Ironman-007/HexSense_Canary_Islands/Docs/images/Canary/WhatsApp Image 2024-02-13 at 19.08.08_4202beaf.jpg

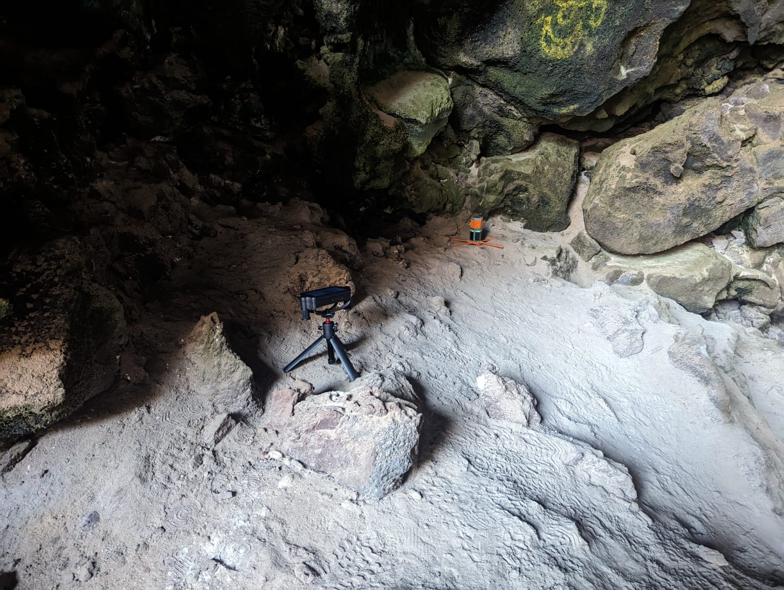
Docs/images/Canary/WhatsApp Image 2024-02-13 at 19.08.08_4202beaf.jpg
