Ironman-007/HexSense_Canary_Islands/Docs/images/Canary/hexsense.jpg

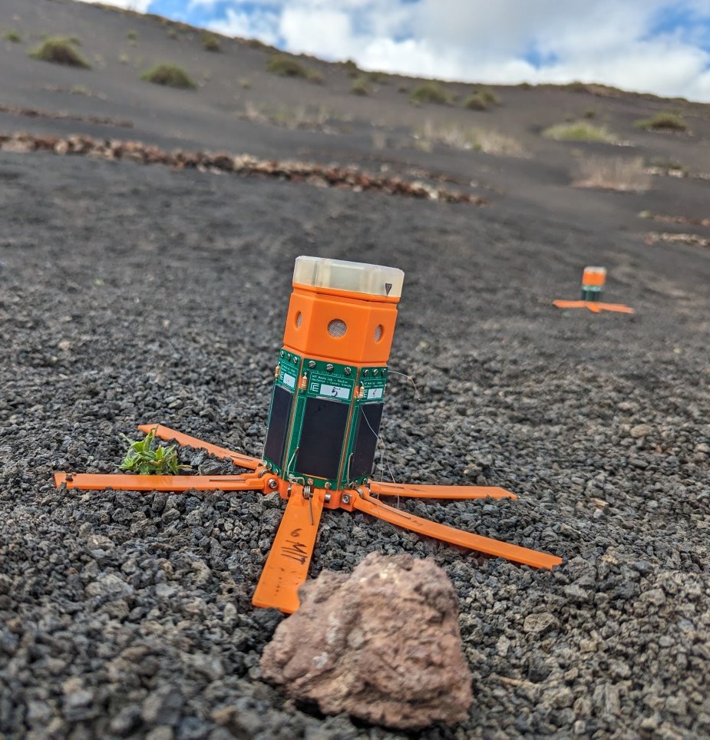
Docs/images/Canary/hexsense.jpg
