Ironman-007/HexSense_Canary_Islands/Docs/images/Canary/WhatsApp Image 2024-02-13 at 19.08.14_1cce6e4d.jpg

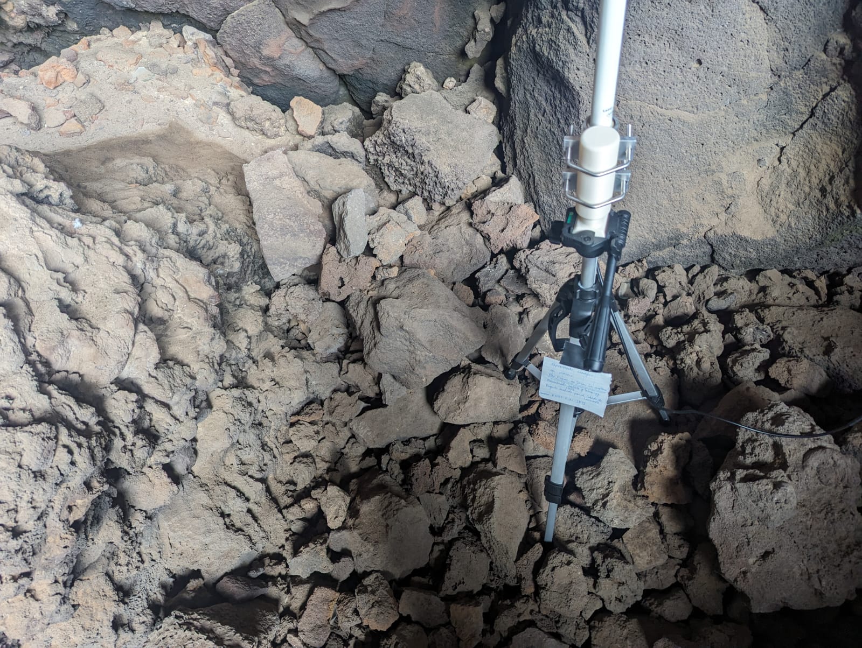
Docs/images/Canary/WhatsApp Image 2024-02-13 at 19.08.14_1cce6e4d.jpg
