Ironman-007/HexSense_Canary_Islands/Software/HEX2JPEG/1.jpg

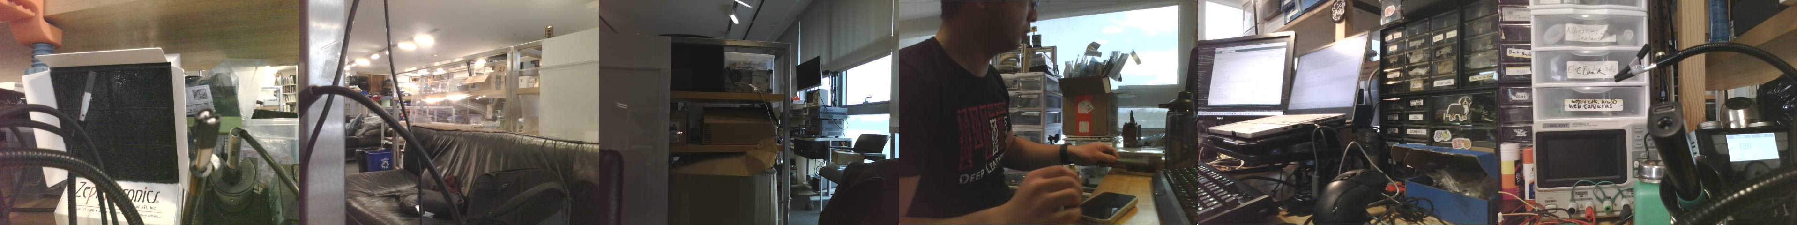
Software/HEX2JPEG/1.jpg
