Ironman-007/HexSense_Canary_Islands/Software/HEX2JPEG/me.jpg

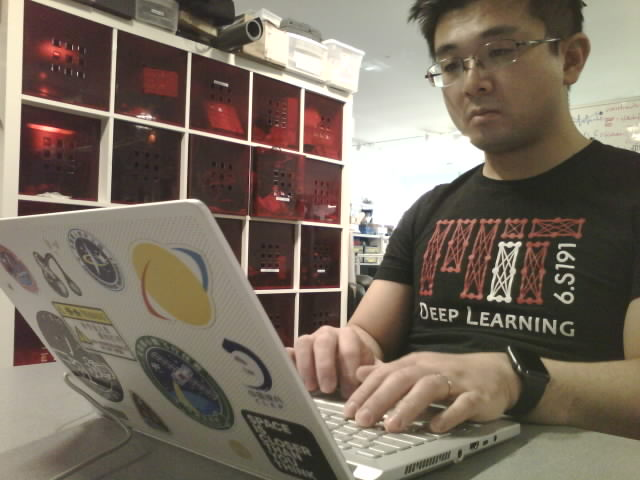
Software/HEX2JPEG/me.jpg
