Ironman-007/HexSense_Canary_Islands/Software/HEX2JPEG/output.jpg

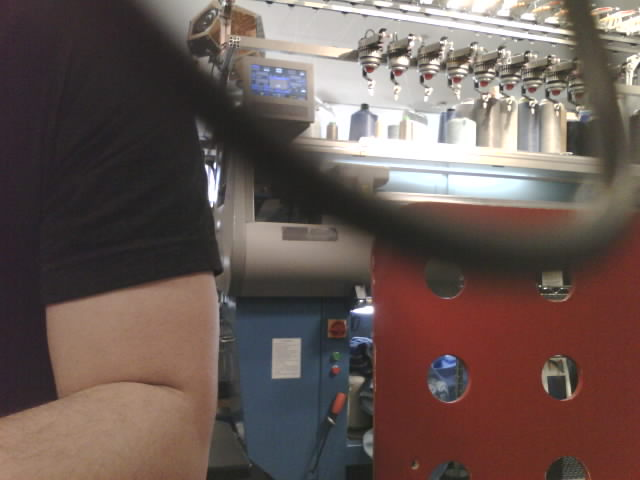
Software/HEX2JPEG/output.jpg
