Ironman-007/HexSense_Canary_Islands/Software/HEX2JPEG/tst.jpg

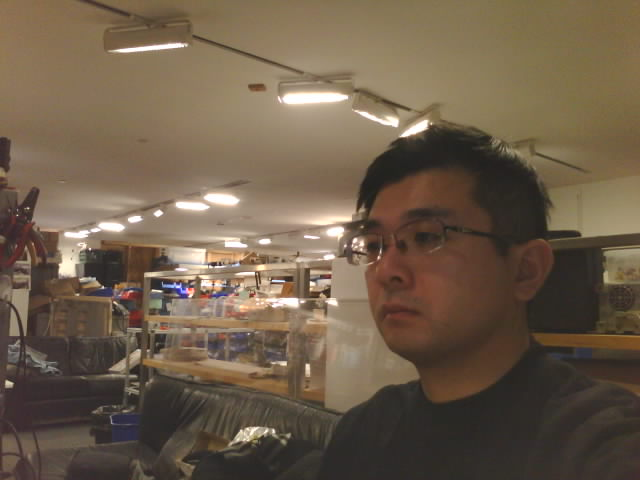
Software/HEX2JPEG/tst.jpg
