Ironman-007/HexSense_Canary_Islands/Software/HEX2JPEG/tst_photo/02.jpg

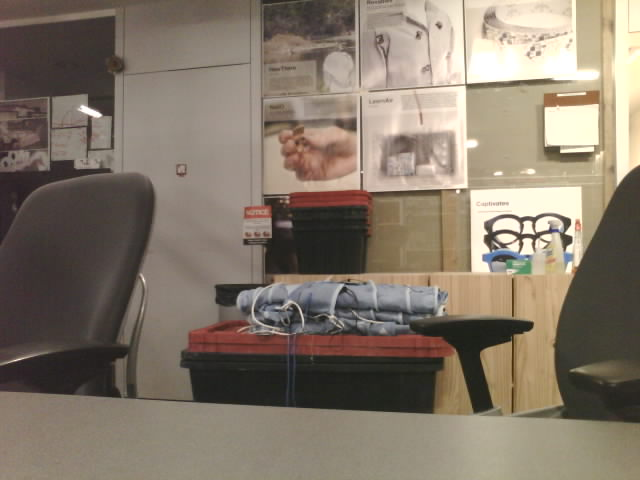
Software/HEX2JPEG/tst_photo/02.jpg
