Ironman-007/HexSense_Canary_Islands/Software/HEX2JPEG/tst_photo/03.jpg

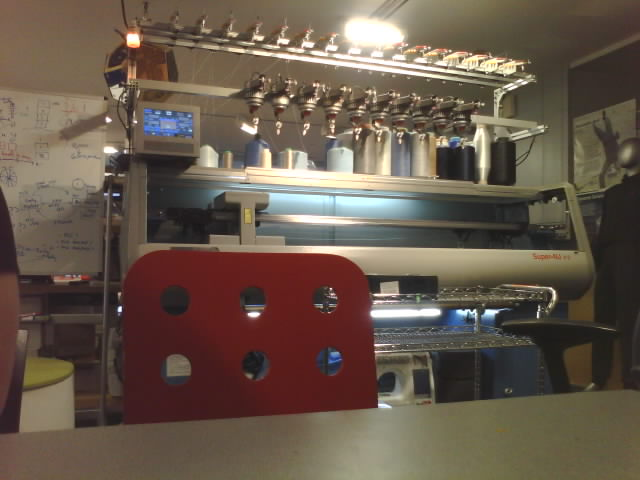
Software/HEX2JPEG/tst_photo/03.jpg
