Ironman-007/HexSense_Canary_Islands/Mechanical/Base/V1/Bottom_panel.STEP

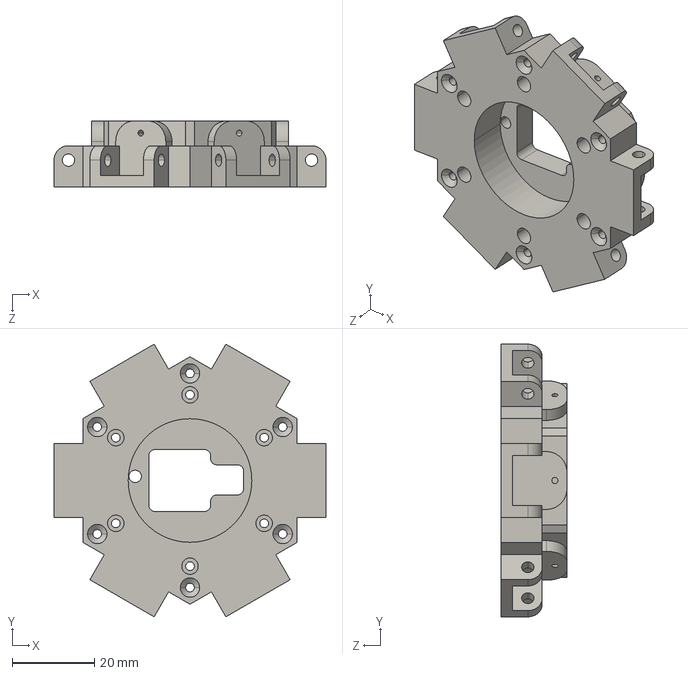
[picture p26: CAD file, 2024-01-19]
Mechanical/Base/V1/Bottom_panel.STEP
66.0 x 66.2 x 16.0 mm
