Ironman-007/HexSense_Canary_Islands/Mechanical/Base/V1/STL/base.stl

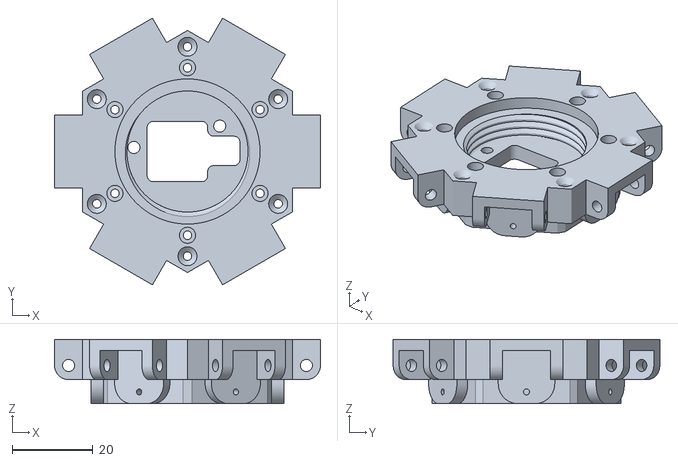
[picture p27: CAD file, 2024-01-26]
Mechanical/Base/V1/STL/base.stl
66.0 x 66.2 x 16.0
