Ironman-007/HexSense_Canary_Islands/Mechanical/Camera_module/camera_case_hexsense.stl

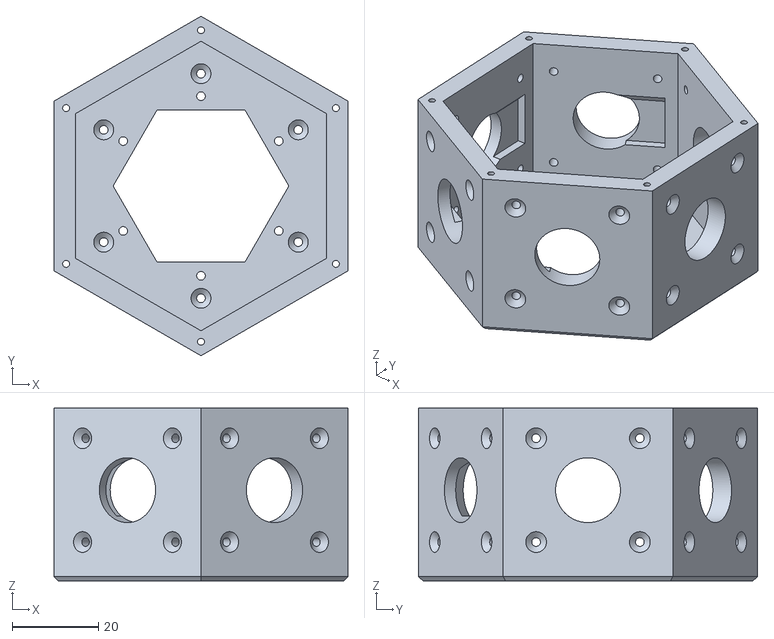
[picture p28: CAD file, 2024-01-22]
Mechanical/Camera_module/camera_case_hexsense.stl
68.0 x 78.5 x 40.0
