Ironman-007/HexSense_Canary_Islands/Mechanical/Env_module/SCD30--3DModel-STEP-56544.STEP

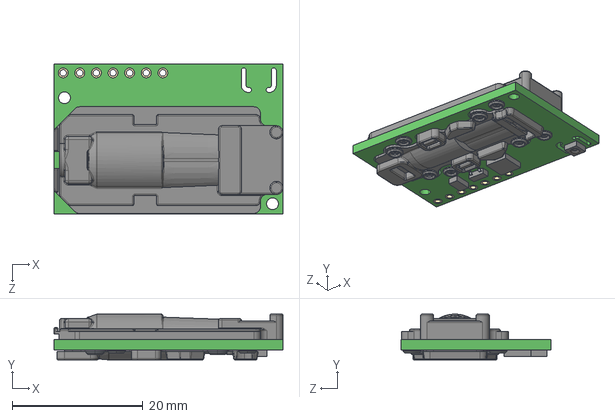
[picture p29: CAD file, 2024-02-02]
Mechanical/Env_module/SCD30--3DModel-STEP-56544.STEP
35.0 x 7.00 x 23.0 mm
