Ironman-007/HexSense_Canary_Islands/Mechanical/STL/3MF/camera_frame_lid.3mf

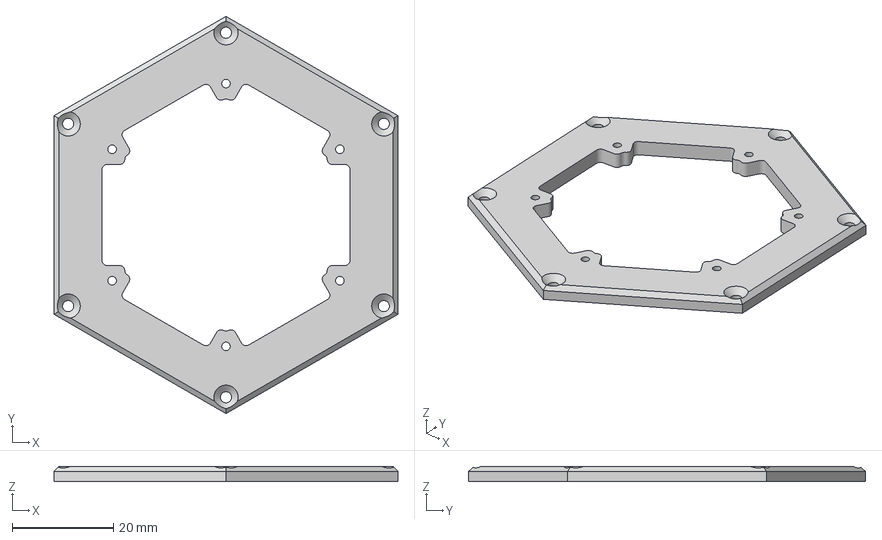
[picture p30: CAD file, 2024-05-07]
Mechanical/STL/3MF/camera_frame_lid.3mf
68.0 x 78.5 x 3.00 mm
