Ironman-007/HexSense_Canary_Islands/Mechanical/STL/insertholder.stl

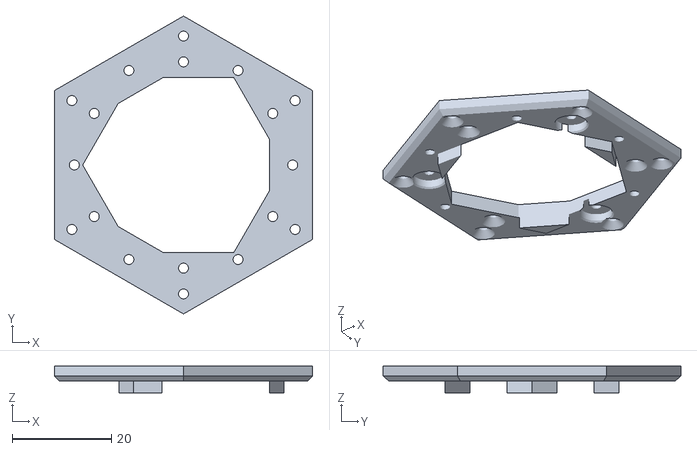
[picture p31: CAD file, 2025-03-31]
Mechanical/STL/insertholder.stl
52.0 x 60.0 x 5.40
