Ironman-007/HexSense_Canary_Islands/PCB/CAMERA_ADAPTER/CAMERA_ADAPTER.step

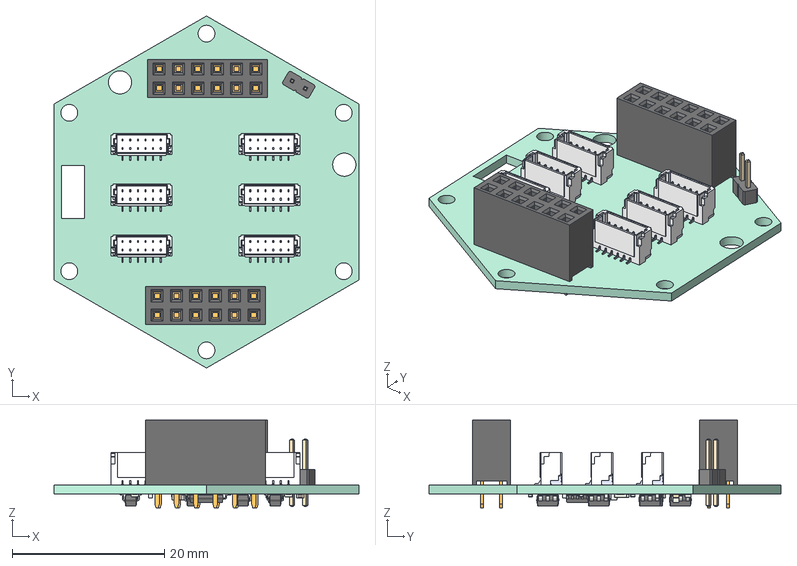
[picture p32: CAD file, 2024-01-24]
PCB/CAMERA_ADAPTER/CAMERA_ADAPTER.step
40.0 x 46.2 x 11.5 mm
Local_CS_efd9
Pcb_efd9
PCB_Sketch_efd9
BMxxB-SRSS-TB(LF)(SN)_06 x 6
BMxxB-SRSS-TB(LF)(SN)_007 x 6
BMxxB-SRSS-TB(LF)(SN)_008 x 6
BMxxB-SRSS-TB(LF)(SN)_009 x 6
BMxxB-SRSS-TB(LF)(SN)_010 x 6
BMxxB-SRSS-TB(LF)(SN)_011 x 6
BMxxB-SRSS-TB(LF)(SN)_012 x 6
BMxxB-SRSS-TB(LF)(SN)_013 x 6
BMxxB-SRSS-TB(LF)(SN)_014 x 6
BMxxB-SRSS-TB(LF)(SN)_015 x 6
BMxxB-SRSS-TB(LF)(SN)_016 x 6
BMxxB-SRSS-TB(LF)(SN)_017 x 6
BMxxB-SRSS-TB(LF)(SN)_018 x 6
BMxxB-SRSS-TB(LF)(SN)_019 x 6
BMxxB-SRSS-TB(LF)(SN)_020 x 6
BMxxB-SRSS-TB(LF)(SN)_021 x 6
BMxxB-SRSS-TB(LF)(SN)_022 x 6
BMxxB-SRSS-TB(LF)(SN)_023 x 6
BMxxB-SRSS-TB(LF)(SN)_024 x 6
BMxxB-SRSS-TB(LF)(SN)_025 x 6
BMxxB-SRSS-TB(LF)(SN)_026 x 6
J1_ZL262-12D_P2-54_L15-74_W5_H8-5_6bbc479e31c9 x 2
J9_PinHeader_1x02_P200mm_Vertical_a4282987b0e2
R10_R_0402_1005Metric_74f1f346494a x 7
D1_LED_0603_1608Metric_ddd619ef1d35
U4_SOT_23_5_20c4610e354d x 8
C9_C_0402_1005Metric_d579c78d45ee x 7
R1_R_0603_1608Metric_368b4ec6add9 x 4
U2_TSSOP_16_44x5mm_P065mm_39492d668841
C1_C_0603_1608Metric_cccacc02c318 x 2
