Ironman-007/HexSense_Canary_Islands/PCB/LORA/LORA.step

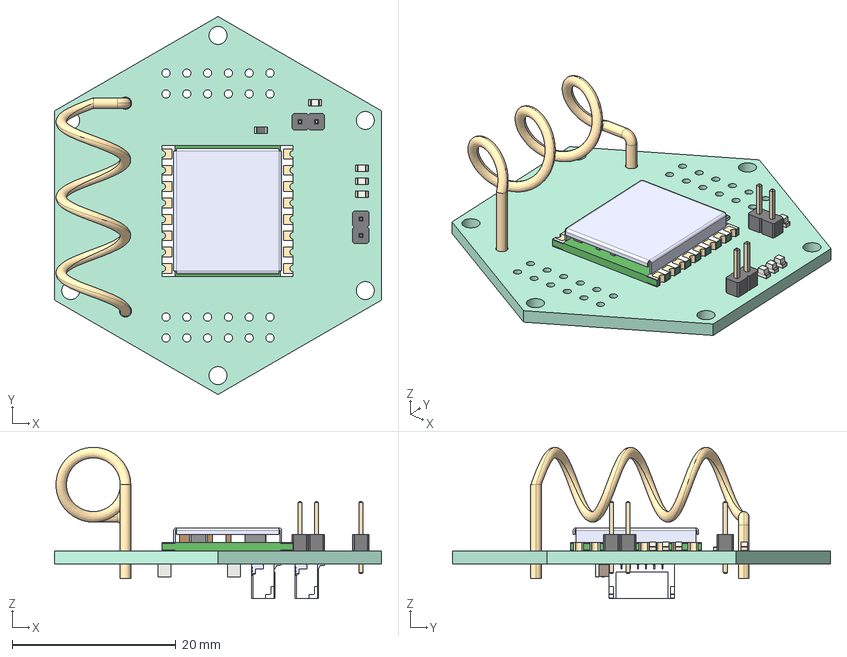
[picture p33: CAD file, 2024-02-02]
PCB/LORA/LORA.step
40.0 x 46.2 x 18.5 mm
Local_CS_200a
Pcb_200a
PCB_Sketch_200a
D2_LED_0603_1608Metric_a726e19f2e95 x 4
U2_ANT-916-HESM_a0ccab9f46fa
J5_PinHeader_1x02_P200mm_Vertical_732df0b8f1e6 x 2
R3_R_0603_1608Metric_ca6557afc463
RFM95CW
RFM95CW001
RFM95CW002
RFM95CW003
RFM95CW004
RFM95CW005
RFM95CW006
RFM95CW007
RFM95CW008
RFM95CW009
RFM95CW010
RFM95CW011
RFM95CW012
RFM95CW013
RFM95CW014
RFM95CW015
RFM95CW016
RFM95CW017
RFM95CW018
RFM95CW019
RFM95CW020
RFM95CW021
RFM95CW022
RFM95CW023
RFM95CW024
RFM95CW025
RFM95CW026
RFM95CW027
RFM95CW028
RFM95CW029
RFM95CW030
RFM95CW031
BMxxB-SRSS-TB(LF)(SN)_06 x 2
BMxxB-SRSS-TB(LF)(SN)_007 x 2
BMxxB-SRSS-TB(LF)(SN)_008 x 2
BMxxB-SRSS-TB(LF)(SN)_009 x 2
BMxxB-SRSS-TB(LF)(SN)_010 x 2
BMxxB-SRSS-TB(LF)(SN)_011 x 2
BMxxB-SRSS-TB(LF)(SN)_012 x 2
BMxxB-SRSS-TB(LF)(SN)_013 x 2
BMxxB-SRSS-TB(LF)(SN)_014 x 2
BMxxB-SRSS-TB(LF)(SN)_015 x 2
BMxxB-SRSS-TB(LF)(SN)_016 x 2
BMxxB-SRSS-TB(LF)(SN)_017 x 2
BMxxB-SRSS-TB(LF)(SN)_018 x 2
BMxxB-SRSS-TB(LF)(SN)_019 x 2
BMxxB-SRSS-TB(LF)(SN)_020 x 2
BMxxB-SRSS-TB(LF)(SN)_021 x 2
BMxxB-SRSS-TB(LF)(SN)_022 x 2
BMxxB-SRSS-TB(LF)(SN)_023 x 2
BMxxB-SRSS-TB(LF)(SN)_024 x 2
BMxxB-SRSS-TB(LF)(SN)_025 x 2
BMxxB-SRSS-TB(LF)(SN)_026 x 2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
