Ironman-007/HexSense_Canary_Islands/PCB/LORA_ADAPTER/LORA_ADAPTER.step

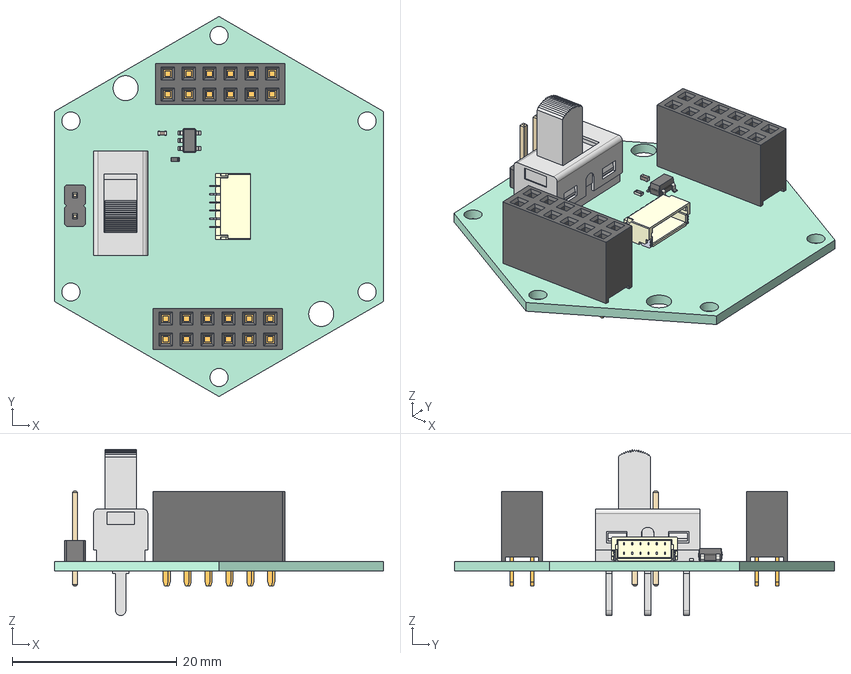
[picture p34: CAD file, 2024-01-25]
PCB/LORA_ADAPTER/LORA_ADAPTER.step
40.0 x 46.2 x 20.2 mm
Local_CS_573e
Pcb_573e
PCB_Sketch_573e
SM06B-SRSS-TB(LF)(SN)
SM06B-SRSS-TB(LF)(SN)001
SM06B-SRSS-TB(LF)(SN)002
SM06B-SRSS-TB(LF)(SN)003
SM06B-SRSS-TB(LF)(SN)004
SM06B-SRSS-TB(LF)(SN)005
SM06B-SRSS-TB(LF)(SN)006
SM06B-SRSS-TB(LF)(SN)007
SM06B-SRSS-TB(LF)(SN)008
U9_SOT_23_5_92a4e90208c5
J1_ZL262-12D_P2-54_L15-74_W5_H8-5_6bbc479e31c9 x 2
R1_R_0402_1005Metric_368b4ec6add9
J4_PinHeader_1x02_P254mm_Vertical_c40bb610ca54
S1_P:\\E-Switch Secure\\3D_MODELS_STP_FORMAT\\500SSPxS2M2xEA.stp_6b039ad39aae
C9_C_0402_1005Metric_82bf13511e2f
