Ironman-007/HexSense_Canary_Islands/PCB/MCU/V1/MCU1-MCU.step

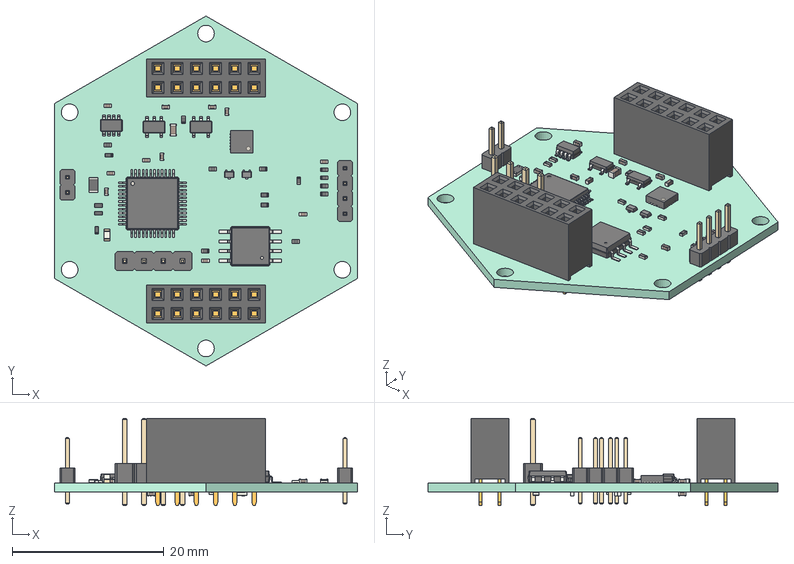
[picture p35: CAD file, 2024-01-18]
PCB/MCU/V1/MCU1-MCU.step
40.0 x 46.2 x 11.5 mm
Local_CS_d33
Pcb_d33
PCB_Sketch_d33
C7_C_0402_1005Metric_fb53f08dae77 x 15
R15_R_0402_1005Metric_2e6ba7737984 x 19
U4_TSOT_23_5_1c47d66d0b90 x 2
J1_ZL262-12D_P2-54_L15-74_W5_H8-5_6bbc479e31c9 x 2
C9_C_0603_1608Metric_bcf6387c43dd
U3_SOT_23_8_3f22a8c5597a
R19_R_0805_2012Metric_d9e47614d9fc
U2_TQFP_48_7x7mm_P05mm_701e66f97476
J4_PinHeader_1x04_P254mm_Vertical_2619d679aa0a
DTC115EMT2L x 2
DTC115EMT2L001 x 2
DTC115EMT2L002 x 2
DTC115EMT2L003 x 2
U5_QFN-24-1EP_3x3mm_Pitch0.4mm_12acc835fdfd
J6_PinHeader_1x04_P200mm_Vertical_9fa6987b58f1
U1_SSOP_8_525x524mm_P127mm_4f8737a89f74
D1_LED_0603_1608Metric_83a4edea2a74
J5_PinHeader_1x02_P200mm_Vertical_9449f0b80344
R20_R_0603_1608Metric_31454b58707b
