Ironman-007/HexSense_Canary_Islands/PCB/SIDE/V1/SIDE.step

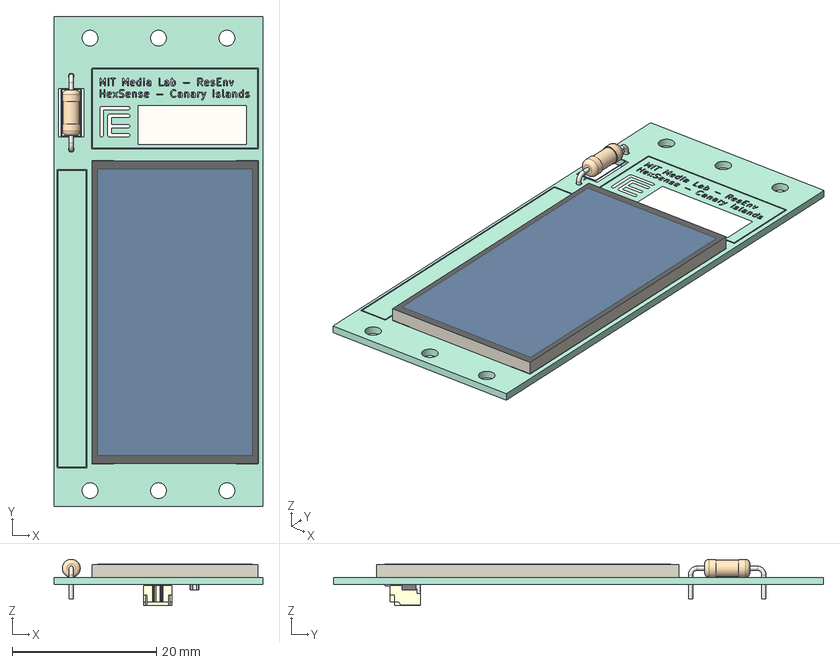
[picture p36: CAD file, 2024-01-23]
PCB/SIDE/V1/SIDE.step
29.0 x 68.0 x 6.45 mm
Local_CS_b4b2
Pcb_b4b2
PCB_Sketch_b4b2
topSilks_87f0
SC2_Part 1_4863a58bc153
R6_R_Axial_DIN0207_L63mm_D25mm_P1016mm_Horizontal_2c17a1b4c26e
SM02B-SRSS-TB(LF)(SN)
SM02B-SRSS-TB(LF)(SN)001
SM02B-SRSS-TB(LF)(SN)002
SM02B-SRSS-TB(LF)(SN)003
SM02B-SRSS-TB(LF)(SN)004
D1_D_0805_c4761f91ea4f
