Ironman-007/HexSense_Canary_Islands/Mechanical/Base/V1/Bottom_panel_thread_M14X2 v1.step

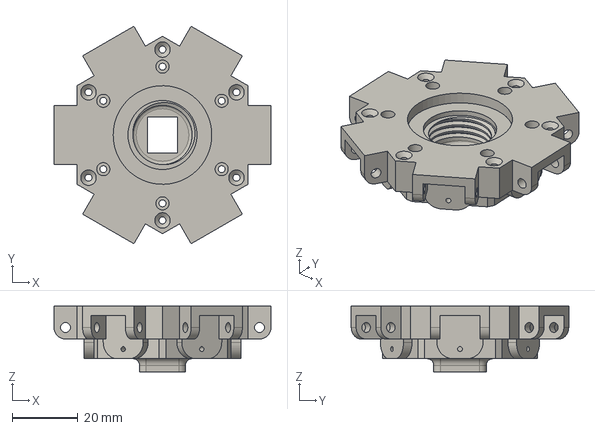
[picture p37: CAD file, 2024-01-19]
Mechanical/Base/V1/Bottom_panel_thread_M14X2 v1.step
66.0 x 66.2 x 20.0 mm
