Ironman-007/HexSense_Canary_Islands/Mechanical/STL/3MF/camera_module_frame.3mf

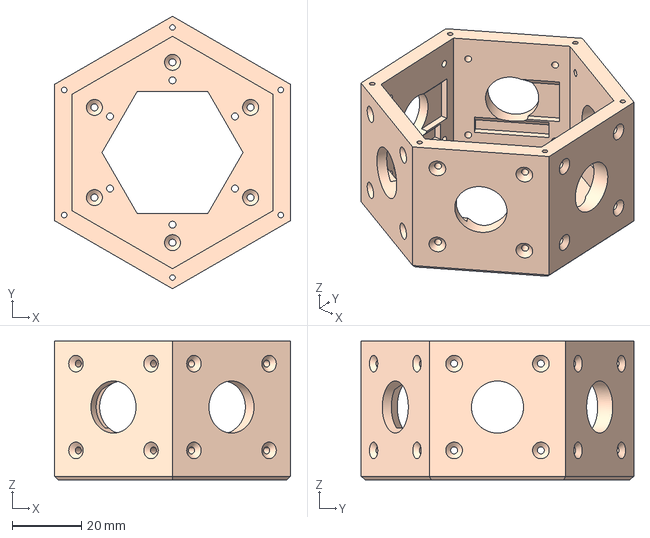
[picture p38: CAD file, 2024-02-16]
Mechanical/STL/3MF/camera_module_frame.3mf
68.0 x 78.5 x 40.0 mm
