Ironman-007/HexSense_Canary_Islands/Mechanical/STL/magholder.stl

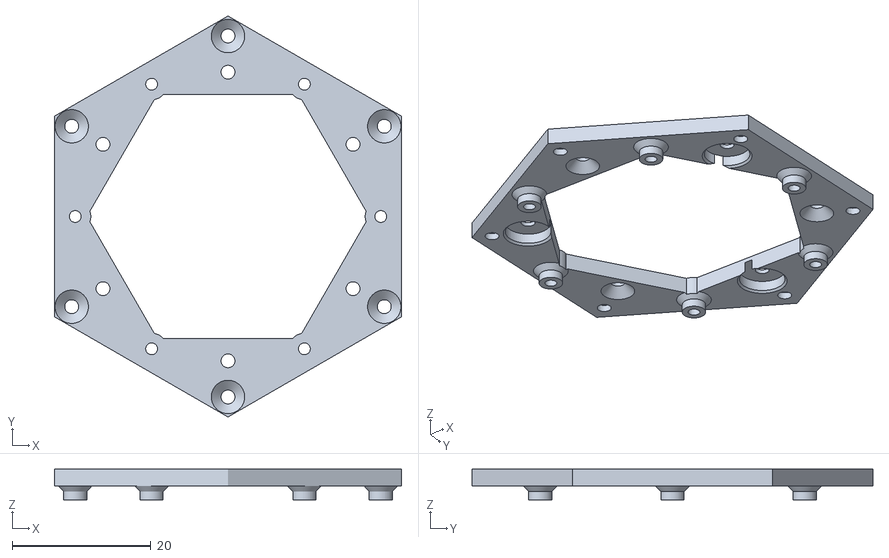
[picture p39: CAD file, 2025-03-31]
Mechanical/STL/magholder.stl
50.0 x 57.7 x 4.40
