Ironman-007/HexSense_Canary_Islands/Mechanical/Base/V1/Frame.step

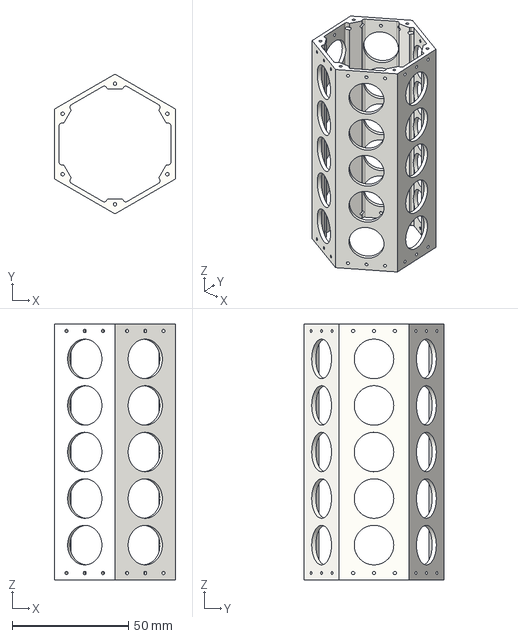
[picture p40: CAD file, 2024-01-19]
Mechanical/Base/V1/Frame.step
52.0 x 60.0 x 110.0 mm
