Ironman-007/HexSense_Canary_Islands/Mechanical/STL/3MF/spacer_5mm_M5.3mf

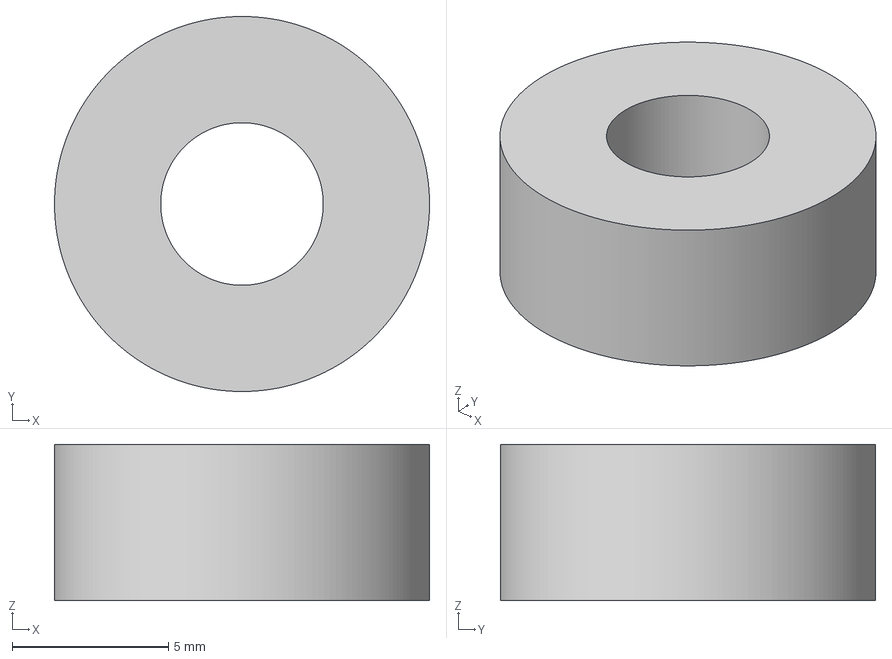
[picture p41: CAD file, 2024-02-12]
Mechanical/STL/3MF/spacer_5mm_M5.3mf
12.0 x 12.0 x 5.00 mm
