Ironman-007/HexSense_Canary_Islands/Mechanical/STL/Body1.3mf

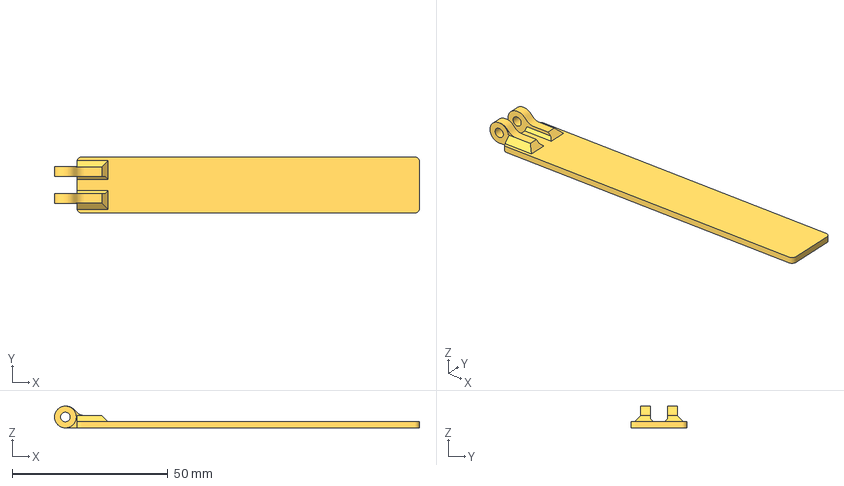
[picture p42: CAD file, 2024-02-09]
Mechanical/STL/Body1.3mf
117.2 x 18.0 x 7.00 mm
