Ironman-007/HexSense_Canary_Islands/Mechanical/STL/3MF/bottom_cap.3mf

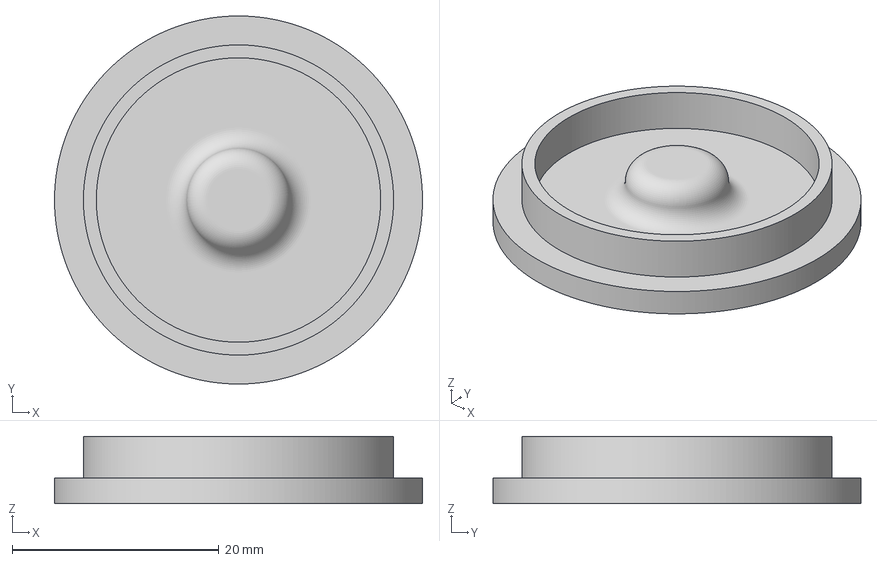
[picture p43: CAD file, 2024-02-12]
Mechanical/STL/3MF/bottom_cap.3mf
35.6 x 35.6 x 6.50 mm
