Ironman-007/HexSense_Canary_Islands/Mechanical/STL/jetsen_mount_adapter.3mf

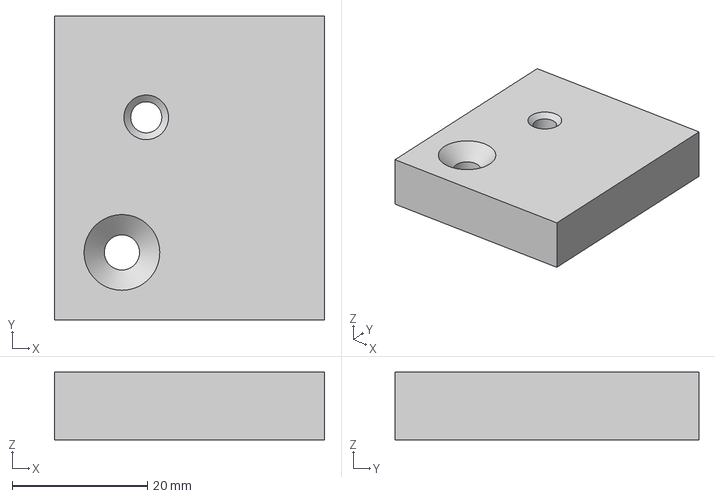
[picture p44: CAD file, 2024-02-09]
Mechanical/STL/jetsen_mount_adapter.3mf
40.0 x 45.0 x 10.0 mm
