Ironman-007/HexSense_Canary_Islands/Mechanical/STL/SCD30_holder.stl

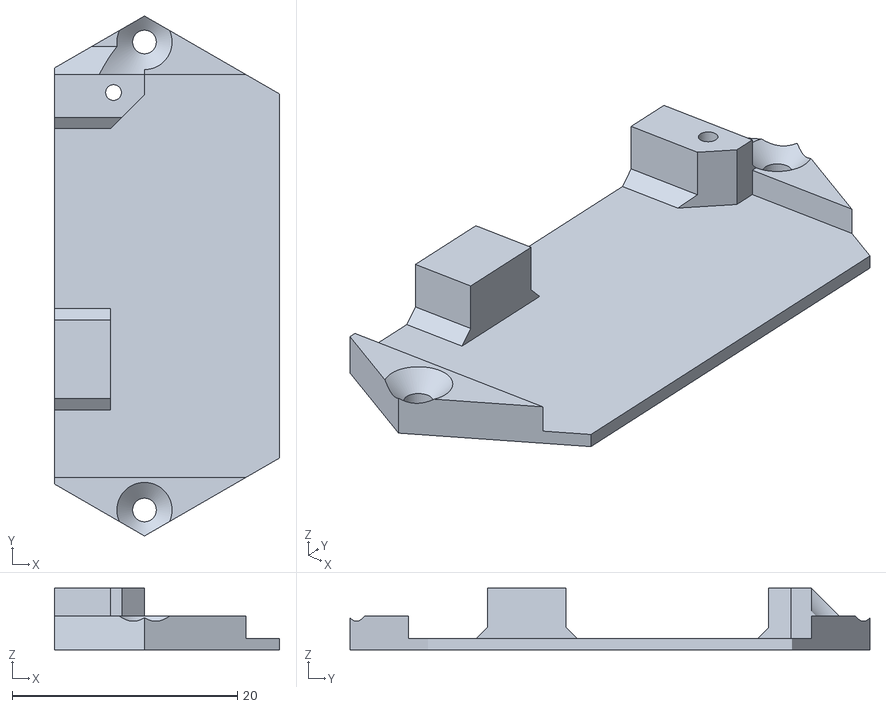
[picture p45: CAD file, 2024-02-02]
Mechanical/STL/SCD30_holder.stl
20.0 x 46.2 x 5.50
