Ironman-007/HexSense_Canary_Islands/Mechanical/STL/3MF/ant_container_lid.3mf

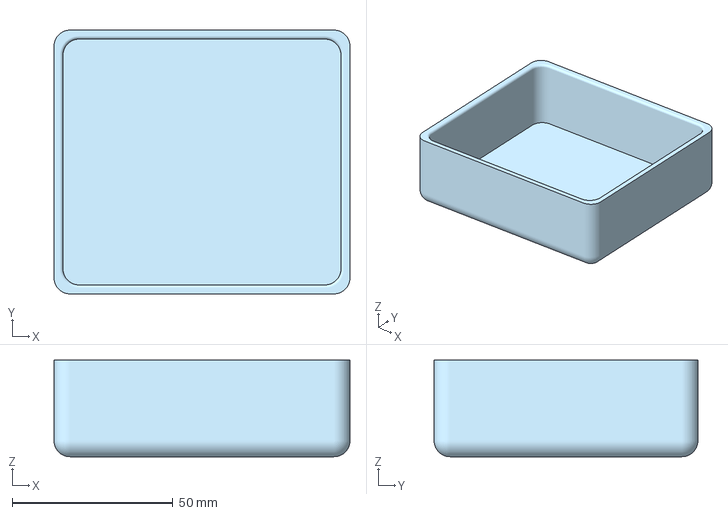
[picture p46: CAD file, 2024-02-10]
Mechanical/STL/3MF/ant_container_lid.3mf
92.0 x 82.0 x 30.0 mm
