Ironman-007/HexSense_Canary_Islands/Mechanical/STL/sensor_payload_frame.stl

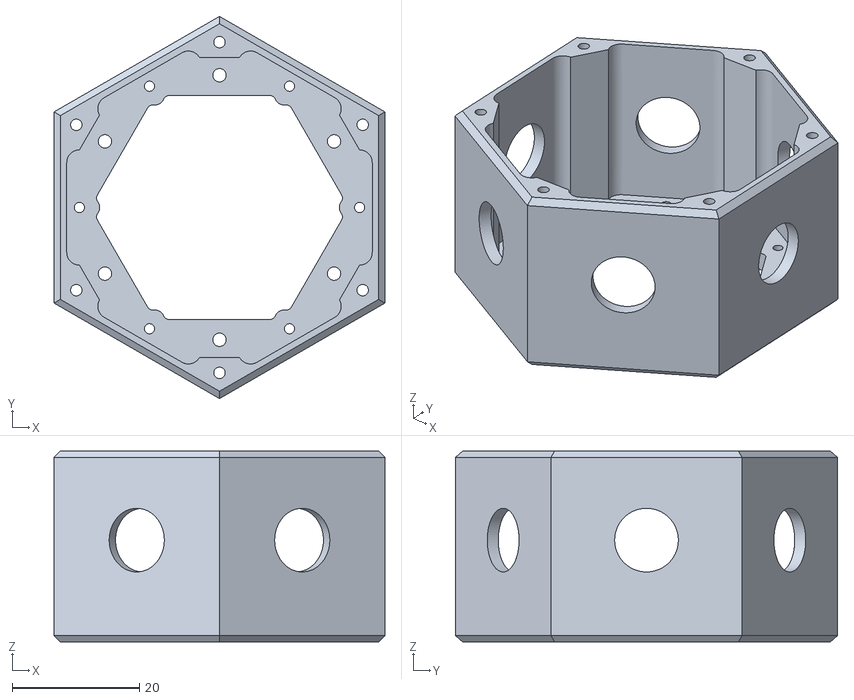
[picture p47: CAD file, 2024-02-02]
Mechanical/STL/sensor_payload_frame.stl
52.0 x 60.0 x 30.0
