Ironman-007/HexSense_Canary_Islands/Mechanical/STL/3MF/ant_container_box.3mf

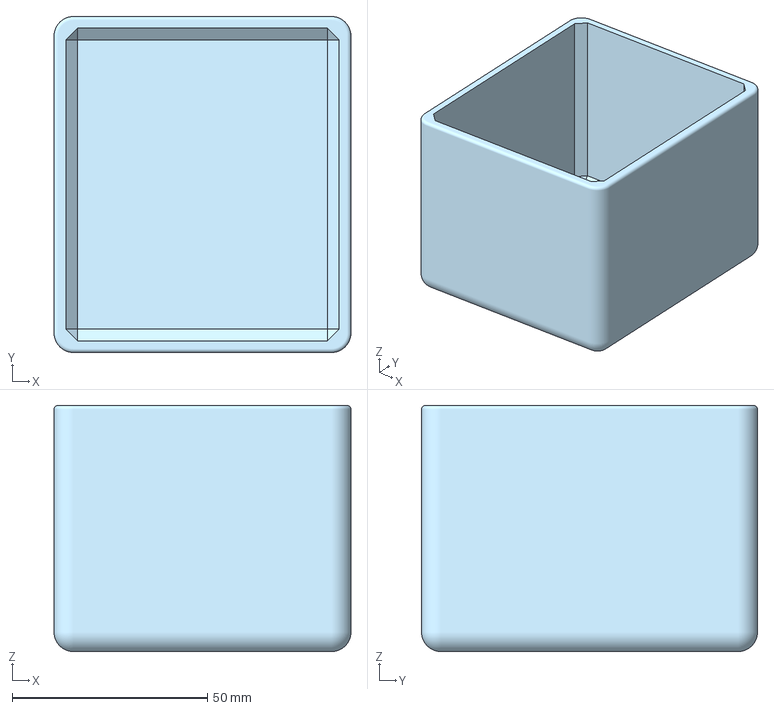
[picture p48: CAD file, 2024-02-10]
Mechanical/STL/3MF/ant_container_box.3mf
76.0 x 86.0 x 63.0 mm
