Ironman-007/HexSense_Canary_Islands/Mechanical/STL/lora_holder.stl

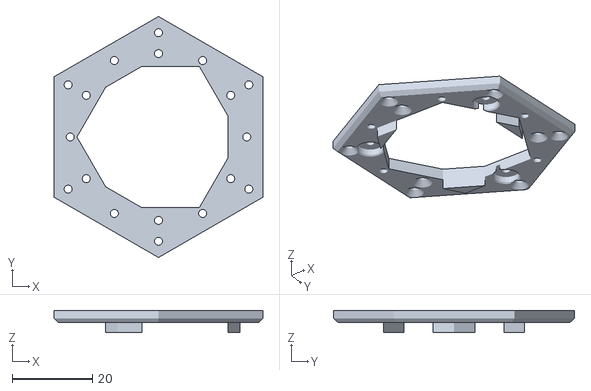
[picture p49: CAD file, 2024-02-02]
Mechanical/STL/lora_holder.stl
52.0 x 60.0 x 5.50
