Ironman-007/HexSense_Canary_Islands/Mechanical/STL/3MF/camera_mount_rear.3mf

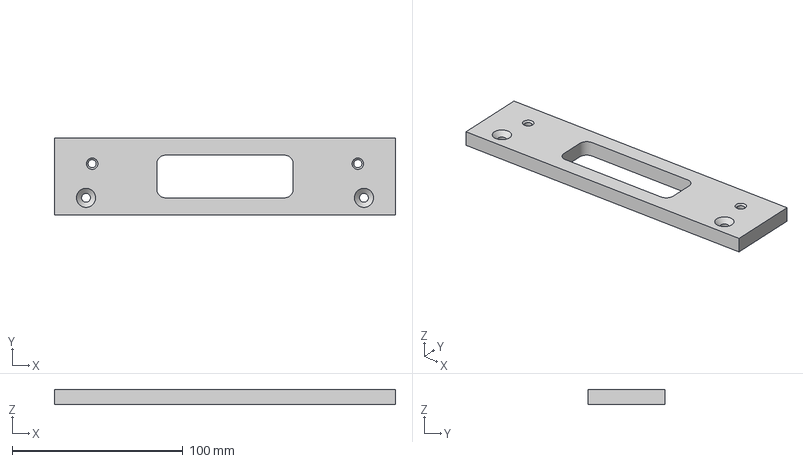
[picture p50: CAD file, 2024-02-09]
Mechanical/STL/3MF/camera_mount_rear.3mf
200.0 x 45.0 x 9.00 mm
