Ironman-007/HexSense_Canary_Islands/Mechanical/STL/base_frame.stl

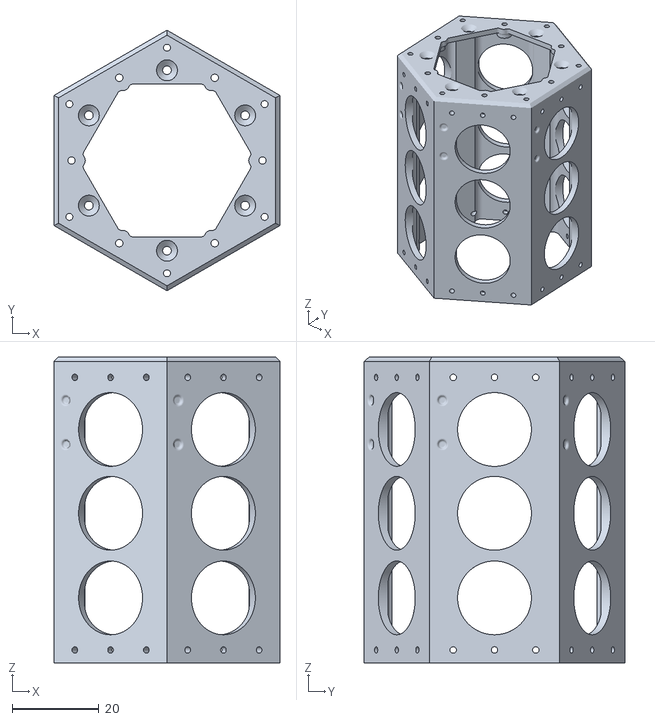
[picture p51: CAD file, 2024-02-02]
Mechanical/STL/base_frame.stl
52.0 x 60.0 x 70.5
