Ironman-007/HexSense_Canary_Islands/Mechanical/STL/3MF/camera_mount_front.3mf

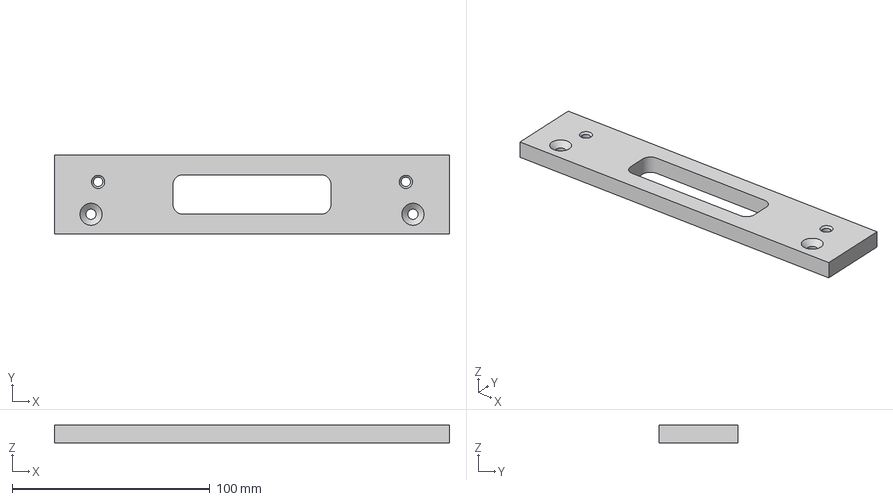
[picture p52: CAD file, 2024-02-09]
Mechanical/STL/3MF/camera_mount_front.3mf
200.0 x 40.0 x 9.00 mm
