Ironman-007/HexSense_Canary_Islands/Mechanical/STL/3MF/camera_mount_spacer.3mf

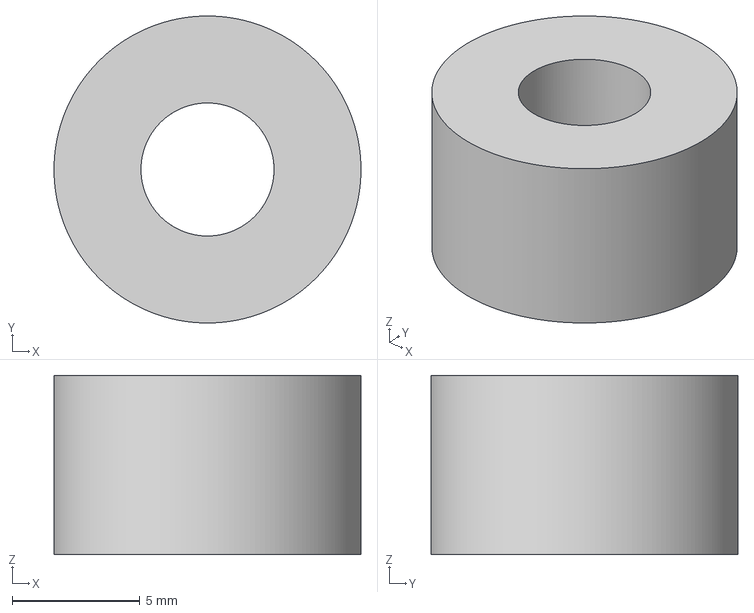
[picture p53: CAD file, 2024-02-09]
Mechanical/STL/3MF/camera_mount_spacer.3mf
12.0 x 12.0 x 7.00 mm
