Ironman-007/HexSense_Canary_Islands/Mechanical/STL/3MF/adapter2.3mf

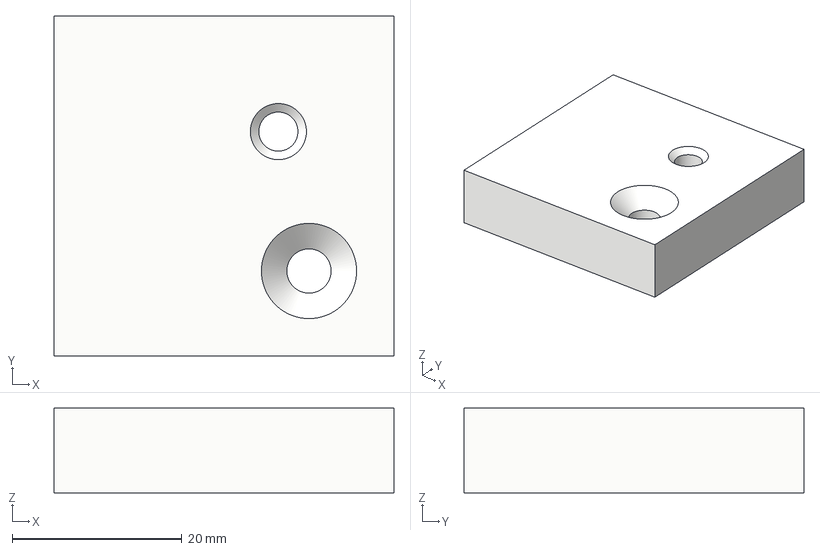
[picture p54: CAD file, 2024-02-09]
Mechanical/STL/3MF/adapter2.3mf
40.0 x 40.0 x 10.0 mm
