Ironman-007/HexSense_Canary_Islands/(list of files, cad)

Other CAD files:
Mechanical/Base/V1/HexSense_CanaryIsland_Base_V1.SLDASM
Mechanical/STL/paddle.3mf
Mechanical/STL/internal_magnet_holder.stl
Mechanical/STL/3MF/adapter1.3mf
Mechanical/STL/base.stl
Mechanical/STL/3MF/adapter4.3mf
Mechanical/STL/3MF/adapter3.3mf
Mechanical/Base/V1/Bottom_panel_thread_M14X2 v1.SLDPRT
Mechanical/Base/V1/STL/frame.stl
Mechanical/STL/3MF/90640_mount.3mf
Mechanical/STL/3MF/90640_mount_v2.3mf
PCB/PWR/V2/PWR-F_Silkscreen.dxf
PCB/SIDE/V1/SIDE-F_Silkscreen.dxf
