Ironman-007/HexSense_Canary_Islands/Docs/ArduCAM_API_flowchart.pdf

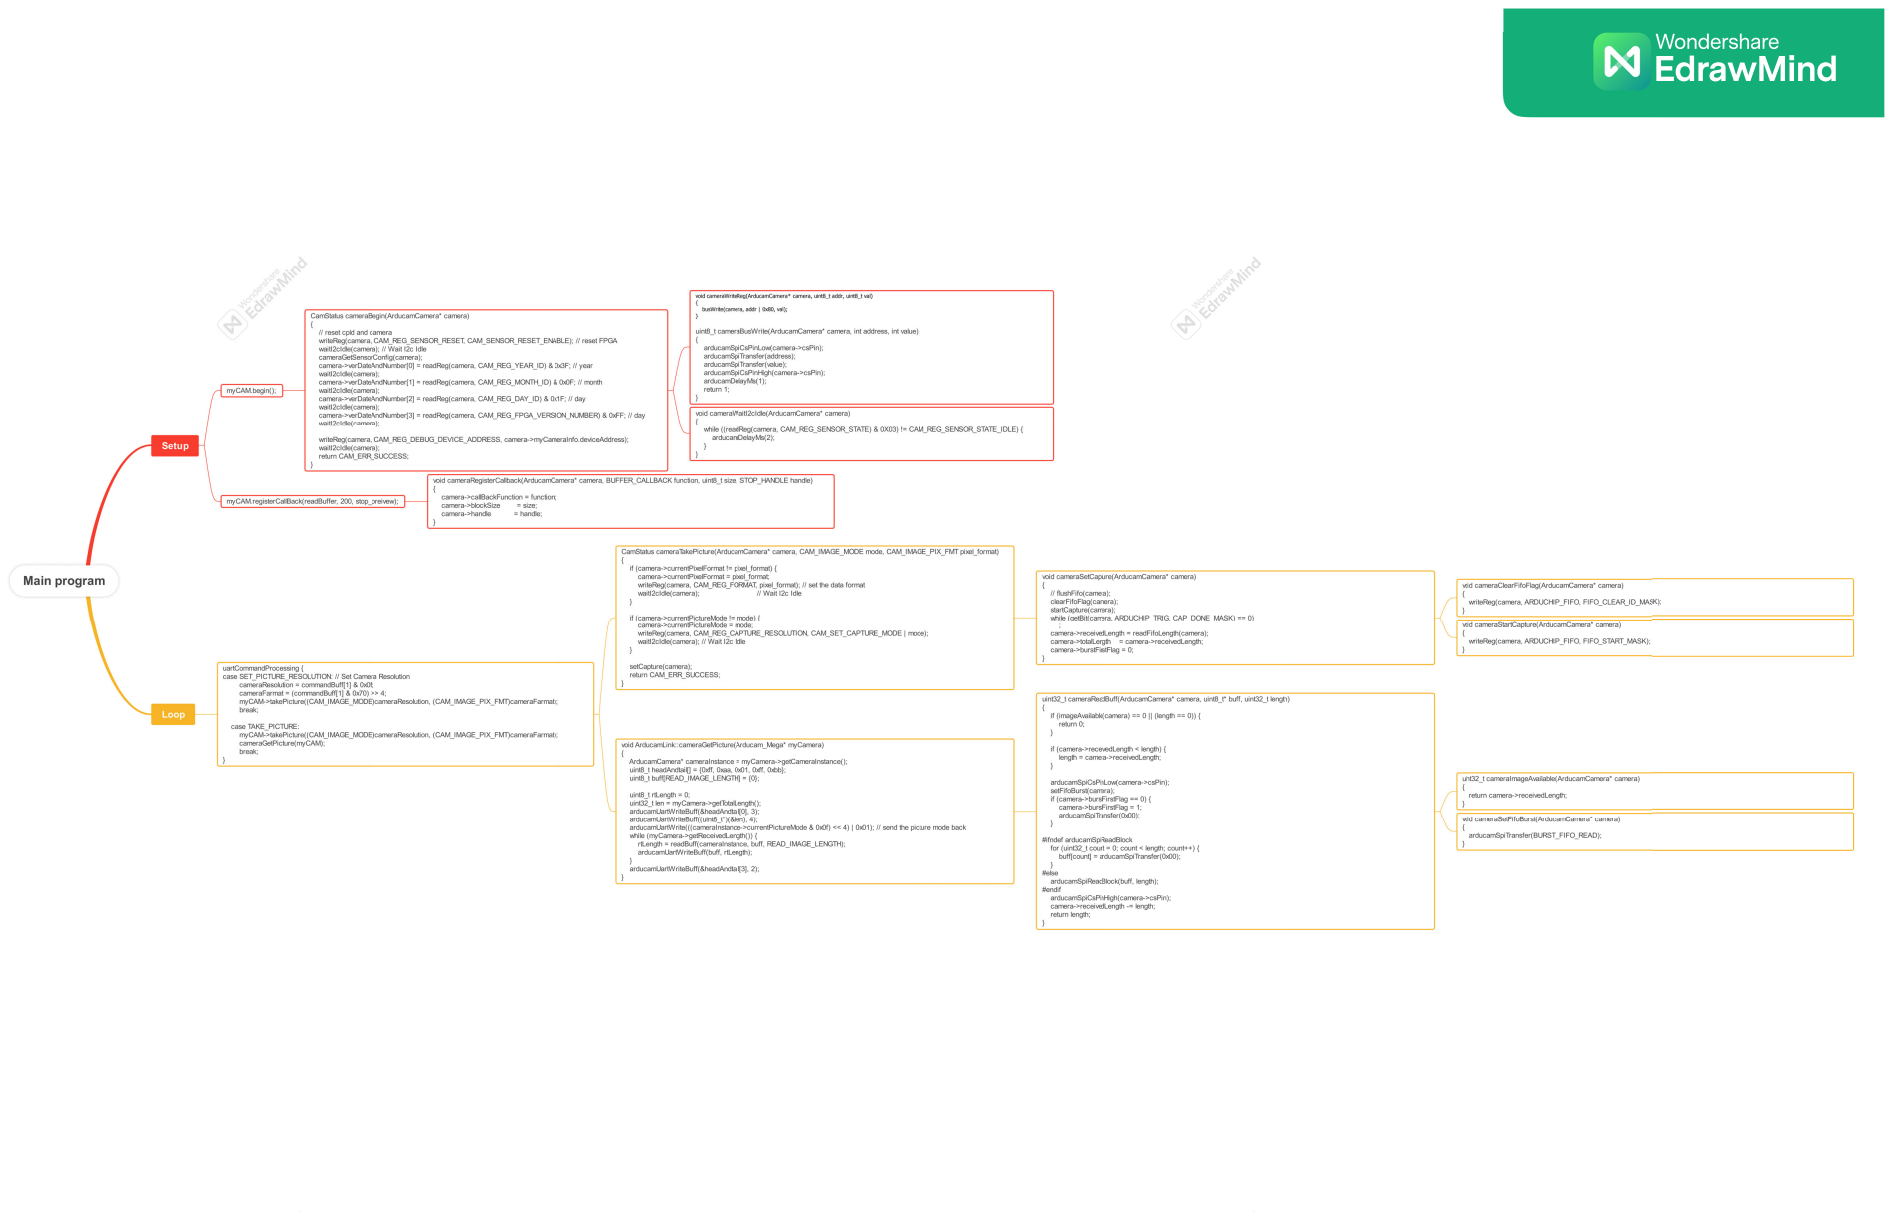
[picture p55: page 1]
