Ironman-007/HexSense_Canary_Islands/PCB/MCU/V3_ESP32S3/MCU.kicad_pcb

## KiCad design PCB/MCU/V3_ESP32S3/MCU.kicad_pcb (2025-04-02)

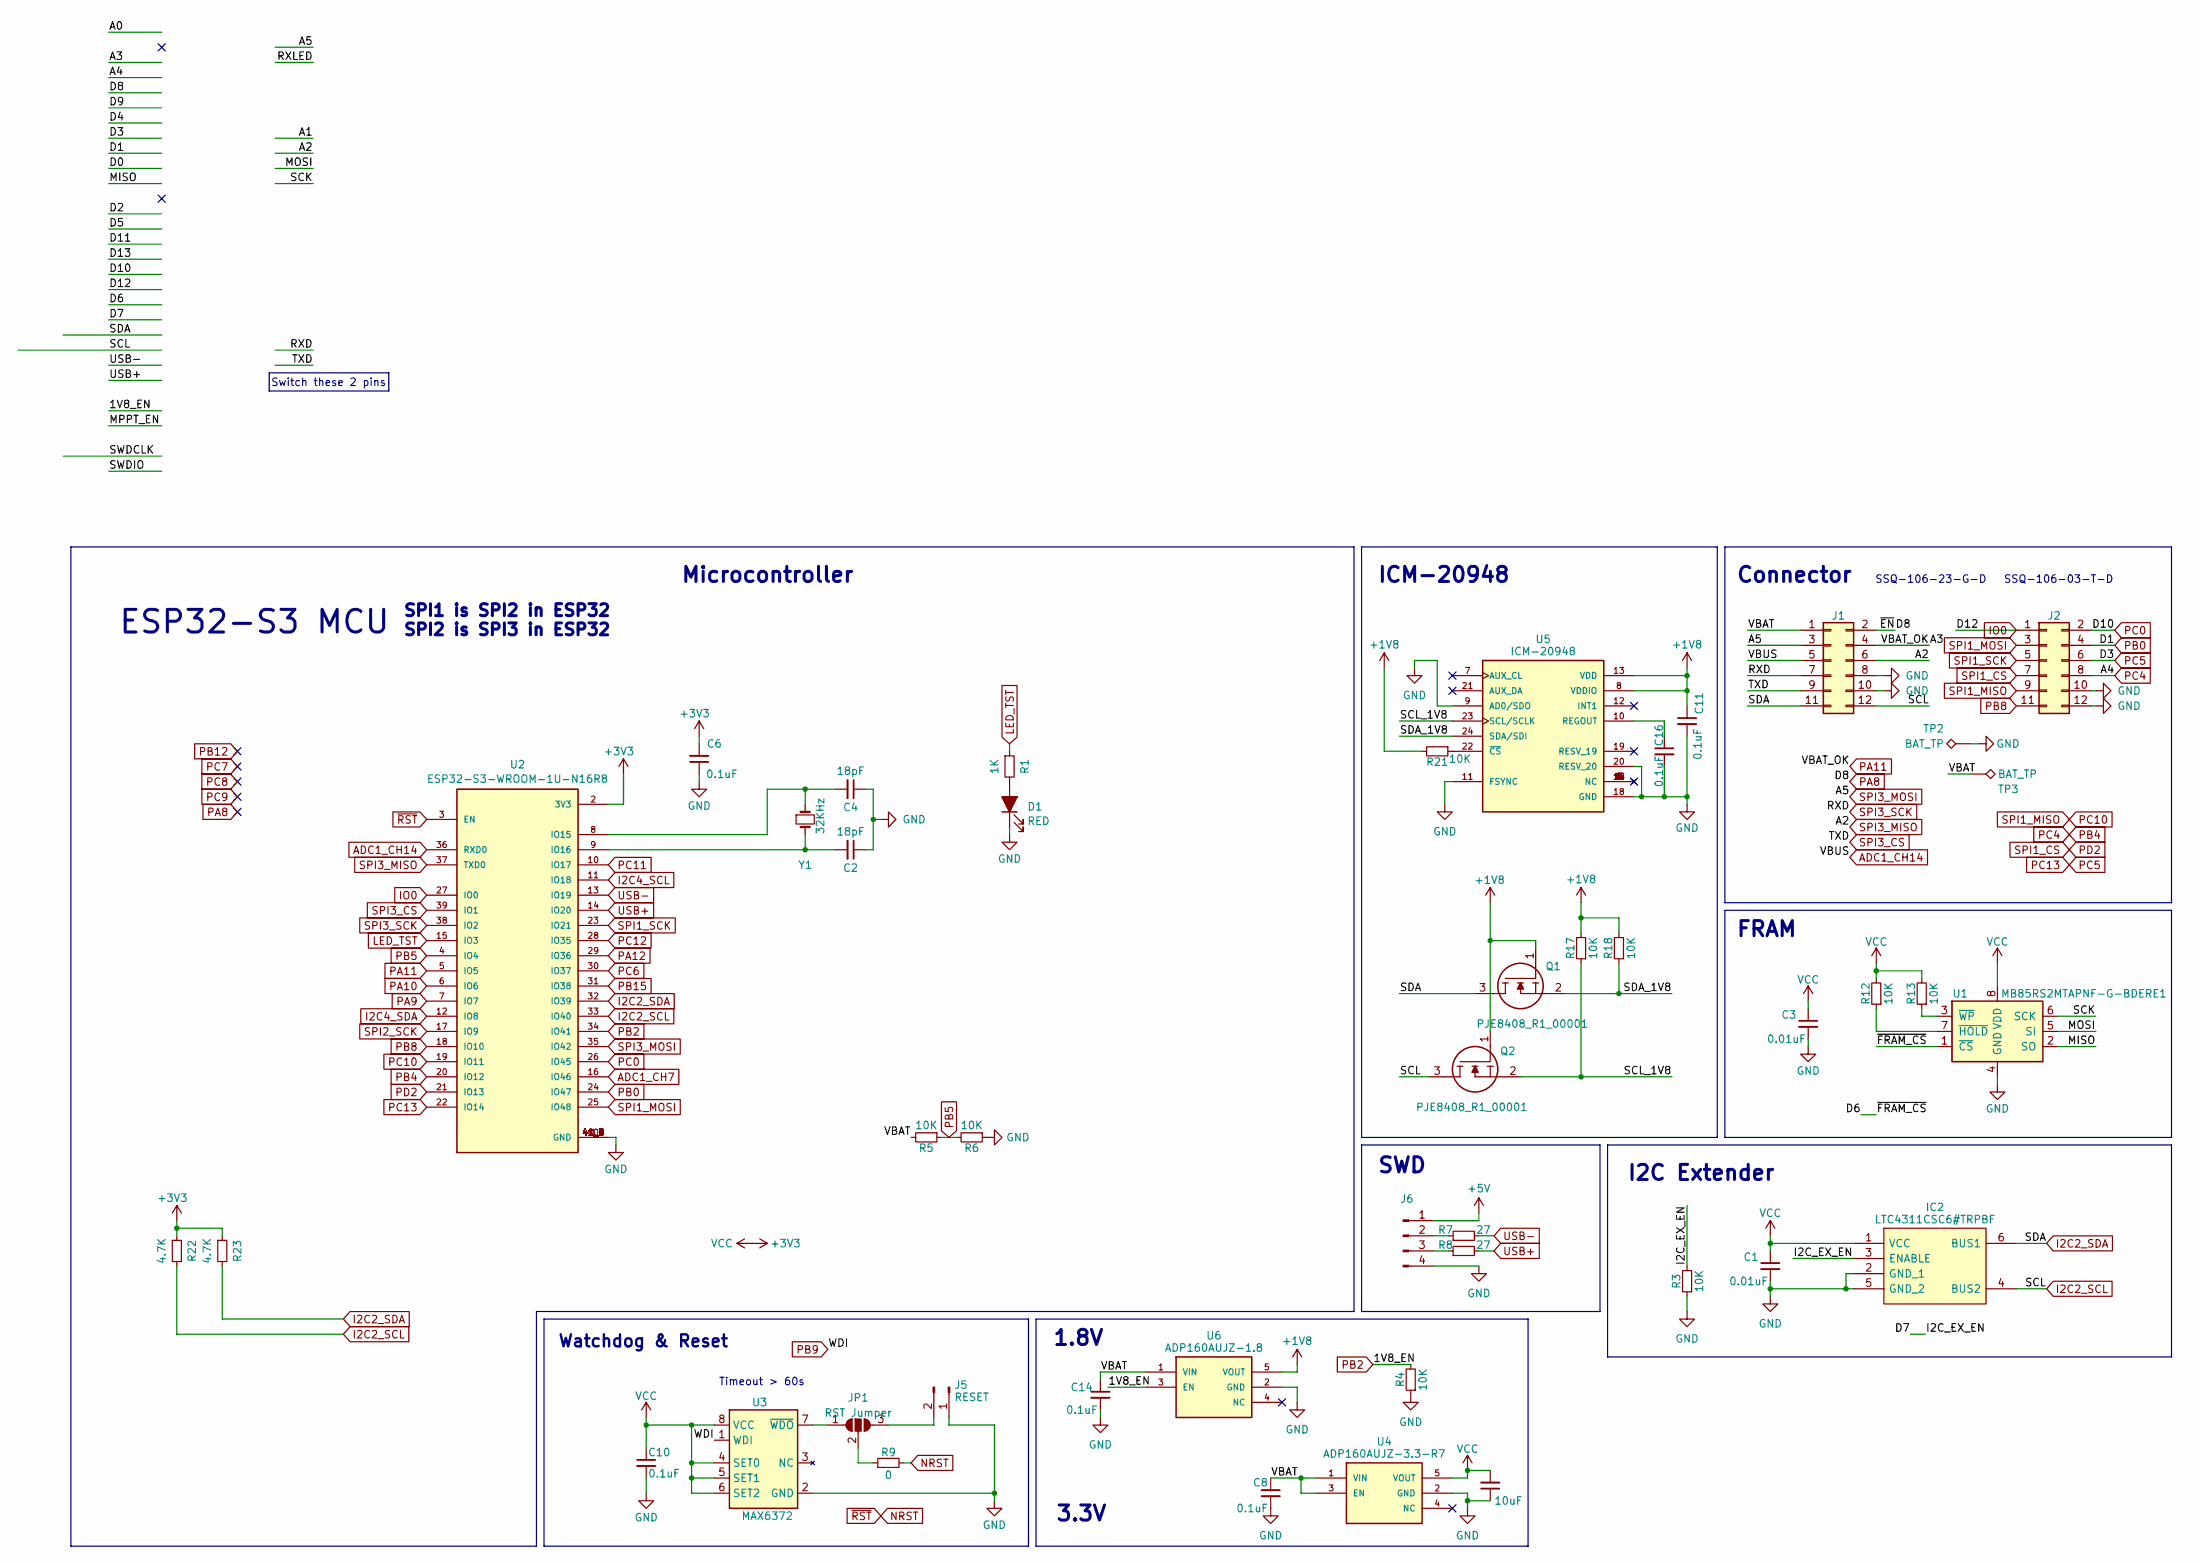
[picture p56: schematic MCU.kicad_sch, HexSense Svalbard - MCU module]

Parts:
C1, C3: 0.01uF; C_0402_1005Metric_Pad0.74x0.62mm_HandSolder
C2, C4: 18pF; C_0402_1005Metric_Pad0.74x0.62mm_HandSolder
C6, C8, C11, C14, C16: 0.1uF; C_0402_1005Metric_Pad0.74x0.62mm_HandSolder
C9: 10uF; C_0603_1608Metric_Pad1.08x0.95mm_HandSolder
C10: 0.1uF; C_0402_1005Metric
D1: RED; LED_0402_1005Metric_Pad0.77x0.64mm_HandSolder
IC2: LTC4311CSC6#TRPBF; SOT65P210X100-6N; Manufacturer_Part_Number LTC4311CSC6#TRPBF; Mouser Part Number 584-LTC4311CSC6TRPBF
J1, J2: Conn_02x06_Odd_Even; PinHeader_2x06_P2.54mm_Vertical
J5: RESET; PinHeader_1x02_P2.00mm_Vertical
J6: Conn_01x04_Pin; PinHeader_1x04_P2.00mm_Vertical
JP1: RST Jumper; SolderJumper-3_P1.3mm_Open_RoundedPad1.0x1.5mm
Q1, Q2: PJE8408_R1_00001; SOTFL50P160X60-3N; Manufacturer_Part_Number PJE8408_R1_00001; Mouser Part Number 241-PJE8408_R1_00001
R1: 1K; R_0402_1005Metric_Pad0.72x0.64mm_HandSolder
R3, R4, R5, R6, R12, R13, R17, R18, R21: 10K; R_0402_1005Metric_Pad0.72x0.64mm_HandSolder
R7, R8: 27; R_0402_1005Metric_Pad0.72x0.64mm_HandSolder
R9: 0; R_0201_0603Metric
R22, R23: 4.7K; R_0402_1005Metric_Pad0.72x0.64mm_HandSolder
TP2, TP3: BAT_TP; TestPoint_Pad_1.0x1.0mm
U1: MB85RS2MTAPNF-G-BDERE1; SSOP-8_5.25x5.24mm_P1.27mm
U2: ESP32-S3-WROOM-1U-N16R8; XCVR_ESP32-S3-WROOM-1U-N16R8; PARTREV v1.1
U3: MAX6372; SOT-23-8
U4: ADP160AUJZ-3.3-R7; TSOT-23-5; PARTREV H
U5: ICM-20948; InvenSense_QFN-24_3x3mm_P0.4mm; PARTREV 1.3
U6: ADP160AUJZ-1.8; TSOT-23-5; PARTREV H
Y1: 32KHz; Crystal_SMD_3215-2Pin_3.2x1.5mm

Connections:
+1V8: C11.1, Q1.1, Q2.1, R17.2, R18.2, R21.2, U5.8 (VDDIO), U5.13 (VDD), U6.5 (VOUT)
+3V3: C1.1, C3.1, C6.2, C9.2, C10.1, IC2.1 (VCC), R12.2, R13.2, R22.1, R23.1, U1.8 (VDD), U2.2 (3V3), U3.4 (SET0), U3.5 (SET1), U3.6 (SET2), U3.8 (VCC), U4.5 (VOUT)
+5V: J6.1
/D6: U1.1 (~CS)
/D7: IC2.3 (ENABLE), R3.2
/MISO: U1.2 (SO)
/MOSI: U1.5 (SI)
/SCK: U1.6 (SCK)
/SCL_1V8: Q2.2, R17.1, U5.23 (SCL/SCLK)
/SDA_1V8: Q1.2, R18.1, U5.24 (SDA/SDI)
/VBAT: C8.1, C14.1, J1.1, R5.2, TP3.1, U4.1 (VIN), U4.3 (EN), U6.1 (VIN)
ADC1_CH7: U2.16 (IO46)
ADC1_CH14: J1.5, U2.36 (RXD0)
GND: C1.2, C2.1, C3.2, C4.1, C6.1, C8.2, C9.1, C10.2, C11.2, C14.2, C16.2, D1.1 (K), IC2.2 (GND_1), IC2.5 (GND_2), J1.8, J1.10, J2.10, J2.12, J5.1, J6.4, R3.1, R4.1, R6.1, TP2.1, U1.4 (GND), U2.1 (GND), U2.40 (GND), U2.41_1 (GND), U2.41_2 (GND), U2.41_3 (GND), U2.41_4 (GND), U2.41_5 (GND), U2.41_6 (GND), U2.41_7 (GND), U2.41_8 (GND), U2.41_9 (GND), U3.2 (GND), U4.2 (GND), U5.9 (AD0/SDO), U5.11 (FSYNC), U5.18 (GND), U5.20 (RESV_20), U6.2 (GND)
I2C2_SCL: IC2.4 (BUS2), J1.12, Q2.3, R22.2, U2.33 (IO40)
I2C2_SDA: IC2.6 (BUS1), J1.11, Q1.3, R23.2, U2.32 (IO39)
I2C4_SCL: U2.11 (IO18)
I2C4_SDA: U2.12 (IO8)
IO0: J2.1, U2.27 (IO0)
LED_TST: R1.1, U2.15 (IO3)
NRST: R9.2, U2.3 (EN)
unnamed: D1.2 (A), R1.2
unnamed: J5.2, JP1.3 (B)
unnamed: J6.2, R7.1
unnamed: J6.3, R8.1
unnamed: JP1.1 (A), U3.7 (~WDO)
unnamed: JP1.2 (C), R9.1
unnamed: R12.1, U1.7 (~HOLD)
unnamed: R13.1, U1.3 (~WP)
unnamed: C4.2, U2.8 (IO15), Y1.1
unnamed: C2.2, U2.9 (IO16), Y1.2
unnamed: C16.1, U5.10 (REGOUT)
unnamed: R21.1, U5.22 (~CS)
PA8: J1.2
PA9: U2.7 (IO7)
PA10: U2.6 (IO6)
PA11: J1.4, U2.5 (IO5)
PA12: U2.29 (IO36)
PB0: J2.4, U2.24 (IO47)
PB2: R4.2, U2.34 (IO41), U6.3 (EN)
PB4: J2.8, U2.20 (IO12)
PB5: R5.1, R6.2, U2.4 (IO4)
PB8: J2.11, U2.18 (IO10)
PB9: U3.1 (WDI)
PB15: U2.31 (IO38)
PC0: J2.2, U2.26 (IO45)
PC6: U2.30 (IO37)
PC10: J2.9, U2.19 (IO11)
PC11: U2.10 (IO17)
PC12: U2.28 (IO35)
PC13: J2.6, U2.22 (IO14)
PD2: J2.7, U2.21 (IO13)
SPI1_MOSI: J2.3, U2.25 (IO48)
SPI1_SCK: J2.5, U2.23 (IO21)
SPI2_SCK: U2.17 (IO9)
SPI3_CS: J1.9, U2.39 (IO1)
SPI3_MISO: J1.6, U2.37 (TXD0)
SPI3_MOSI: J1.3, U2.35 (IO42)
SPI3_SCK: J1.7, U2.38 (IO2)
USB+: R8.2, U2.14 (IO20)
USB-: R7.2, U2.13 (IO19)

Notes on the sheet:
ICM-20948
SSQ-106-03-T-D
1.8V
SPI1 is SPI2 in ESP32 SPI2 is SPI3 in ESP32
Microcontroller
FRAM
Timeout > 60s
ESP32-S3 MCU
Watchdog & Reset
SWD
Connector
3.3V
Switch these 2 pins
SSQ-106-23-G-D
I2C Extender

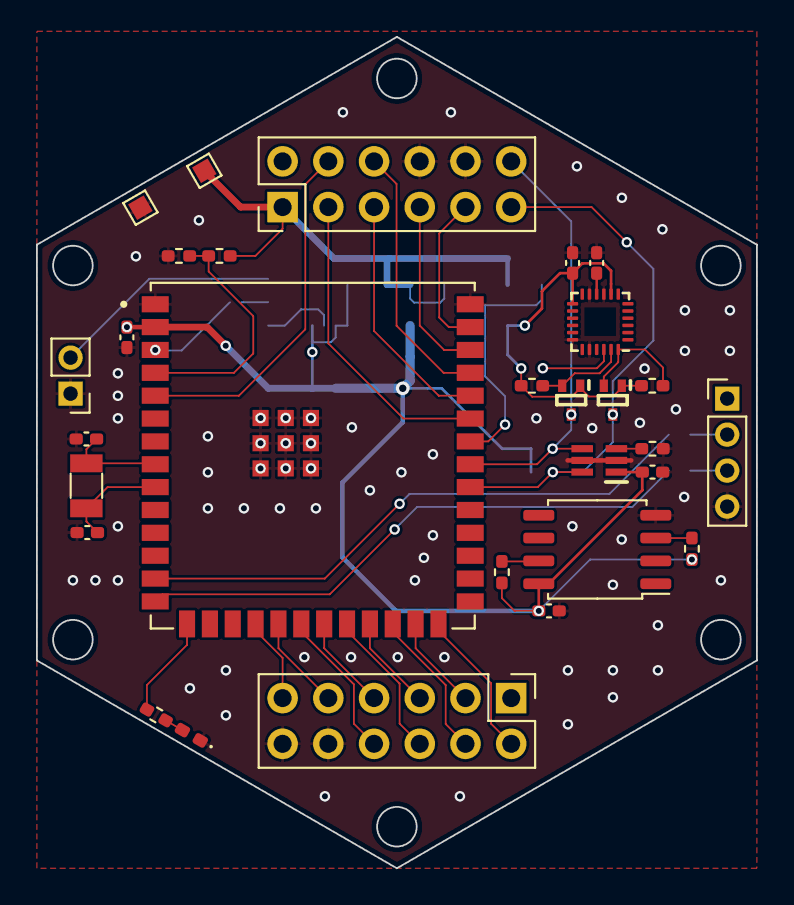
[picture p57: board PCB/MCU/V3_ESP32S3/MCU.kicad_pcb from above]

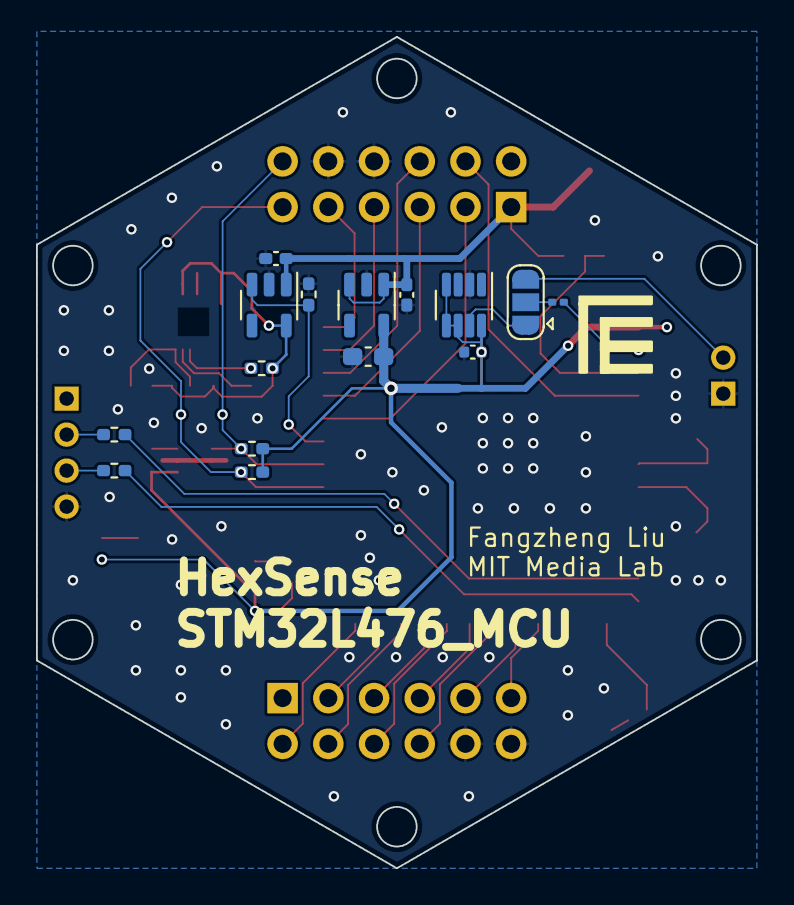
[picture p58: board PCB/MCU/V3_ESP32S3/MCU.kicad_pcb from below]

Board: 2 copper layers, 40.0 x 46.2 mm, 44 parts (15 on the bottom side), 43 nets.
