Ironman-007/HexSense_Canary_Islands/PCB/MCU/V2_STM32L476/MCU.kicad_pcb

## KiCad design PCB/MCU/V2_STM32L476/MCU.kicad_pcb (2025-04-02)

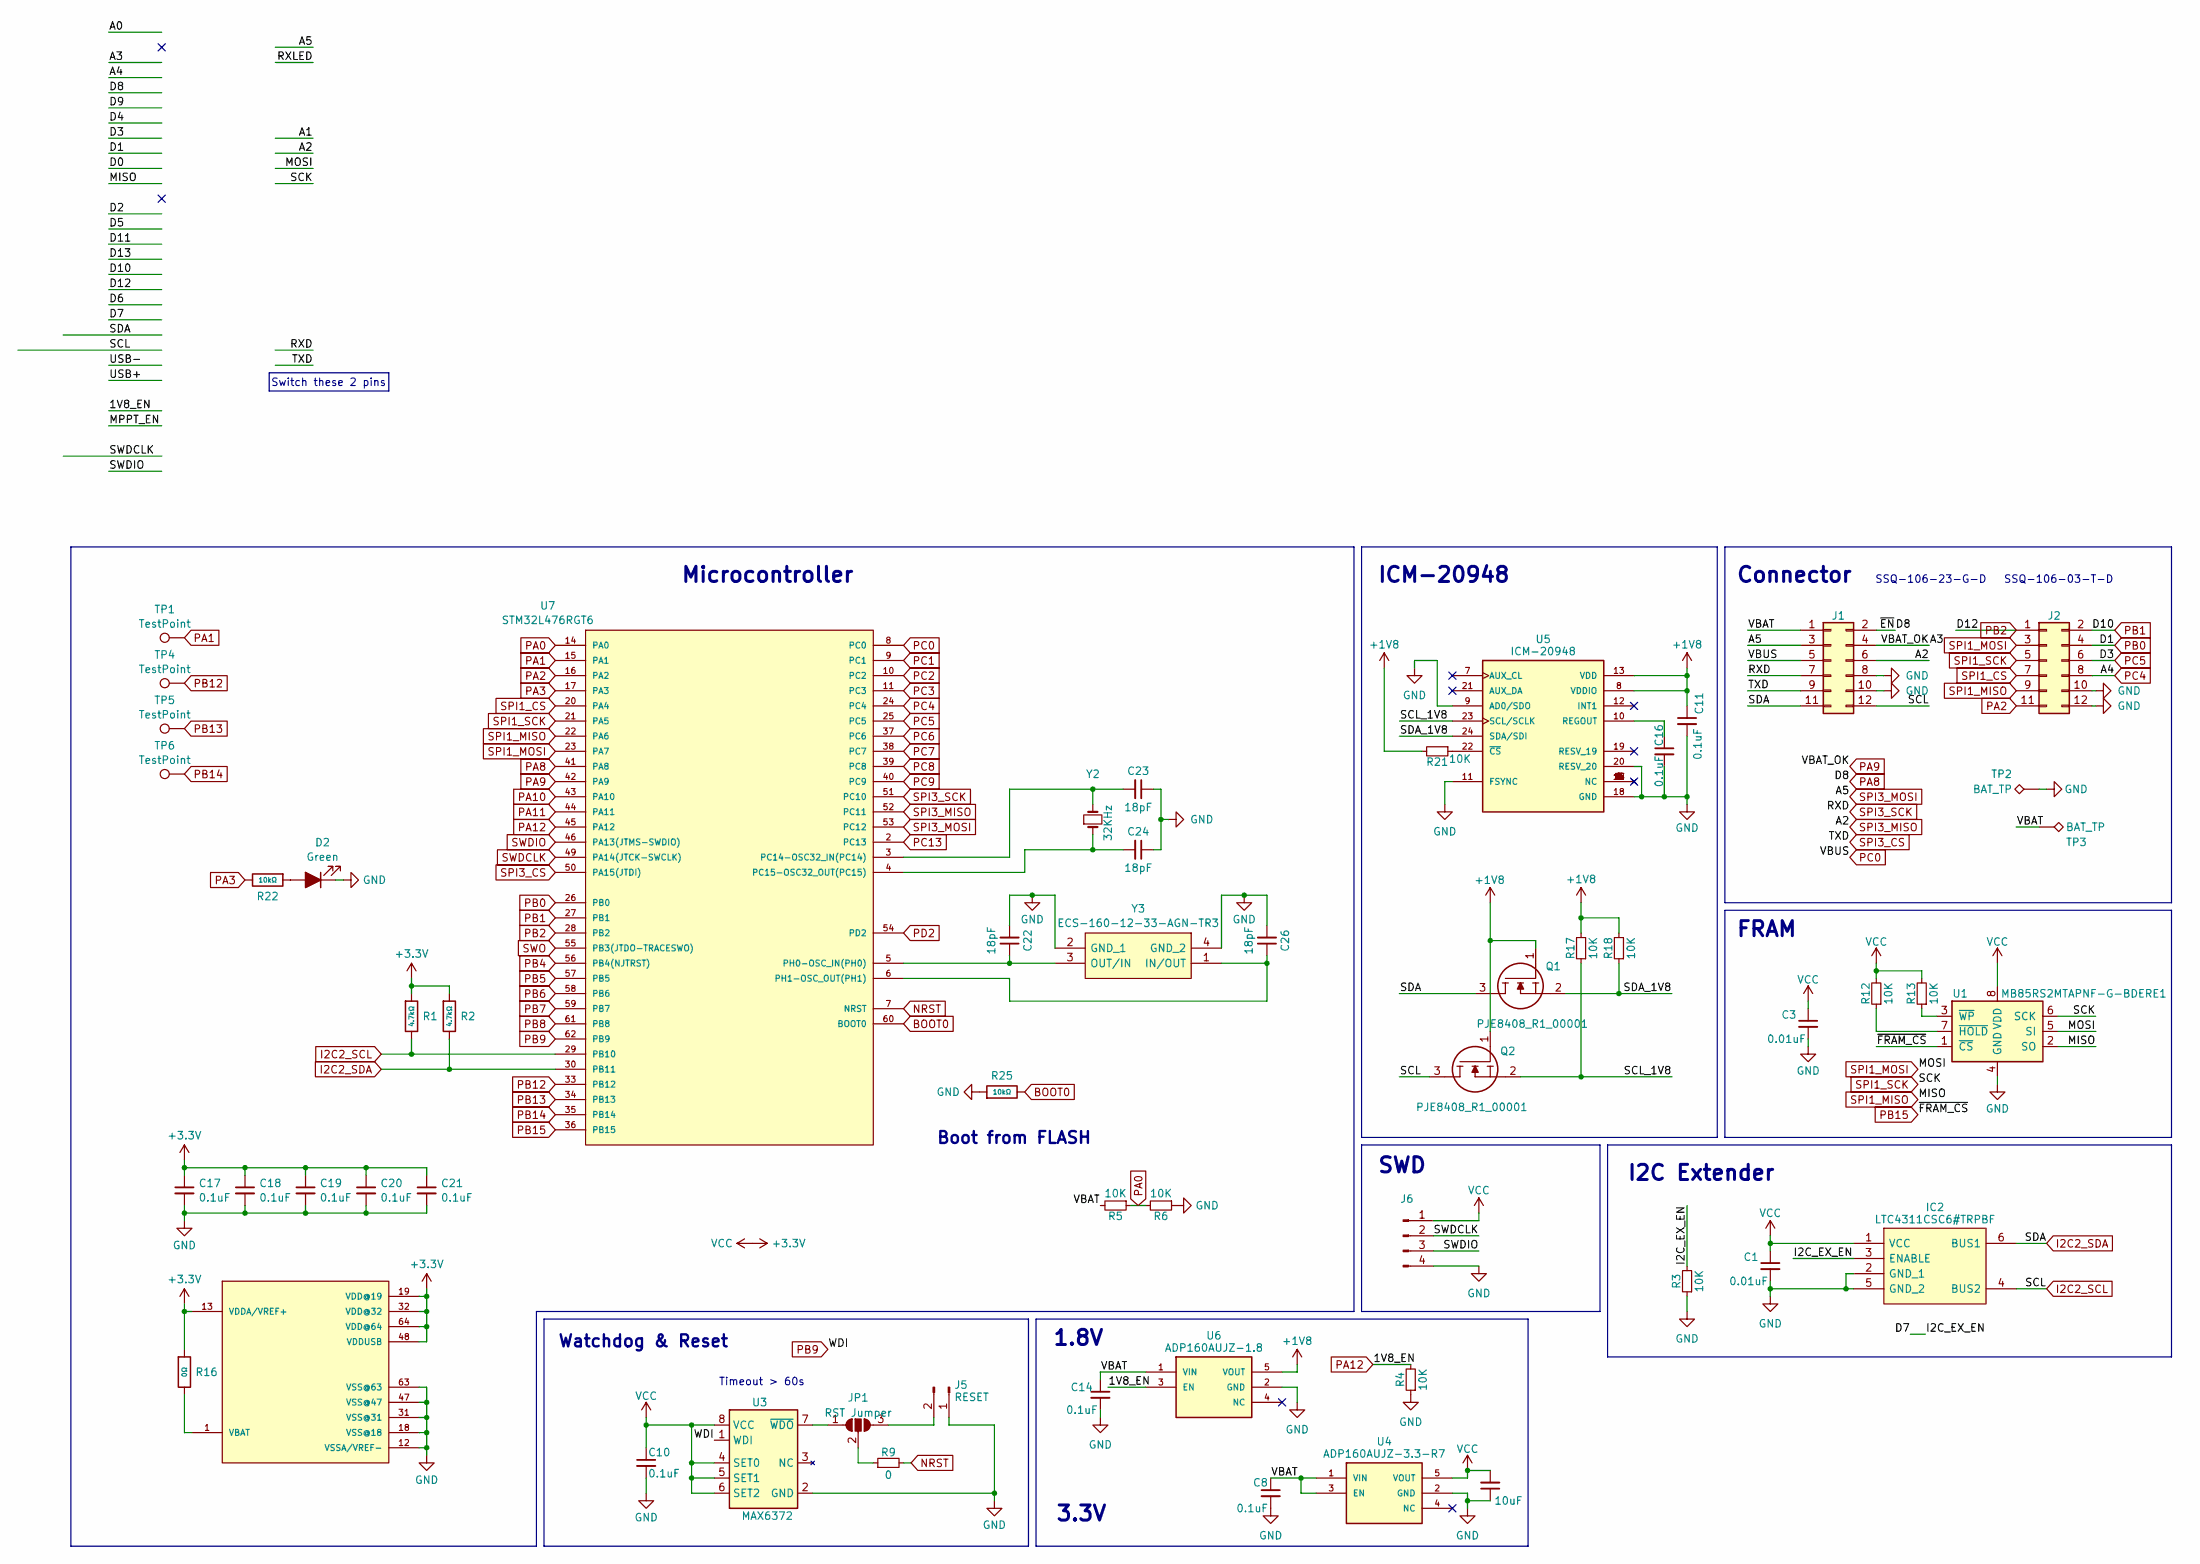
[picture p59: schematic MCU.kicad_sch, HexSense Svalbard - MCU module]

Parts:
C1, C3: 0.01uF; C_0402_1005Metric_Pad0.74x0.62mm_HandSolder
C8, C11, C14, C16, C17, C18, C19, C20, C21: 0.1uF; C_0402_1005Metric_Pad0.74x0.62mm_HandSolder
C9: 10uF; C_0603_1608Metric_Pad1.08x0.95mm_HandSolder
C10: 0.1uF; C_0402_1005Metric
C22, C23, C24, C26: 18pF; C_0402_1005Metric_Pad0.74x0.62mm_HandSolder
D2: Green; LED_0402_1005Metric_Pad0.77x0.64mm_HandSolder
IC2: LTC4311CSC6#TRPBF; SOT65P210X100-6N; Manufacturer_Part_Number LTC4311CSC6#TRPBF; Mouser Part Number 584-LTC4311CSC6TRPBF
J1, J2: Conn_02x06_Odd_Even; PinHeader_2x06_P2.54mm_Vertical
J5: RESET; PinHeader_1x02_P2.00mm_Vertical
J6: Conn_01x04_Pin; PinHeader_1x04_P2.00mm_Vertical
JP1: RST Jumper; SolderJumper-3_P1.3mm_Open_RoundedPad1.0x1.5mm
Q1, Q2: PJE8408_R1_00001; SOTFL50P160X60-3N; Manufacturer_Part_Number PJE8408_R1_00001; Mouser Part Number 241-PJE8408_R1_00001
R1, R2: 4.7kΩ; R_0402; Overload Voltage (Max) 50V; Tolerance ±1%; Part 0402WGF4701TCE; LCSC C25900
R3, R4, R5, R6, R12, R13, R17, R18, R21: 10K; R_0402_1005Metric_Pad0.72x0.64mm_HandSolder
R9: 0; R_0201_0603Metric
R16: 0Ω; R_0402; Overload Voltage (Max) 50V; Tolerance ±1%; Part 0402WGF0000TCE; LCSC C17168
R22: 10kΩ; R_0402_1005Metric_Pad0.72x0.64mm_HandSolder; Overload Voltage (Max) 75V; Tolerance ±1%; Part 0603WAF1001T5E; LCSC C21190
R25: 10kΩ; R_0603_1608Metric_Pad0.98x0.95mm_HandSolder; Overload Voltage (Max) 200V; Tolerance ±1%; Part 1206W4F1002T5E; LCSC C17902
TP1, TP4, TP5, TP6: TestPoint; TestPoint_Pad_D1.0mm
TP2, TP3: BAT_TP; TestPoint_Pad_1.0x1.0mm
U1: MB85RS2MTAPNF-G-BDERE1; SSOP-8_5.25x5.24mm_P1.27mm
U3: MAX6372; SOT-23-8
U4: ADP160AUJZ-3.3-R7; TSOT-23-5; PARTREV H
U5: ICM-20948; InvenSense_QFN-24_3x3mm_P0.4mm; PARTREV 1.3
U6: ADP160AUJZ-1.8; TSOT-23-5; PARTREV H
U7: STM32L476RGT6; LQFP-64_10x10mm_P0.5mm
Y2: 32KHz; Crystal_SMD_3215-2Pin_3.2x1.5mm
Y3: ECS-160-12-33-AGN-TR3; XTAL_ECS-160-12-33-AGN-TR3; Manufacturer_Part_Number ECS-160-12-33-AGN-TR3; Mouser Part Number 520-160-12-33AGN-TR3

Connections:
+1V8: C11.1, Q1.1, Q2.1, R17.2, R18.2, R21.2, U5.8 (VDDIO), U5.13 (VDD), U6.5 (VOUT)
+3.3V: C1.1, C3.1, C9.2, C10.1, C17.1, C18.1, C19.1, C20.1, C21.1, IC2.1 (VCC), J6.1, R1.1, R2.1, R12.2, R13.2, R16.1, U1.8 (VDD), U3.4 (SET0), U3.5 (SET1), U3.6 (SET2), U3.8 (VCC), U4.5 (VOUT), U7.13 (VDDA/VREF+), U7.19 (VDD@19), U7.32 (VDD@32), U7.48 (VDDUSB), U7.64 (VDD@64)
/D7: IC2.3 (ENABLE), R3.2
/SCL_1V8: Q2.2, R17.1, U5.23 (SCL/SCLK)
/SDA_1V8: Q1.2, R18.1, U5.24 (SDA/SDI)
/VBAT: C8.1, C14.1, J1.1, R5.2, TP3.1, U4.1 (VIN), U4.3 (EN), U6.1 (VIN)
BOOT0: R25.2, U7.60 (BOOT0)
GND: C1.2, C3.2, C8.2, C9.1, C10.2, C11.2, C14.2, C16.2, C17.2, C18.2, C19.2, C20.2, C21.2, C22.2, C23.1, C24.1, C26.2, D2.1 (K), IC2.2 (GND_1), IC2.5 (GND_2), J1.8, J1.10, J2.10, J2.12, J5.1, J6.4, R3.1, R4.1, R6.1, R25.1, TP2.1, U1.4 (GND), U3.2 (GND), U4.2 (GND), U5.9 (AD0/SDO), U5.11 (FSYNC), U5.18 (GND), U5.20 (RESV_20), U6.2 (GND), U7.12 (VSSA/VREF-), U7.18 (VSS@18), U7.31 (VSS@31), U7.47 (VSS@47), U7.63 (VSS@63), Y3.2 (GND_1), Y3.4 (GND_2)
I2C2_SCL: IC2.4 (BUS2), J1.12, Q2.3, R1.2, U7.29 (PB10)
I2C2_SDA: IC2.6 (BUS1), J1.11, Q1.3, R2.2, U7.30 (PB11)
NRST: R9.2, U7.7 (NRST)
unnamed: D2.2 (A), R22.1
unnamed: J5.2, JP1.3 (B)
unnamed: JP1.1 (A), U3.7 (~WDO)
unnamed: JP1.2 (C), R9.1
unnamed: R12.1, U1.7 (~HOLD)
unnamed: R13.1, U1.3 (~WP)
unnamed: C16.1, U5.10 (REGOUT)
unnamed: R21.1, U5.22 (~CS)
unnamed: C23.2, U7.3 (PC14-OSC32_IN(PC14)), Y2.2
unnamed: C24.2, U7.4 (PC15-OSC32_OUT(PC15)), Y2.1
unnamed: C22.1, U7.5 (PH0-OSC_IN(PH0)), Y3.3 (OUT/IN)
unnamed: C26.1, U7.6 (PH1-OSC_OUT(PH1)), Y3.1 (IN/OUT)
unnamed: R16.2, U7.1 (VBAT)
PA0: R5.1, R6.2, U7.14 (PA0)
PA1: TP1.1, U7.15 (PA1)
PA2: J2.11, U7.16 (PA2)
PA3: R22.2, U7.17 (PA3)
PA8: J1.2, U7.41 (PA8)
PA9: J1.4, U7.42 (PA9)
PA10: U7.43 (PA10)
PA11: U7.44 (PA11)
PA12: R4.2, U6.3 (EN), U7.45 (PA12)
PB0: J2.4, U7.26 (PB0)
PB1: J2.2, U7.27 (PB1)
PB2: J2.1, U7.28 (PB2)
PB4: U7.56 (PB4(NJTRST))
PB5: U7.57 (PB5)
PB6: U7.58 (PB6)
PB7: U7.59 (PB7)
PB8: U7.61 (PB8)
PB9: U3.1 (WDI), U7.62 (PB9)
PB12: TP4.1, U7.33 (PB12)
PB13: TP5.1, U7.34 (PB13)
PB14: TP6.1, U7.35 (PB14)
PB15: U1.1 (~CS), U7.36 (PB15)
PC0: J1.5, U7.8 (PC0)
PC1: U7.9 (PC1)
PC2: U7.10 (PC2)
PC3: U7.11 (PC3)
PC4: J2.8, U7.24 (PC4)
PC5: J2.6, U7.25 (PC5)
PC6: U7.37 (PC6)
PC7: U7.38 (PC7)
PC8: U7.39 (PC8)
PC9: U7.40 (PC9)
PC13: U7.2 (PC13)
PD2: U7.54 (PD2)
SPI1_CS: J2.7, U7.20 (PA4)
SPI1_MISO: J2.9, U1.2 (SO), U7.22 (PA6)
SPI1_MOSI: J2.3, U1.5 (SI), U7.23 (PA7)
SPI1_SCK: J2.5, U1.6 (SCK), U7.21 (PA5)
SPI3_CS: J1.9, U7.50 (PA15(JTDI))
SPI3_MISO: J1.6, U7.52 (PC11)
SPI3_MOSI: J1.3, U7.53 (PC12)
SPI3_SCK: J1.7, U7.51 (PC10)
SWDCLK: J6.2, U7.49 (PA14(JTCK-SWCLK))
SWDIO: J6.3, U7.46 (PA13(JTMS-SWDIO))
SWO: U7.55 (PB3(JTDO-TRACESWO))

Notes on the sheet:
ICM-20948
SSQ-106-03-T-D
1.8V
Microcontroller
FRAM
Timeout > 60s
Watchdog & Reset
SWD
Connector
3.3V
Boot from FLASH
Switch these 2 pins
SSQ-106-23-G-D
I2C Extender

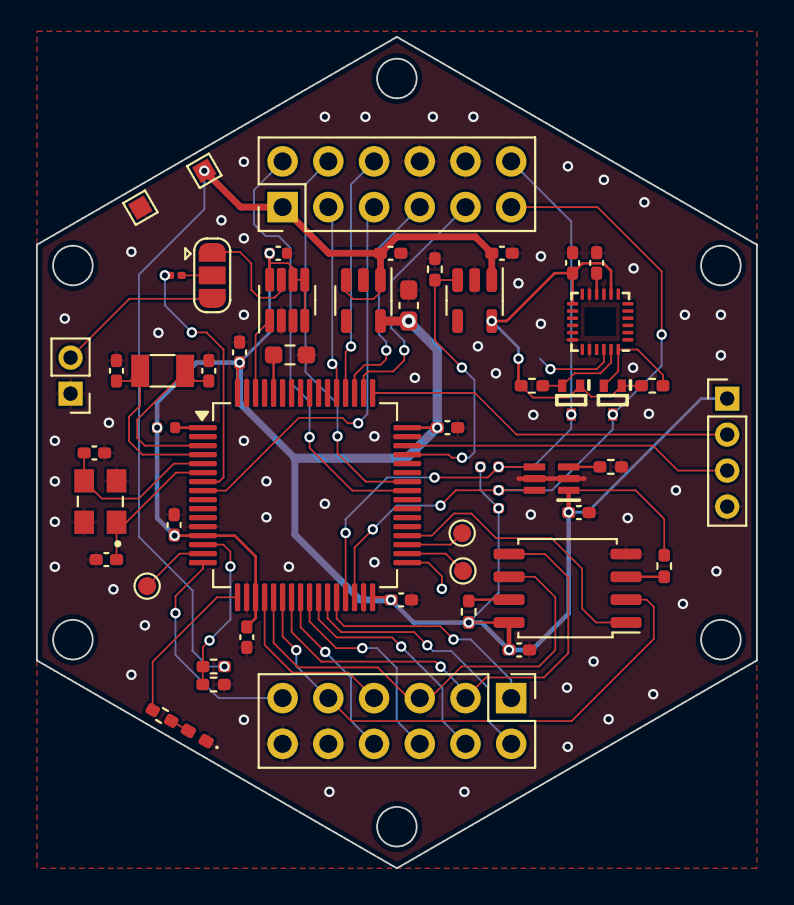
[picture p60: board PCB/MCU/V2_STM32L476/MCU.kicad_pcb from above]

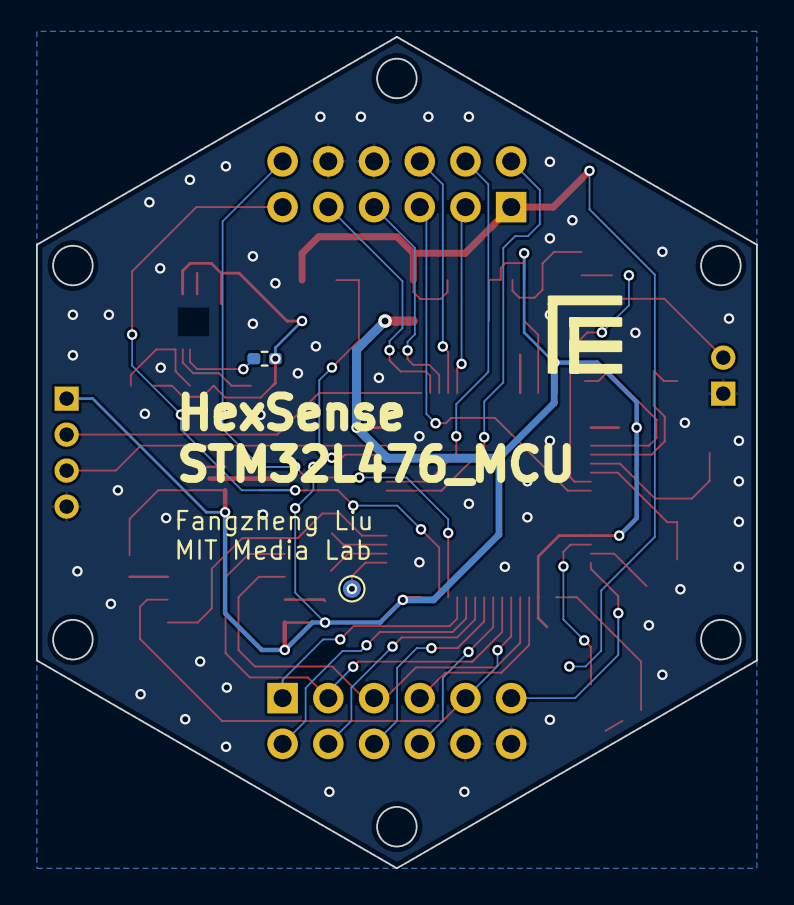
[picture p61: board PCB/MCU/V2_STM32L476/MCU.kicad_pcb from below]

Board: 2 copper layers, 40.0 x 46.2 mm, 55 parts (2 on the bottom side), 52 nets.
