Ironman-007/HexSense_Canary_Islands/PCB/LORA_ADAPTER/LORA_ADAPTER.kicad_pcb

## KiCad design PCB/LORA_ADAPTER/LORA_ADAPTER.kicad_pcb (2025-03-31)

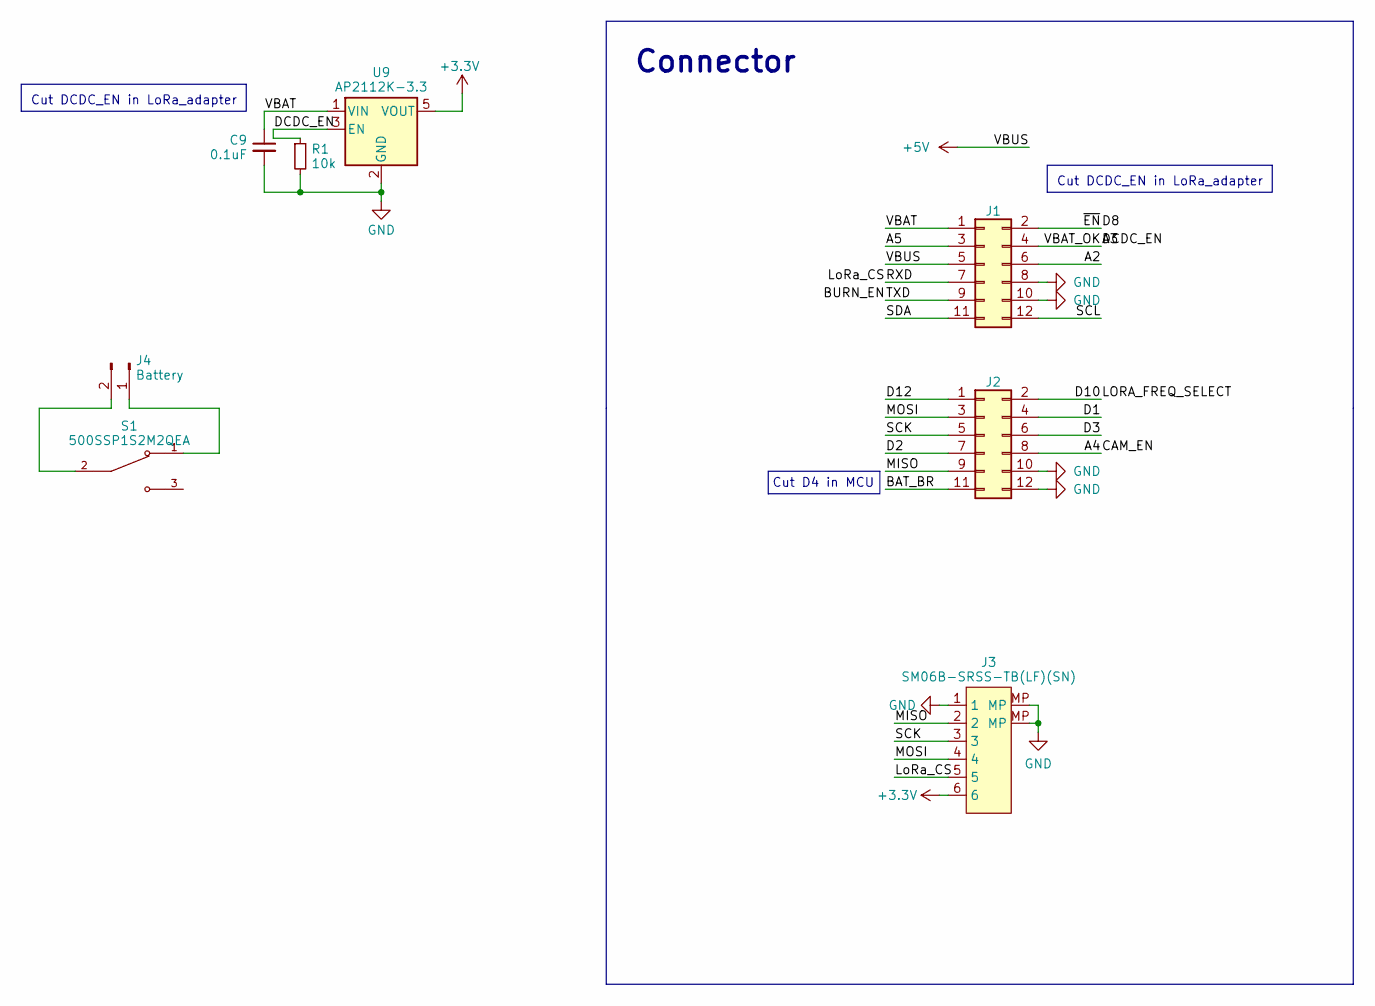
[picture p62: schematic LORA_ADAPTER.kicad_sch, HexSense Svalbard - MCU module]

Parts:
C9: 0.1uF; C_0402_1005Metric_Pad0.74x0.62mm_HandSolder
J1, J2: Conn_02x06_Odd_Even; PinHeader_2x06_P2.54mm_Vertical
J3: SM06B-SRSS-TB(LF)(SN); JST_SH_SM06B-SRSS-TB_1x06-1MP_P1.00mm_Horizontal
J4: Battery; PinHeader_1x02_P2.54mm_Vertical
R1: 10k; R_0402_1005Metric_Pad0.72x0.64mm_HandSolder
S1: 500SSP1S2M2QEA; SW_500SSP1S2M2QEA; PARTREV C
U9: AP2112K-3.3; SOT-23-5

Connections:
+3V3: J3.6, U9.5 (VOUT)
+5V: J1.5
/A2: J1.6
/A3: J1.4, R1.1, U9.3 (EN)
/A4: J2.8
/A5: J1.3
/BAT_BR: J2.11
/BURN_EN: J1.9
/D1: J2.4
/D2: J2.7
/D3: J2.6
/D8: J1.2
/D10: J2.2
/D12: J2.1
/LoRa_CS: J1.7, J3.5
/MISO: J2.9, J3.2
/MOSI: J2.3, J3.4
/SCK: J2.5, J3.3
/SCL: J1.12
/SDA: J1.11
/VBAT: C9.1, J1.1, U9.1 (VIN)
GND: C9.2, J1.8, J1.10, J2.10, J2.12, J3.1, J3.MP, R1.2, U9.2 (GND)
unnamed: J4.1, S1.1
unnamed: J4.2, S1.2

Notes on the sheet:
Cut D4 in MCU
Connector
Cut DCDC_EN in LoRa_adapter

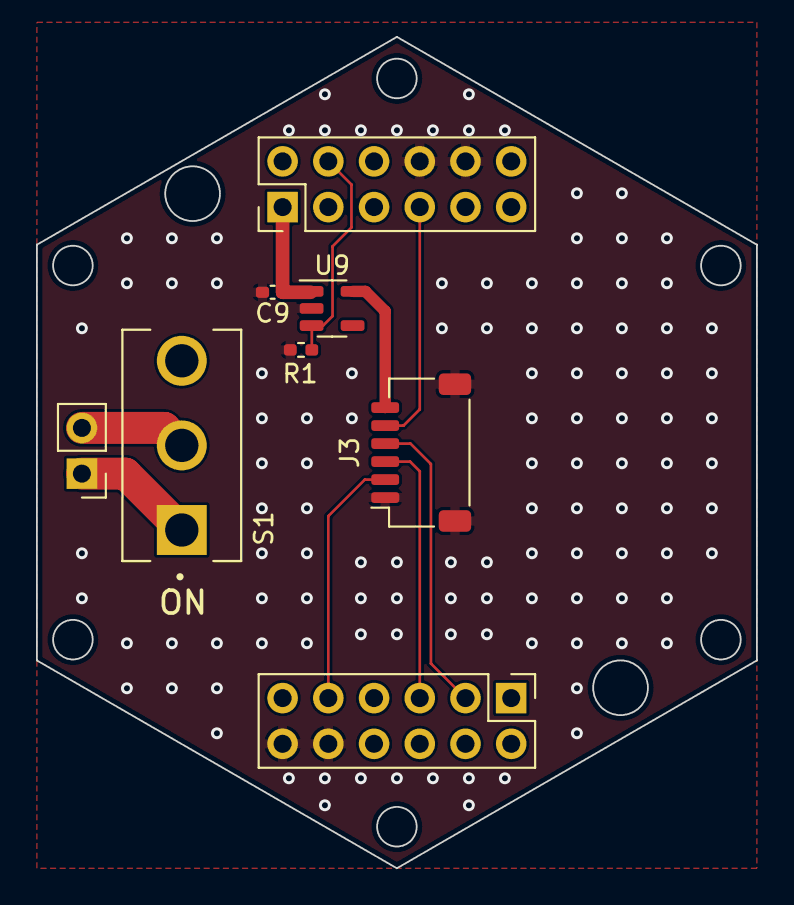
[picture p63: board LORA_ADAPTER.kicad_pcb from above]

Board: 2 copper layers, 40.0 x 46.2 mm, 8 parts (0 on the bottom side), 10 nets.
