Ironman-007/HexSense_Canary_Islands/PCB/CONN/CONN.kicad_pcb

## KiCad design PCB/CONN/CONN.kicad_pcb (2025-03-31)

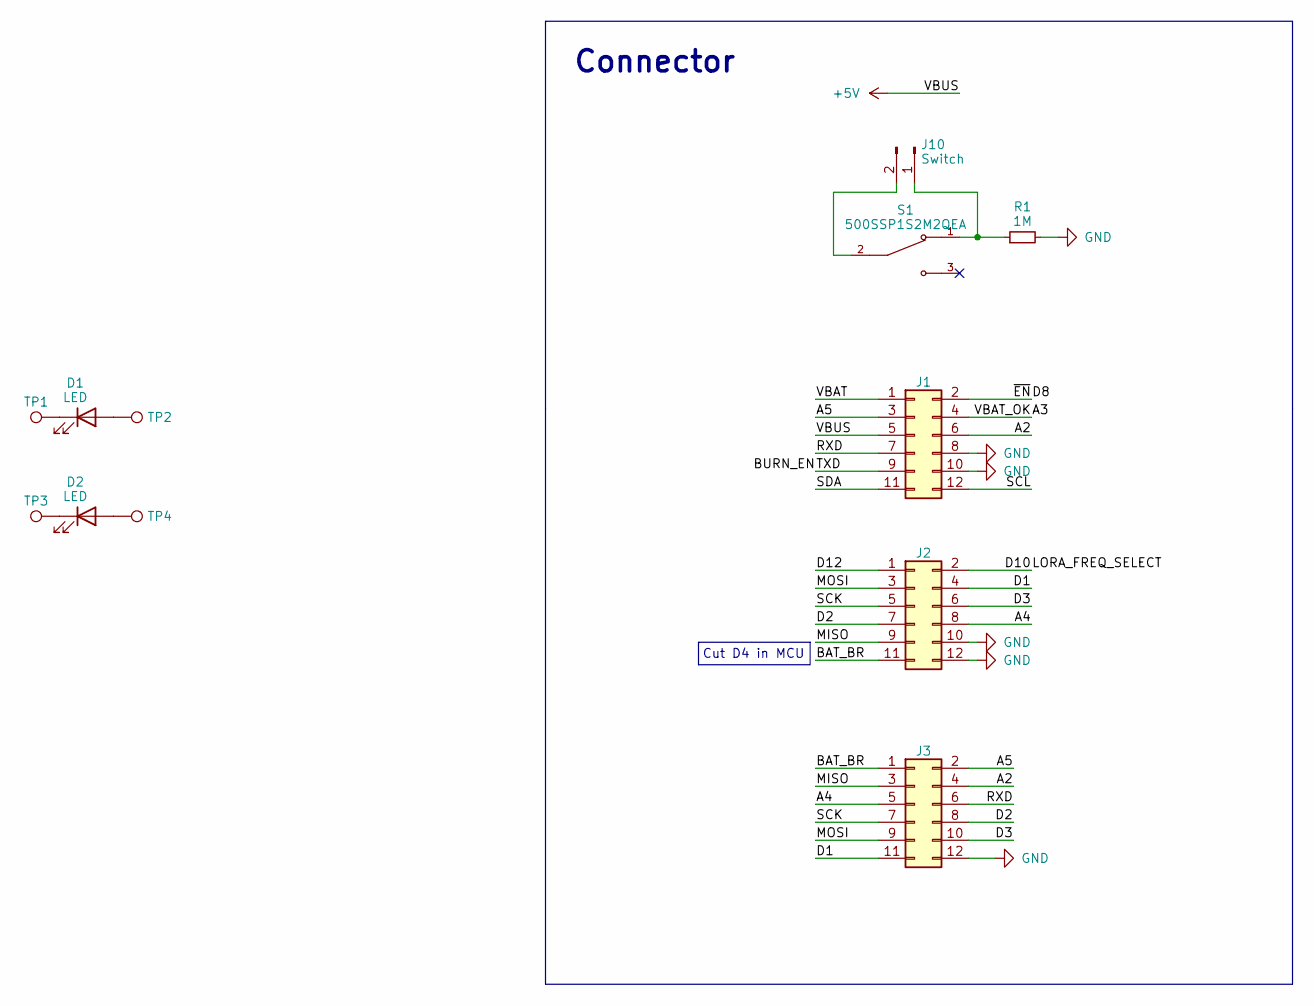
[picture p66: schematic CONN.kicad_sch, HexSense Svalbard - MCU module]

Parts:
D1, D2: LED; LED_1206_3216Metric_Pad1.42x1.75mm_HandSolder
J1, J2, J3: Conn_02x06_Odd_Even; PinHeader_2x06_P2.54mm_Vertical
J10: Switch; PinHeader_1x02_P2.00mm_Vertical
R1: 1M; R_0603_1608Metric_Pad0.98x0.95mm_HandSolder
S1: 500SSP1S2M2QEA; SW_500SSP1S2M2QEA; PARTREV C
TP1, TP2, TP3, TP4: TestPoint; TestPoint_Pad_1.0x1.0mm

Connections:
+5V: J1.5
/A2: J1.6, J3.4
/A3: J1.4
/A4: J2.8, J3.5
/A5: J1.3, J3.2
/BAT_BR: J2.11, J3.1
/BURN_EN: J1.9
/D1: J2.4, J3.11
/D2: J2.7, J3.8
/D3: J2.6, J3.10
/D8: J1.2
/D10: J2.2
/D12: J2.1
/MISO: J2.9, J3.3
/MOSI: J2.3, J3.9
/RXD: J1.7, J3.6
/SCK: J2.5, J3.7
/SCL: J1.12
/SDA: J1.11
/VBAT: J1.1
GND: J1.8, J1.10, J2.10, J2.12, J3.12, R1.2
unnamed: D1.2 (A), TP2.1
unnamed: D1.1 (K), TP1.1
unnamed: D2.2 (A), TP4.1
unnamed: D2.1 (K), TP3.1
unnamed: J10.1, R1.1, S1.1
unnamed: J10.2, S1.2

Notes on the sheet:
Connector
Cut D4 in MCU
