Ironman-007/HexSense_Canary_Islands/PCB/CONN/CONN.kicad_pcb

## KiCad design PCB/CONN/CONN.kicad_pcb (continued)

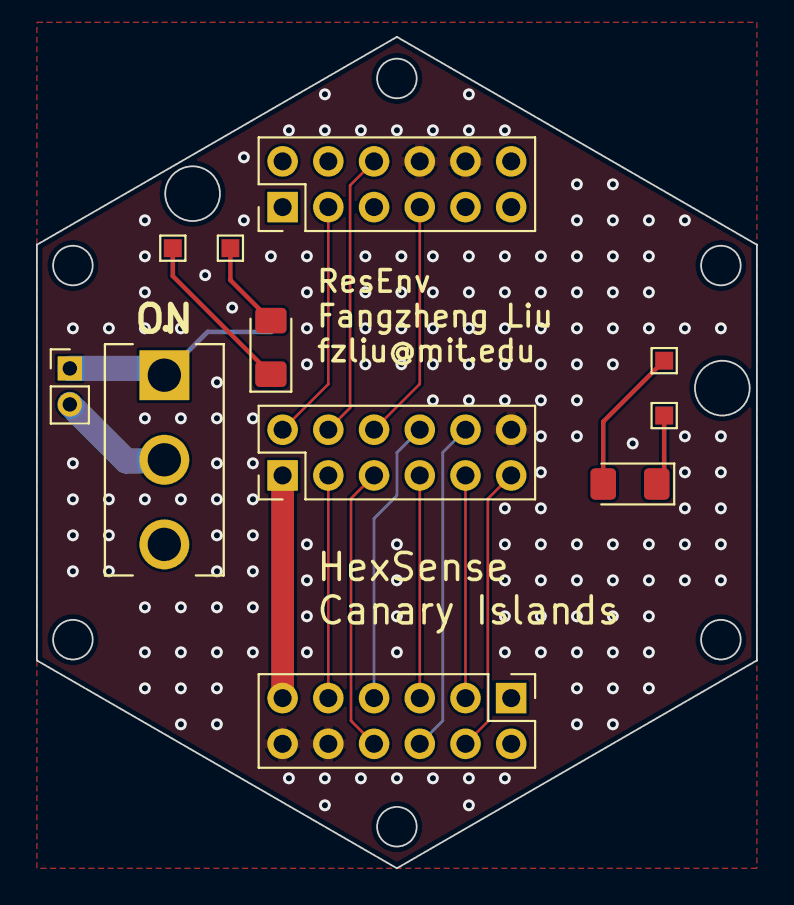
[picture p67: board CONN.kicad_pcb from above]

Board: 2 copper layers, 40.0 x 46.2 mm, 12 parts (1 on the bottom side), 18 nets.
