Ironman-007/HexSense_Canary_Islands/PCB/LORA/V1/LORA.kicad_pcb

## KiCad design PCB/LORA/V1/LORA.kicad_pcb (2025-03-31)

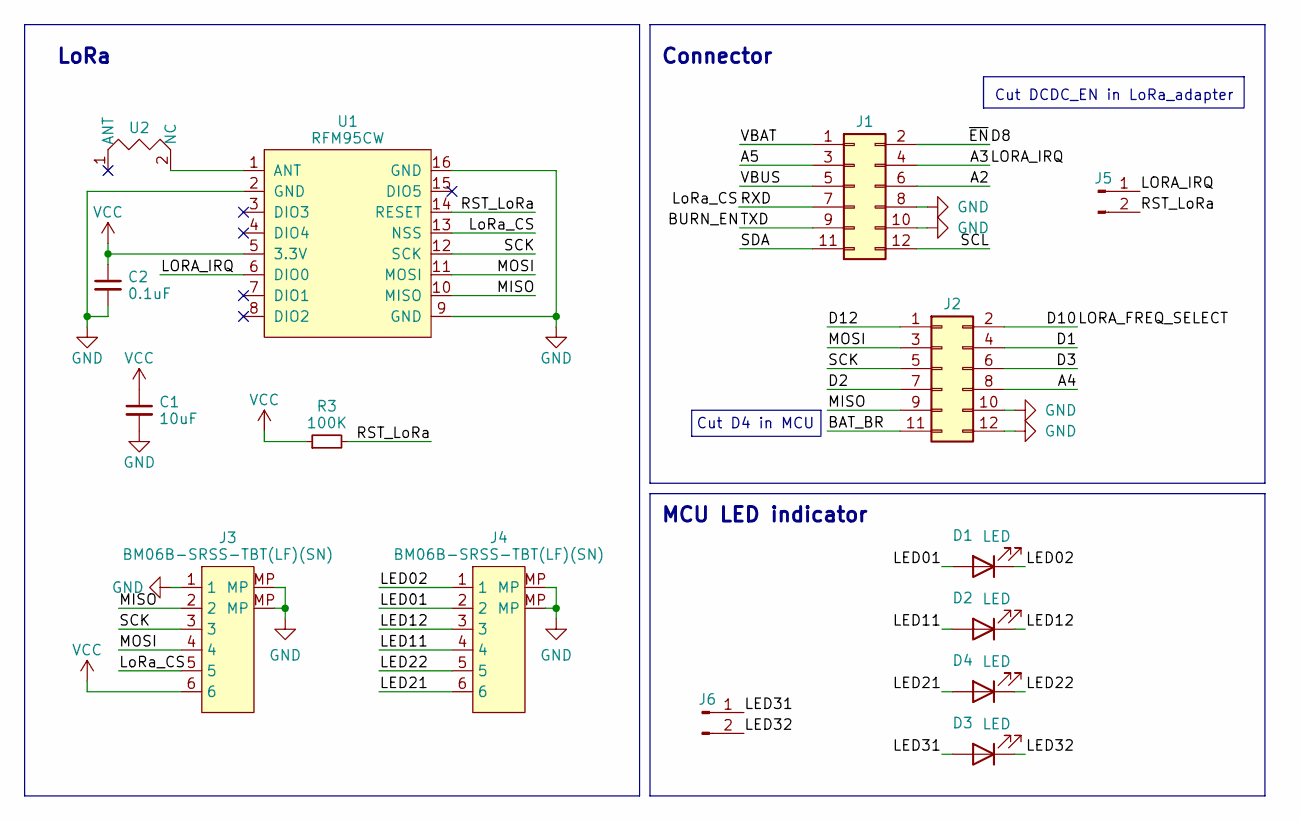
[picture p68: schematic LORA.kicad_sch, HexSense Svalbard - PWR]

Parts:
C1: 10uF; C_1206_3216Metric_Pad1.33x1.80mm_HandSolder
C2: 0.1uF; C_1206_3216Metric_Pad1.33x1.80mm_HandSolder
D1, D2, D3, D4: LED; LED_0603_1608Metric_Pad1.05x0.95mm_HandSolder
J1, J2: Conn_02x06_Odd_Even; PinHeader_2x06_P2.54mm_Vertical
J3, J4: BM06B-SRSS-TBT(LF)(SN); JST_SH_BM06B-SRSS-TB_1x06-1MP_P1.00mm_Vertical
J5, J6: Conn_01x02_Pin; PinHeader_1x02_P2.00mm_Vertical
R3: 100K; R_0603_1608Metric_Pad0.98x0.95mm_HandSolder
U1: RFM95CW; XCVR_RFM95W-915S2
U2: ANT-916-HESM

Connections:
/A2: J1.6
/A3: J1.4, J5.1, U1.6 (DIO0)
/A4: J2.8
/A5: J1.3
/BAT_BR: J2.11
/BURN_EN: J1.9
/D1: J2.4
/D2: J2.7
/D3: J2.6
/D8: J1.2
/D10: J2.2
/D12: J2.1
/LED01: D1.2 (A), J4.2
/LED02: D1.1 (K), J4.1
/LED11: D2.2 (A), J4.4
/LED12: D2.1 (K), J4.3
/LED21: D4.2 (A), J4.6
/LED22: D4.1 (K), J4.5
/LED31: D3.2 (A), J6.1
/LED32: D3.1 (K), J6.2
/LoRa_CS: J1.7, J3.5, U1.13 (NSS)
/MISO: J2.9, J3.2, U1.10 (MISO)
/MOSI: J2.3, J3.4, U1.11 (MOSI)
/RST_LoRa: J5.2, R3.2, U1.14 (RESET)
/SCK: J2.5, J3.3, U1.12 (SCK)
/SCL: J1.12
/SDA: J1.11
/VBAT: J1.1
/VBUS: J1.5
GND: C1.2, C2.2, J1.8, J1.10, J2.10, J2.12, J3.1, J3.MP, J4.MP, U1.2 (GND), U1.9 (GND), U1.16 (GND)
unnamed: U1.1 (ANT), U2.2 (NC)
VCC: C1.1, C2.1, J3.6, R3.1, U1.5 (3.3V)

Notes on the sheet:
Cut D4 in MCU
LoRa
Connector
MCU LED indicator
Cut DCDC_EN in LoRa_adapter

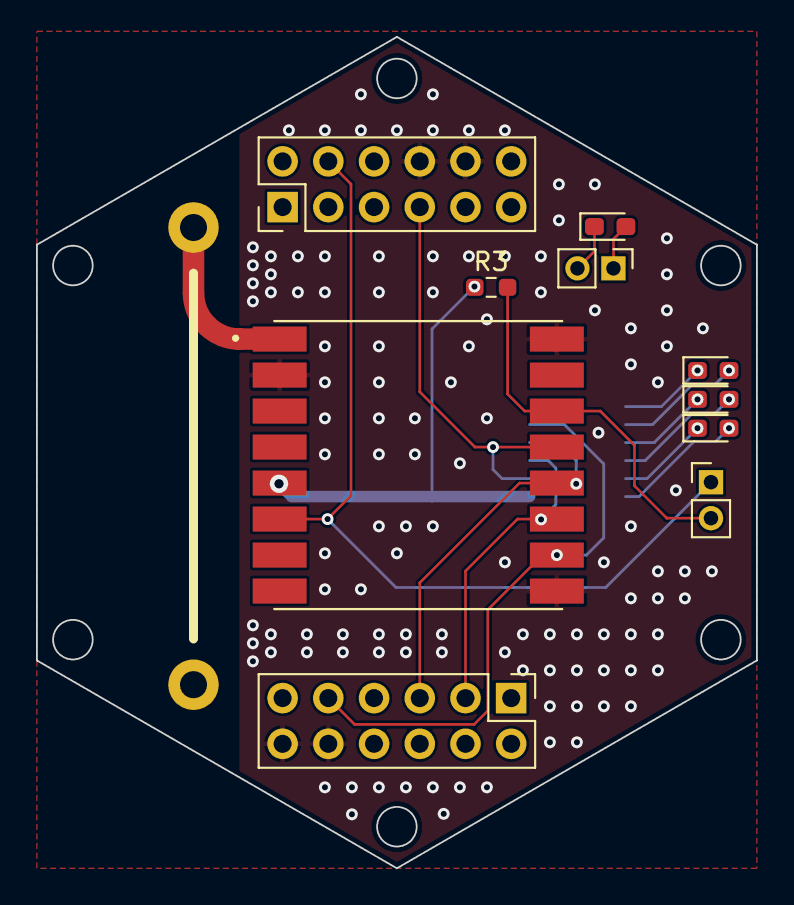
[picture p69: board LORA.kicad_pcb from above]

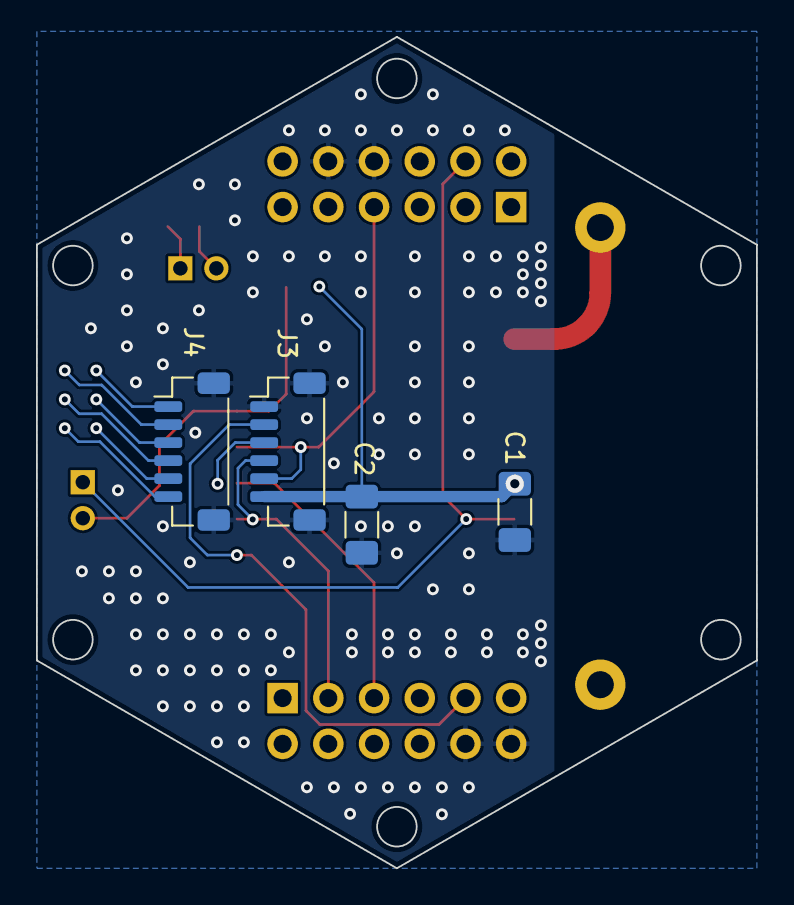
[picture p70: board LORA.kicad_pcb from below]

Board: 2 copper layers, 40.0 x 46.2 mm, 15 parts (4 on the bottom side), 17 nets.
