Ironman-007/HexSense_Canary_Islands/PCB/PWR/V2/PWR.kicad_pcb

## KiCad design PCB/PWR/V2/PWR.kicad_pcb (2025-03-31)

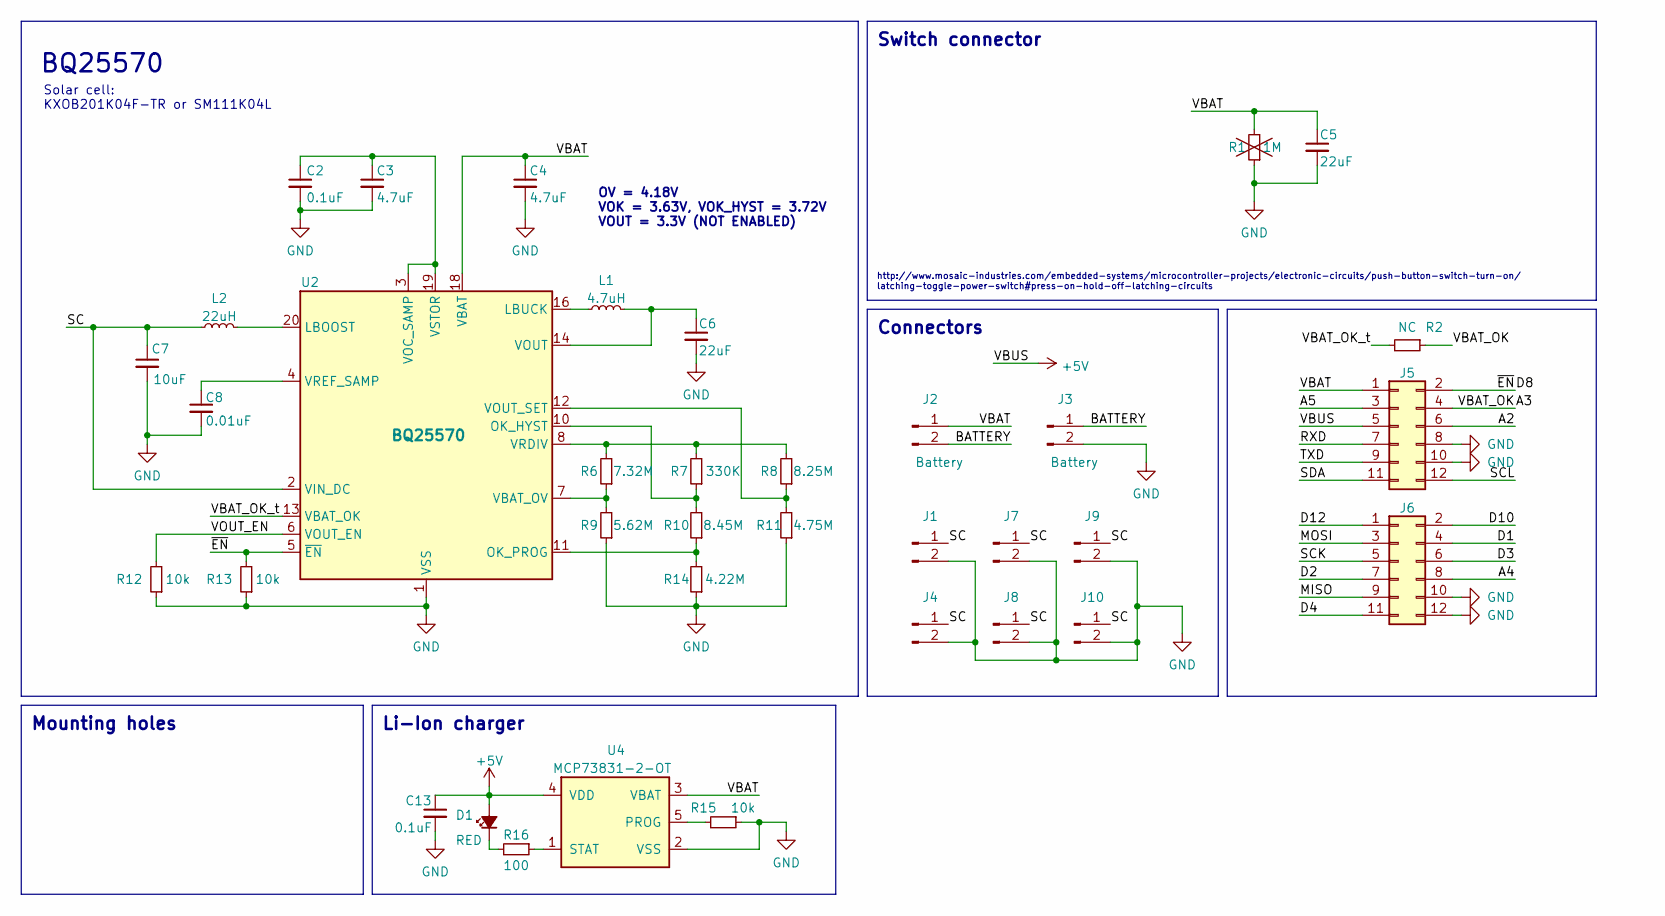
[picture p71: schematic PWR.kicad_sch, HexSense Svalbard - PWR]

Parts:
C2, C13: 0.1uF; C_0402_1005Metric_Pad0.74x0.62mm_HandSolder
C3, C4: 4.7uF; C_0603_1608Metric_Pad1.08x0.95mm_HandSolder
C5: 22uF; C_0603_1608Metric_Pad1.08x0.95mm_HandSolder
C6: 22uF; C_0805_2012Metric_Pad1.18x1.45mm_HandSolder
C7: 10uF; C_0603_1608Metric_Pad1.08x0.95mm_HandSolder
C8: 0.01uF; C_0402_1005Metric_Pad0.74x0.62mm_HandSolder
D1: RED; LED_0603_1608Metric_Pad1.05x0.95mm_HandSolder
J1, J4, J7, J8, J9, J10: Battery; Molex_Micro-Latch_53253-0270_1x02_P2.00mm_Vertical
J2, J3: Battery; PinHeader_2x01_P2.00mm_Vertical
J5, J6: Conn_02x06_Odd_Even; PinHeader_2x06_P2.54mm_Vertical
L1: 4.7uH; L_Wuerth_MAPI-3015
L2: 22uH; L_Taiyo-Yuden_NR-40xx_HandSoldering
R1: 1M; R_0603_1608Metric_Pad0.98x0.95mm_HandSolder
R2: NC; R_0603_1608Metric_Pad0.98x0.95mm_HandSolder
R6: 7.32M; R_0603_1608Metric_Pad0.98x0.95mm_HandSolder
R7: 330K; R_0603_1608Metric_Pad0.98x0.95mm_HandSolder
R8: 8.25M; R_0603_1608Metric_Pad0.98x0.95mm_HandSolder
R9: 5.62M; R_0603_1608Metric_Pad0.98x0.95mm_HandSolder
R10: 8.45M; R_0603_1608Metric_Pad0.98x0.95mm_HandSolder
R11: 4.75M; R_0603_1608Metric_Pad0.98x0.95mm_HandSolder
R12, R13, R15: 10k; R_0603_1608Metric_Pad0.98x0.95mm_HandSolder
R14: 4.22M; R_0603_1608Metric_Pad0.98x0.95mm_HandSolder
R16: 100; R_0603_1608Metric_Pad0.98x0.95mm_HandSolder
U2: BQ25570; QFN-20-1EP_3.5x3.5mm_P0.5mm_EP2x2mm
U4: MCP73831-2-OT; SOT-23-5

Connections:
+5V: C13.1, D1.2 (A), J5.5, U4.4 (VDD)
/A2: J5.6
/A3: J5.4, R2.1
/A4: J6.8
/A5: J5.3
/BATTERY: J2.2, J3.1
/D1: J6.4
/D2: J6.7
/D3: J6.6
/D4: J6.11
/D8: J5.2, R13.2, U2.5 (~EN)
/D10: J6.2
/D12: J6.1
/MISO: J6.9
/MOSI: J6.3
/RXD: J5.7
/SC: C7.1, J1.1, J4.1, J7.1, J8.1, J9.1, J10.1, L2.1, U2.2 (VIN_DC)
/SCK: J6.5
/SCL: J5.12
/SDA: J5.11
/TXD: J5.9
/VBAT: C4.1, C5.1, J2.1, J5.1, R1.2, U2.18 (VBAT), U4.3 (VBAT)
/VBAT_OK_t: R2.2, U2.13 (VBAT_OK)
/VOUT_EN: R12.2, U2.6 (VOUT_EN)
GND: C2.2, C3.2, C4.2, C5.2, C6.2, C7.2, C8.2, C13.2, J1.2, J3.2, J4.2, J5.8, J5.10, J6.10, J6.12, J7.2, J8.2, J9.2, J10.2, R1.1, R9.1, R11.1, R12.1, R13.1, R14.1, R15.1, U2.1 (VSS), U2.9 (VSS), U2.15 (VSS), U2.17 (VSS), U2.21 (VSS), U4.2 (VSS)
unnamed: D1.1 (K), R16.2
unnamed: L2.2, U2.20 (LBOOST)
unnamed: L1.1, U2.16 (LBUCK)
unnamed: R7.1, R10.2, U2.10 (OK_HYST)
unnamed: R10.1, R14.2, U2.11 (OK_PROG)
unnamed: R6.1, R9.2, U2.7 (VBAT_OV)
unnamed: C2.1, C3.1, U2.3 (VOC_SAMP), U2.19 (VSTOR)
unnamed: C6.1, L1.2, U2.14 (VOUT)
unnamed: R8.1, R11.2, U2.12 (VOUT_SET)
unnamed: R6.2, R7.2, R8.2, U2.8 (VRDIV)
unnamed: C8.1, U2.4 (VREF_SAMP)
unnamed: R15.2, U4.5 (PROG)
unnamed: R16.1, U4.1 (STAT)

Notes on the sheet:
Li-Ion charger
BQ25570
Switch connector
Mounting holes
Solar cell: KXOB201K04F-TR or SM111K04L
OV = 4.18V VOK = 3.63V, VOK_HYST = 3.72V VOUT = 3.3V (NOT ENABLED)
http://www.mosaic-industries.com/embedded-systems/microcontroller-projects/electronic-circuits/push-button-switch-turn-on/ latching-toggle-power-switch#press-on-hold-off-latching-circuits
Connectors

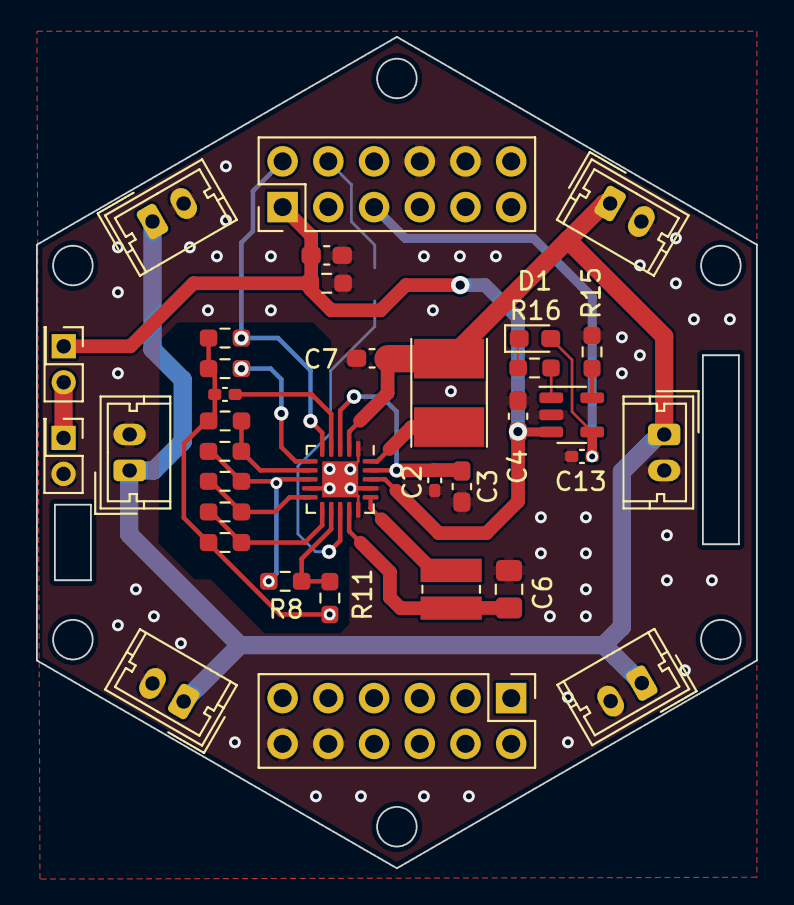
[picture p72: board PWR.kicad_pcb from above]

Board: 2 copper layers, 40.0 x 46.2 mm, 36 parts (1 on the bottom side), 22 nets.
