Ironman-007/HexSense_Canary_Islands/PCB/MCU/V1/MCU.kicad_pcb

## KiCad design PCB/MCU/V1/MCU.kicad_pcb (2025-03-31, an earlier design)

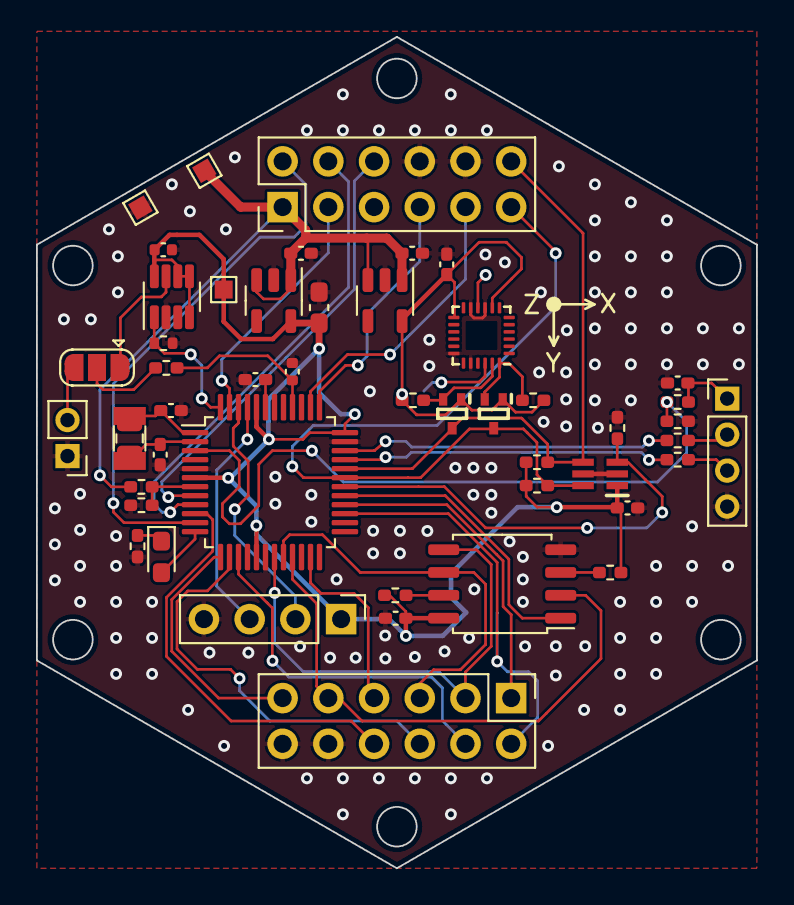
[picture p73: board PCB/MCU/V1/MCU.kicad_pcb from above]

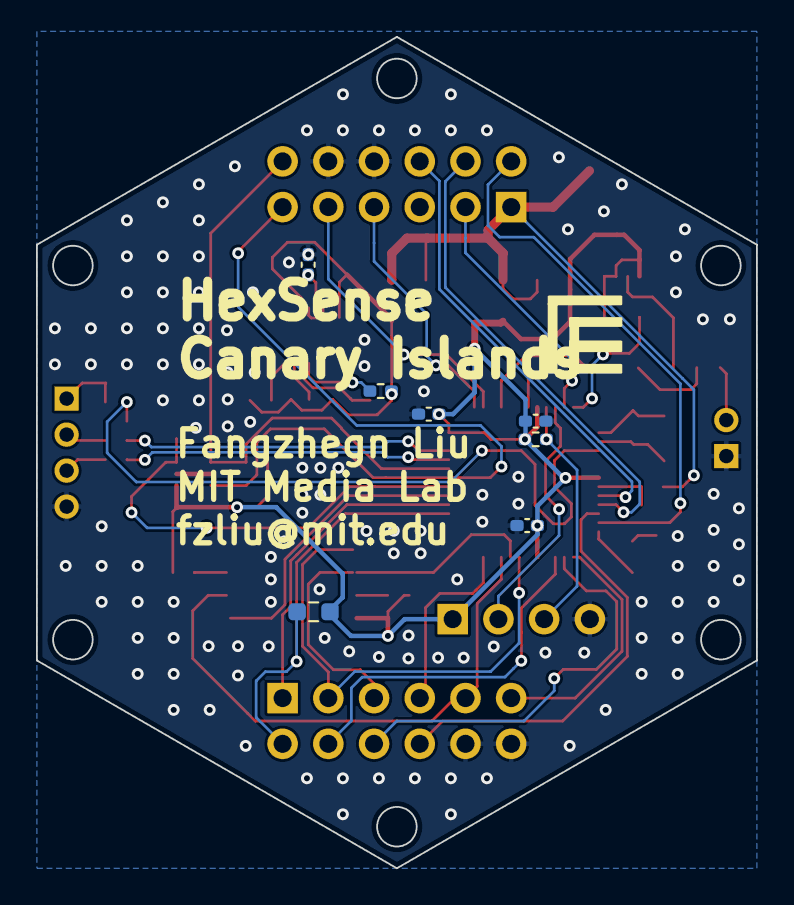
[picture p74: board PCB/MCU/V1/MCU.kicad_pcb from below]

Board: 2 copper layers, 40.0 x 46.2 mm, 56 parts (7 on the bottom side), 49 nets.

Parts:
C1, C3, C7: 0.01uF; C_0402_1005Metric_Pad0.74x0.62mm_HandSolder
C2, C4: 18pF; C_0402_1005Metric_Pad0.74x0.62mm_HandSolder
C5, C12: 1uF; C_0402_1005Metric_Pad0.74x0.62mm_HandSolder
C6, C8, C11, C14, C15, C16: 0.1uF; C_0402_1005Metric_Pad0.74x0.62mm_HandSolder
C9: 10uF; C_0603_1608Metric_Pad1.08x0.95mm_HandSolder
C10: 0.1uF; C_0402_1005Metric
C13: 10pF; C_0402_1005Metric
D1: RED; LED_0603_1608Metric_Pad1.05x0.95mm_HandSolder
IC2: LTC4311CSC6#TRPBF; SOT65P210X100-6N
J1, J2: Conn_02x06_Odd_Even; PinHeader_2x06_P2.54mm_Vertical
J4: Conn_01x04_Pin; PinHeader_1x04_P2.54mm_Vertical
J5: RESET; PinHeader_1x02_P2.00mm_Vertical
J6: Conn_01x04_Pin; PinHeader_1x04_P2.00mm_Vertical
JP1: RST Jumper; SolderJumper-3_P1.3mm_Open_RoundedPad1.0x1.5mm
Q1, Q2: PJE8408_R1_00001; SOTFL50P160X60-3N
R1, R2: 4.7K; R_0402_1005Metric_Pad0.72x0.64mm_HandSolder
R3, R12, R13, R17, R18, R21: 10K; R_0402_1005Metric_Pad0.72x0.64mm_HandSolder
R4: 10K; R_0402_1005Metric
R5, R6: 27; R_0402_1005Metric_Pad0.72x0.64mm_HandSolder
R7, R8, R14, R15: 499K; R_0402_1005Metric_Pad0.72x0.64mm_HandSolder
R9, R11: 330; R_0402_1005Metric_Pad0.72x0.64mm_HandSolder
R10: 10k; R_0402_1005Metric_Pad0.72x0.64mm_HandSolder
R19: PH; R_0805_2012Metric_Pad1.20x1.40mm_HandSolder
R20: 10K; R_0603_1608Metric_Pad0.98x0.95mm_HandSolder
TP1, TP2, TP3: BAT_TP; TestPoint_Pad_1.0x1.0mm
U1: MB85RS2MTAPNF-G-BDERE1; SSOP-8_5.25x5.24mm_P1.27mm
U2: ATSAMD21G18A-A; TQFP-48_7x7mm_P0.5mm
U3: MAX6372; SOT-23-8
U4: ADP160AUJZ-3.3-R7; TSOT-23-5
U5: ICM-20948; InvenSense_QFN-24_3x3mm_P0.4mm
U6: ADP160AUJZ-1.8; TSOT-23-5
Y1: 32KHz; Crystal_SMD_3215-2Pin_3.2x1.5mm

Connections:
+1V8: C11.1, Q1.1, Q2.1, R17.2, R18.2, R21.2, U5.8 (VDDIO), U5.13 (VDD), U6.5 (VOUT)
+5V: C7.1, J6.1, R14.1
/A0: R14.2, R15.1, U2.3 (PA02)
/A1: R7.2, R8.1, U2.7 (PB08)
/A2: J1.6, U2.8 (PB09)
/A3: J1.4, U2.9 (PA04)
/A4: J2.8, U2.10 (PA05)
/A5: J1.3, U2.47 (PB02)
/D1: J2.4, U2.15 (PA10)
/D2: J2.7, U2.23 (PA14)
/D3: J2.6, U2.14 (PA09)
/D4: J2.11, U2.13 (PA08)
/D6: U1.1 (~CS), U2.29 (PA20)
/D7: IC2.3 (ENABLE), R3.2, U2.30 (PA21)
/D8: J1.2, U2.11 (PA06)
/D9: D1.2 (A), U2.12 (PA07)
/D10: J2.2, R20.2, U2.27 (PA18)
/D12: J2.1, U2.28 (PA19)
/MISO: J2.9, U1.2 (SO), U2.21 (PA12)
/MOSI: J2.3, U1.5 (SI), U2.19 (PB10)
/RXD: J1.7, U2.37 (PB22)
/RXLED: R4.1, U2.48 (PB03), U3.1 (WDI)
/SCK: J2.5, U1.6 (SCK), U2.20 (PB11)
/SCL: IC2.4 (BUS2), J1.12, Q2.3, R1.1, U2.32 (PA23)
/SCL_1V8: Q2.2, R17.1, U5.23 (SCL/SCLK)
/SDA: IC2.6 (BUS1), J1.11, Q1.3, R2.1, U2.31 (PA22)
/SDA_1V8: Q1.2, R18.1, U5.24 (SDA/SDI)
/SWDCLK: J4.3, R10.1, U2.45 (PA30)
/SWDIO: J4.2, U2.46 (PA31)
/TXD: J1.9, U2.38 (PB23)
/USB+: R5.1, U2.34 (PA25)
/USB-: R6.1, U2.33 (PA24)
/VBAT: C8.1, C14.1, J1.1, R7.1, TP3.1, U4.1 (VIN), U4.3 (EN), U6.1 (VIN), U6.3 (EN)
/~RESET: C13.1, R9.2, U2.40 (~RESET)
GND: C1.2, C2.1, C3.2, C4.1, C5.1, C6.1, C7.2, C8.2, C9.1, C10.2, C11.2, C12.1, C13.2, C14.2, C15.1, C16.2, IC2.2 (GND_1), IC2.5 (GND_2), J1.8, J1.10, J2.10, J2.12, J4.4, J5.1, J6.4, R3.1, R4.2, R8.2, R11.2, R15.2, TP2.1, U1.4 (GND), U2.5 (GNDANA), U2.18 (GND), U2.35 (GND), U2.42 (GND), U3.2 (GND), U4.2 (GND), U5.9 (AD0/SDO), U5.11 (FSYNC), U5.18 (GND), U5.20 (RESV_20), U6.2 (GND)
unnamed: D1.1 (K), R11.1
unnamed: J5.2, JP1.3 (B)
unnamed: J6.2, R5.2
unnamed: J6.3, R6.2
unnamed: JP1.1 (A), U3.7 (~WDO)
unnamed: JP1.2 (C), R9.1
unnamed: R12.1, U1.7 (~HOLD)
unnamed: R13.1, U1.3 (~WP)
unnamed: C2.2, R19.2, U2.1 (PA00), Y1.2
unnamed: C4.2, R19.1, U2.2 (PA01), Y1.1
unnamed: C12.2, U2.43 (VDDCORE)
unnamed: C16.1, U5.10 (REGOUT)
unnamed: R21.1, U5.22 (~CS)
VCC: C1.1, C3.1, C5.2, C6.2, C9.2, C10.1, C15.2, IC2.1 (VCC), J4.1, R1.2, R2.2, R10.2, R12.2, R13.2, R20.1, TP1.1, U1.8 (VDD), U2.6 (VDDANA), U2.17 (VDDIO), U2.36 (VDDIO), U2.44 (VDDIN), U3.4 (SET0), U3.5 (SET1), U3.6 (SET2), U3.8 (VCC), U4.5 (VOUT)
