Ironman-007/HexSense_Canary_Islands/PCB/CAMERA_ADAPTER/CAMERA_ADAPTER.kicad_pcb

## KiCad design PCB/CAMERA_ADAPTER/CAMERA_ADAPTER.kicad_pcb (2025-03-31)

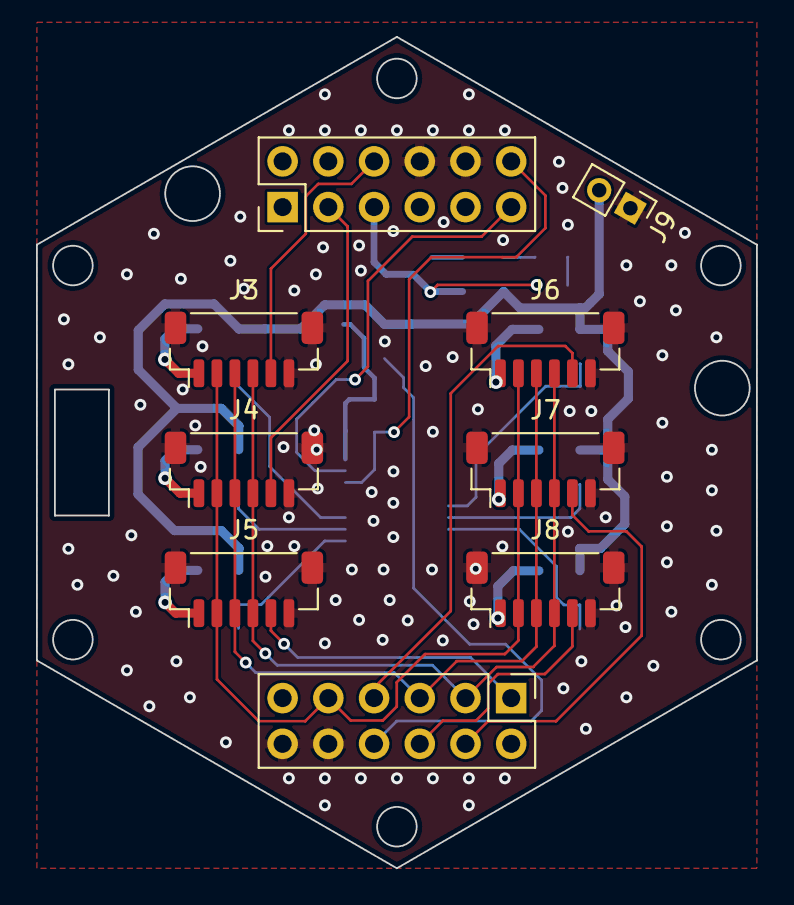
[picture p75: board CAMERA_ADAPTER.kicad_pcb from above]

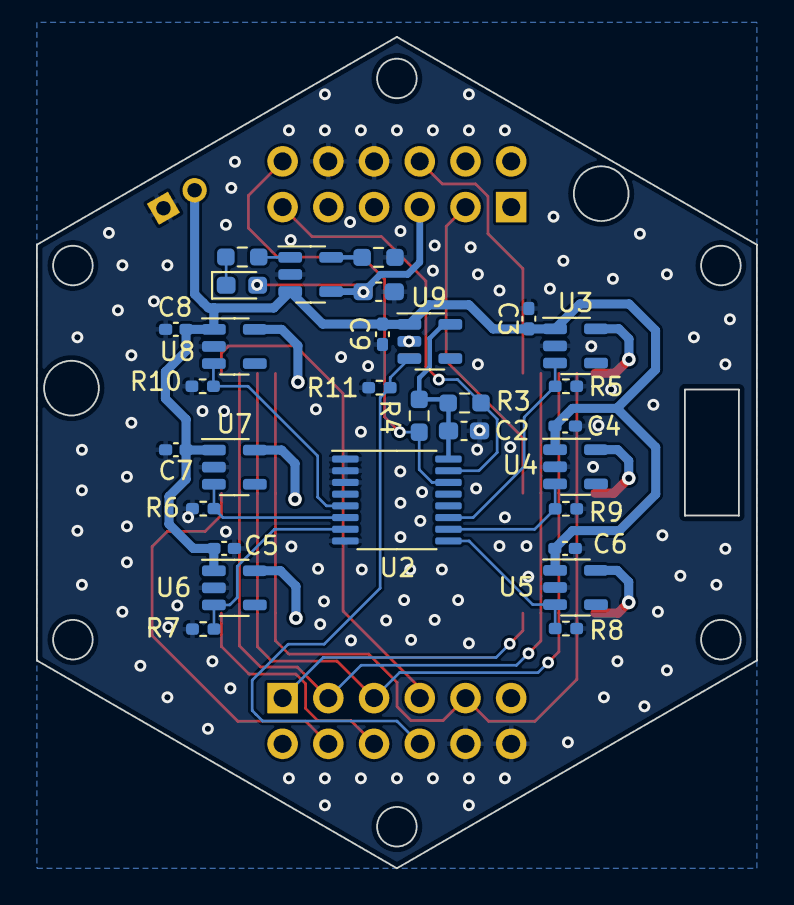
[picture p76: board CAMERA_ADAPTER.kicad_pcb from below]

Board: 2 copper layers, 40.0 x 46.2 mm, 39 parts (30 on the bottom side), 31 nets.

Parts:
C1, C2: 0.1uF; C_0603_1608Metric_Pad1.08x0.95mm_HandSolder
C3, C4, C5, C6, C7, C8, C9: 0.1uF; C_0402_1005Metric_Pad0.74x0.62mm_HandSolder
D1: RED; LED_0603_1608Metric_Pad1.05x0.95mm_HandSolder
J1, J2: Conn_02x06_Odd_Even; PinHeader_2x06_P2.54mm_Vertical
J3, J4, J5, J6, J7, J8: BM06B-SRSS-TBT(LF)(SN); JST_SH_BM06B-SRSS-TB_1x06-1MP_P1.00mm_Vertical
J9: Battery; PinHeader_1x02_P2.00mm_Vertical
R1: 10k; R_0603_1608Metric_Pad0.98x0.95mm_HandSolder
R2: 1k; R_0603_1608Metric_Pad0.98x0.95mm_HandSolder
R3, R4: NC; R_0603_1608Metric_Pad0.98x0.95mm_HandSolder
R5, R6, R7, R8, R9, R10, R11: 10k; R_0402_1005Metric_Pad0.72x0.64mm_HandSolder
U1: MCP73831-2-OT; SOT-23-5
U2: TCA9534; TSSOP-16_4.4x5mm_P0.65mm
U3, U4, U5, U6, U7, U8, U9: AP2112K-3.3; SOT-23-5

Connections:
+5V: C1.1, D1.2 (A), J1.5, U1.4 (VDD)
/A2: J1.6, J3.5
/A4: J2.8, R11.1, U9.3 (EN)
/A5: J1.3, J4.5
/CAM_BAT: C3.1, C4.1, C5.1, C6.1, C7.1, C8.1, C9.1, J9.2, U1.3 (VBAT), U3.1 (VIN), U4.1 (VIN), U5.1 (VIN), U6.1 (VIN), U7.1 (VIN), U8.1 (VIN), U9.1 (VIN)
/D1: J2.4, J7.5
/D2: J2.7, J6.5
/D3: J2.6, J8.5
/D12: J2.1, J5.5
/EN_1: R5.1, U2.11 (P6), U3.3 (EN)
/EN_2: R9.1, U2.10 (P5), U4.3 (EN)
/EN_3: R8.1, U2.9 (P4), U5.3 (EN)
/EN_4: R7.1, U2.7 (P3), U6.3 (EN)
/EN_5: R6.1, U2.6 (P2), U7.3 (EN)
/EN_6: R10.1, U2.5 (P1), U8.3 (EN)
/MISO: J2.9, J3.2, J4.2, J5.2, J6.2, J7.2, J8.2
/MOSI: J2.3, J3.4, J4.4, J5.4, J6.4, J7.4, J8.4
/SCK: J2.5, J3.3, J4.3, J5.3, J6.3, J7.3, J8.3
/SCL: J1.12, R4.2, U2.14 (SCL)
/SDA: J1.11, R3.2, U2.15 (SDA)
/V_CAM_1: J4.1, U4.5 (VOUT)
/V_CAM_2: J3.1, U3.5 (VOUT)
/V_CAM_3: J5.1, U5.5 (VOUT)
/V_CAM_4: J6.1, U8.5 (VOUT)
/V_CAM_5: J7.1, U7.5 (VOUT)
/V_CAM_6: J8.1, U6.5 (VOUT)
GND: C1.2, C2.2, C3.2, C4.2, C5.2, C6.2, C7.2, C8.2, C9.2, J1.8, J1.10, J2.10, J2.12, J3.6, J3.MP, J4.6, J4.MP, J5.6, J5.MP, J6.6, J6.MP, J7.6, J7.MP, J8.6, J8.MP, J9.1, R1.1, R5.2, R6.2, R7.2, R8.2, R9.2, R10.2, R11.2, U1.2 (VSS), U2.1 (A0), U2.2 (A1), U2.3 (A2), U2.8 (GND), U3.2 (GND), U4.2 (GND), U5.2 (GND), U6.2 (GND), U7.2 (GND), U8.2 (GND), U9.2 (GND)
unnamed: D1.1 (K), R2.2
unnamed: R1.2, U1.5 (PROG)
unnamed: R2.1, U1.1 (STAT)
VCC: C2.1, R3.1, R4.1, U2.16 (VDD), U9.5 (VOUT)
