Ironman-007/HexSense_Canary_Islands/PCB/LED_INDICATOR/V1/LED_INDICATOR.kicad_pcb

## KiCad design PCB/LED_INDICATOR/V1/LED_INDICATOR.kicad_pcb (2024-05-07)

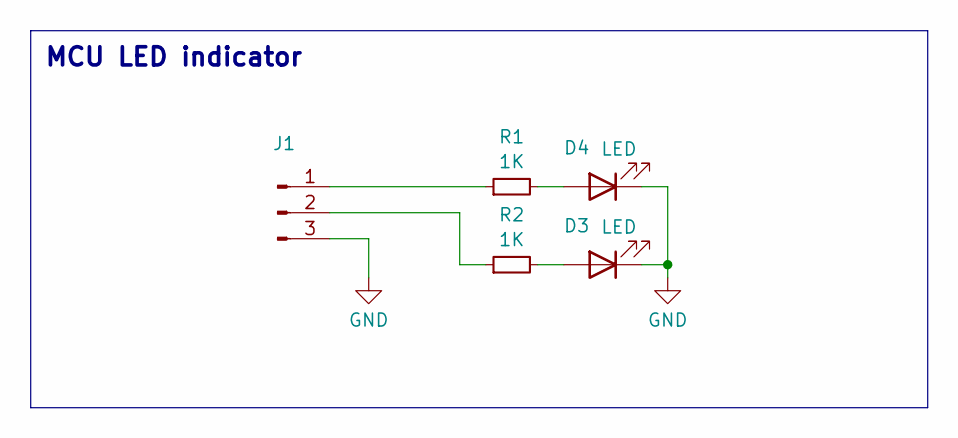
[picture p77: schematic LED_INDICATOR.kicad_sch, HexSense Svalbard - PWR]

Parts:
D3, D4: LED; LED_1206_3216Metric_Pad1.42x1.75mm_HandSolder
J1: Conn_01x03_Pin; Harwin_M20-89003xx_1x03_P2.54mm_Horizontal
R1, R2: 1K; R_1206_3216Metric_Pad1.30x1.75mm_HandSolder

Connections:
GND: D3.1 (K), D4.1 (K), J1.3
unnamed: D3.2 (A), R2.2
unnamed: D4.2 (A), R1.2
unnamed: J1.1, R1.1
unnamed: J1.2, R2.1

Notes on the sheet:
MCU LED indicator

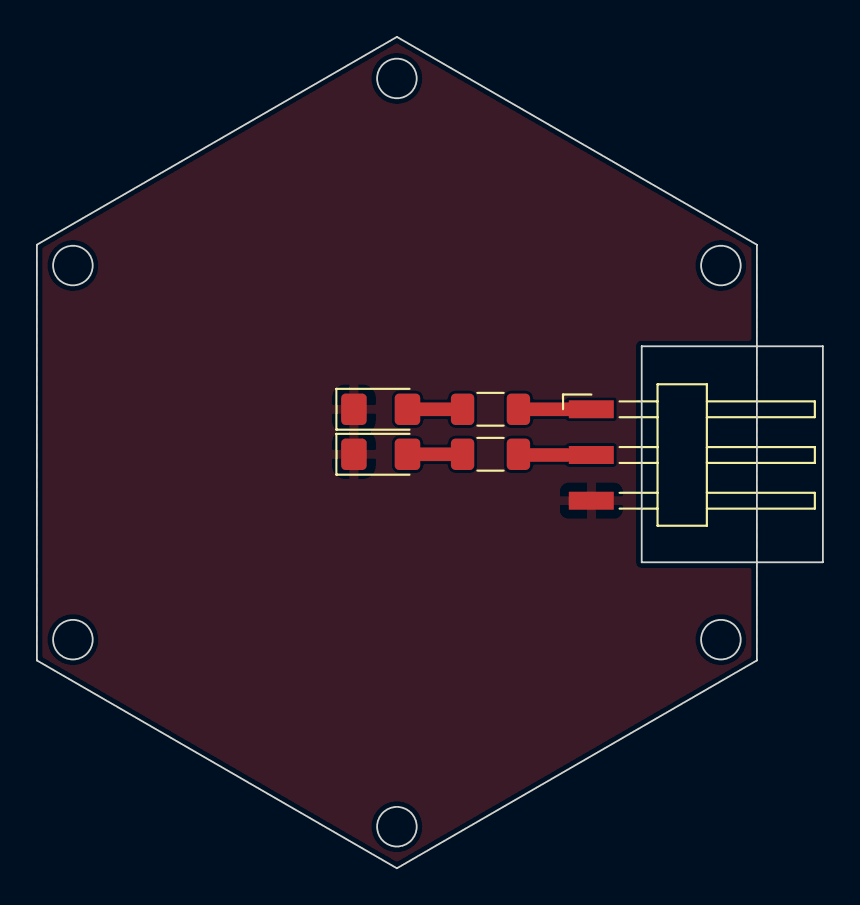
[picture p78: board LED_INDICATOR.kicad_pcb from above]

Board: 2 copper layers, 43.7 x 46.2 mm, 5 parts (0 on the bottom side), 5 nets.
