Ironman-007/HexSense_Canary_Islands/PCB/SCD30_ADAPTER/SCD30_ADAPTER.kicad_pcb

## KiCad design PCB/SCD30_ADAPTER/SCD30_ADAPTER.kicad_pcb (2024-01-29)

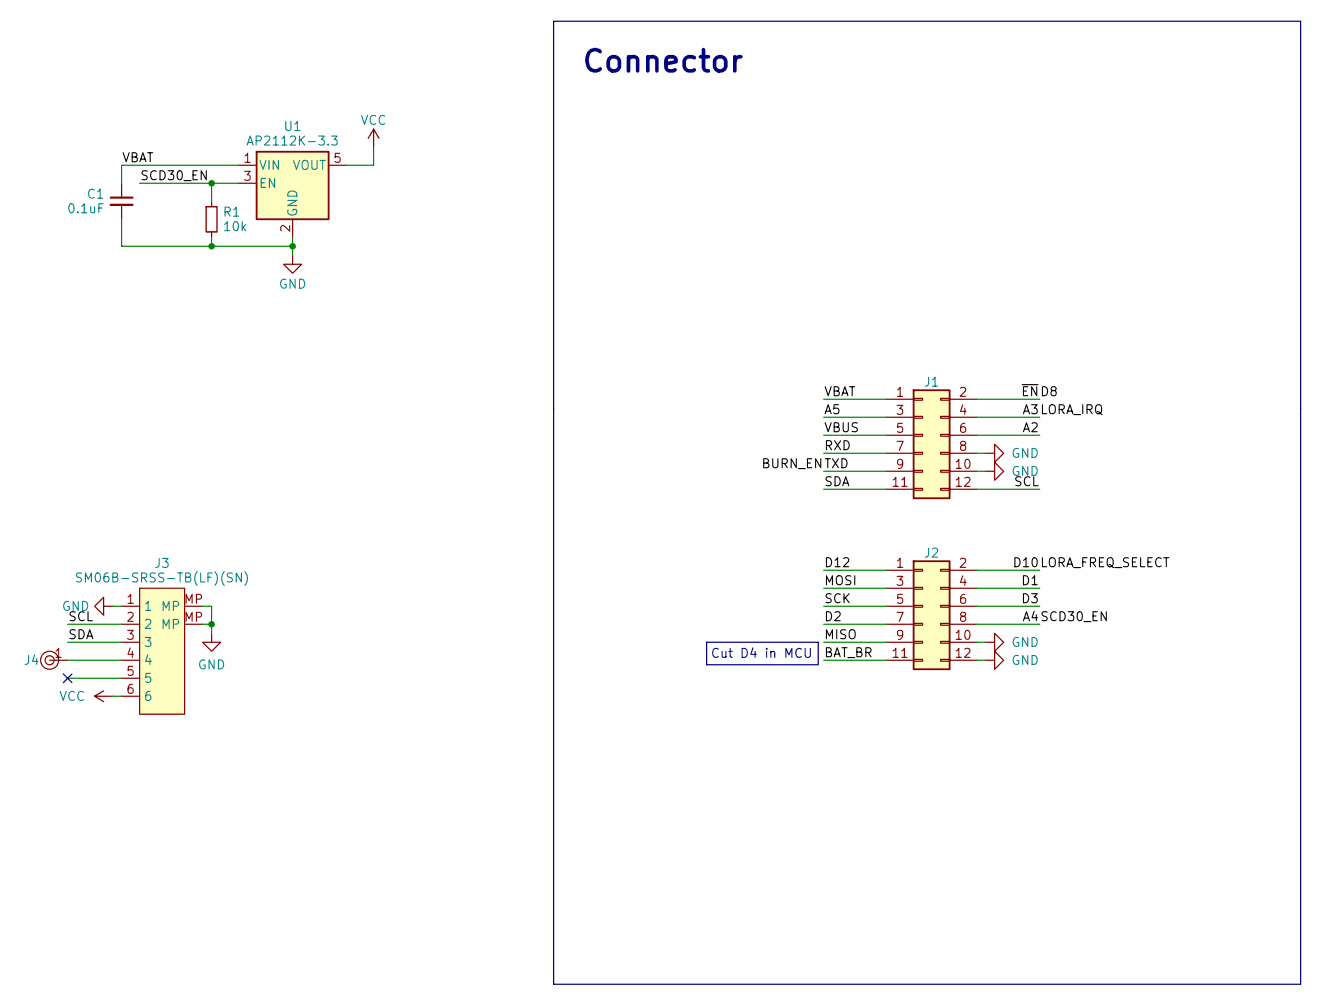
[picture p79: schematic SCD30_ADAPTER.kicad_sch, HexSense Svalbard - MCU module]

Parts:
C1: 0.1uF; C_0402_1005Metric_Pad0.74x0.62mm_HandSolder
J1, J2: Conn_02x06_Odd_Even; PinHeader_2x06_P2.54mm_Vertical
J3: SM06B-SRSS-TB(LF)(SN); JST_SH_SM06B-SRSS-TB_1x06-1MP_P1.00mm_Horizontal
J4: pin; PinHeader_1x01_P2.00mm_Vertical
R1: 10k; R_0402_1005Metric_Pad0.72x0.64mm_HandSolder
U1: AP2112K-3.3; SOT-23-5

Connections:
/A2: J1.6
/A3: J1.4
/A4: J2.8, R1.1, U1.3 (EN)
/A5: J1.3
/BAT_BR: J2.11
/BURN_EN: J1.9
/D1: J2.4
/D2: J2.7
/D3: J2.6
/D8: J1.2
/D10: J2.2
/D12: J2.1
/MISO: J2.9
/MOSI: J2.3
/RXD: J1.7
/SCK: J2.5
/SCL: J1.12, J3.2
/SDA: J1.11, J3.3
/VBAT: C1.1, J1.1, U1.1 (VIN)
/VBUS: J1.5
GND: C1.2, J1.8, J1.10, J2.10, J2.12, J3.1, J3.MP, R1.2, U1.2 (GND)
unnamed: J3.4, J4.1
VCC: J3.6, U1.5 (VOUT)

Notes on the sheet:
Connector
Cut D4 in MCU

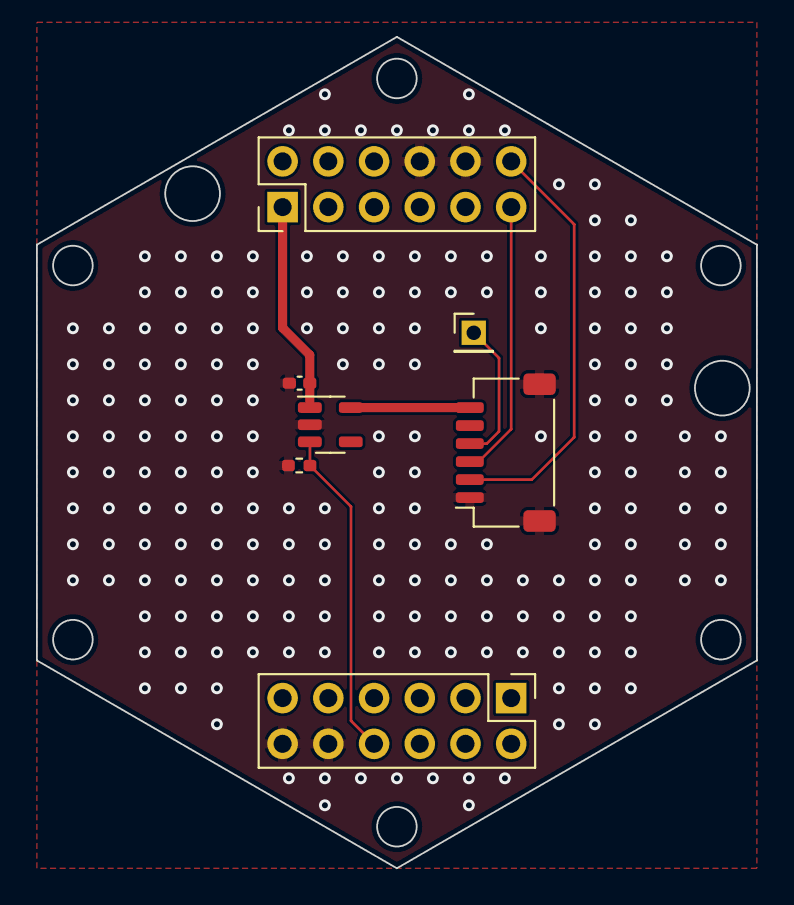
[picture p80: board SCD30_ADAPTER.kicad_pcb from above]

Board: 2 copper layers, 40.0 x 46.2 mm, 7 parts (0 on the bottom side), 7 nets.
