Ironman-007/HexSense_Canary_Islands/PCB/SIDE/V1/SIDE.kicad_pcb

## KiCad design PCB/SIDE/V1/SIDE.kicad_pcb (2024-01-23)

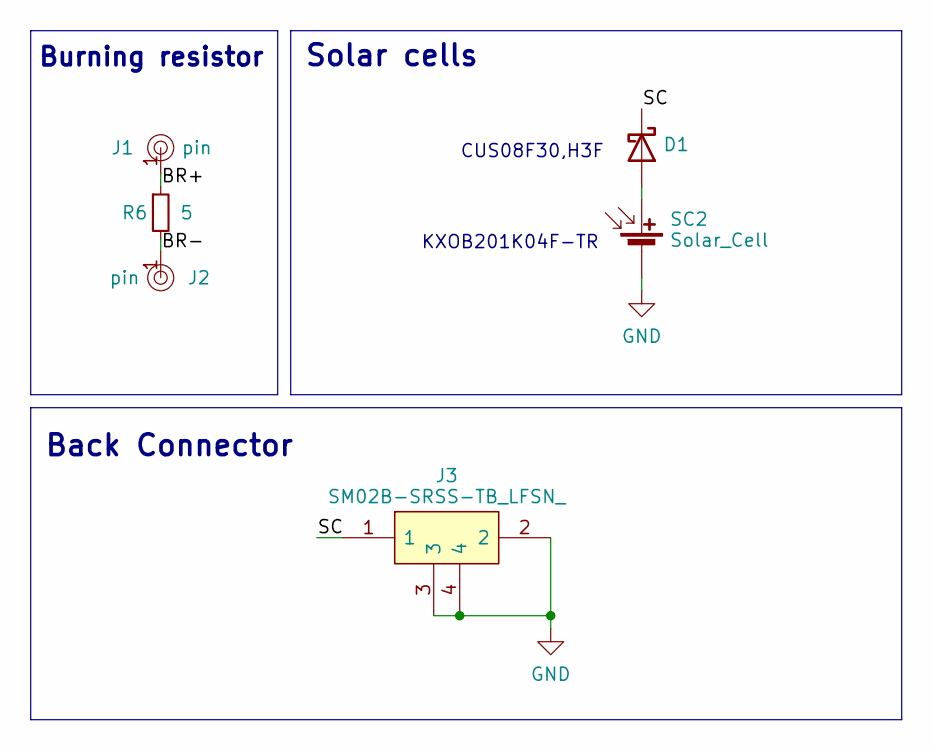
[picture p81: schematic SIDE.kicad_sch, HexSense Svalbard SIDE module]

Parts:
D1: D_Schottky; D_0805_2012Metric_Pad1.15x1.40mm_HandSolder
J1, J2: pin; 1_pin_SMD_1mmx1mm
J3: SM02B-SRSS-TB_LFSN_; SM02B-SRSS-TB; Manufacturer_Part_Number SM02B-SRSS-TB(LFSN)
R6: 5; R_Axial_DIN0207_L6.3mm_D2.5mm_P10.16mm_Horizontal
SC2: Solar_Cell; KXOB201K04F-TR

Connections:
/BR+: J1.1, R6.1
/BR-: J2.1, R6.2
/SC: D1.1 (K), J3.1
GND: J3.2, J3.3, J3.4, SC2.2 (-)
unnamed: D1.2 (A), SC2.1 (+)

Notes on the sheet:
Burning resistor
Back Connector
KXOB201K04F-TR
Solar cells
CUS08F30,H3F

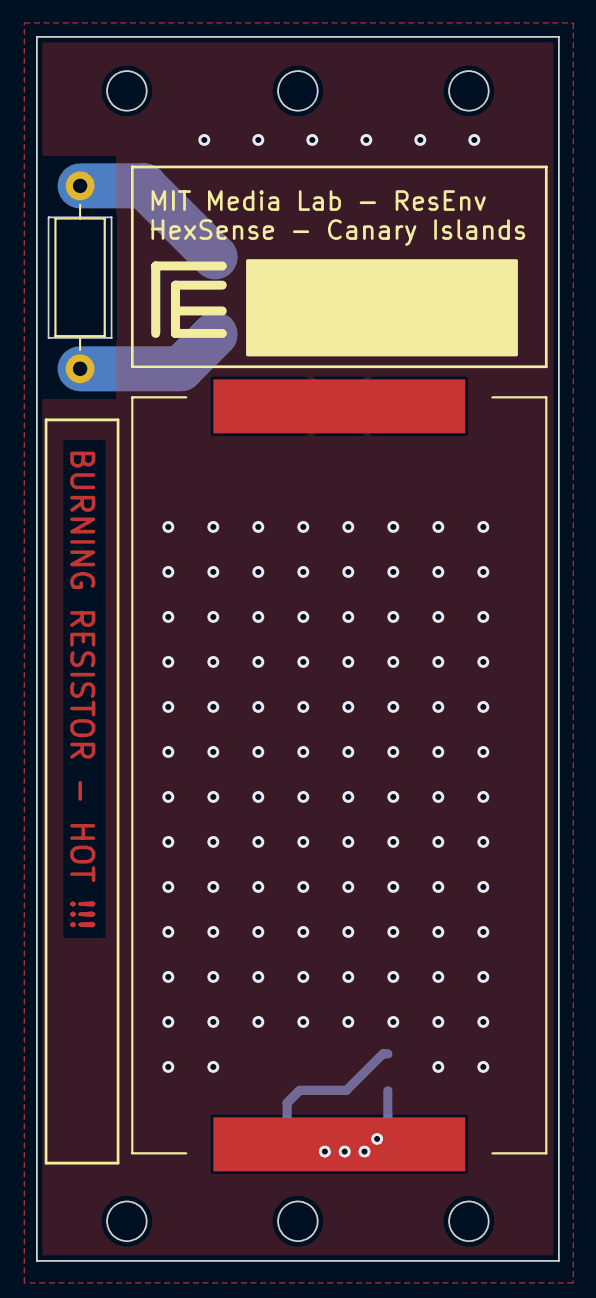
[picture p82: board SIDE.kicad_pcb from above]

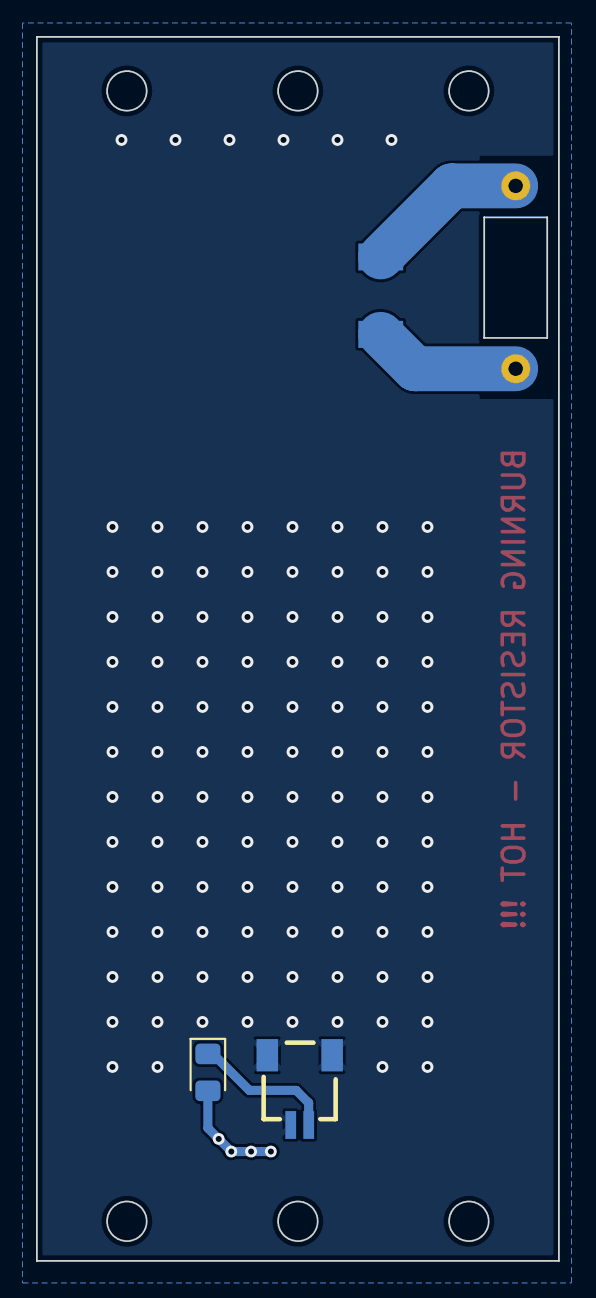
[picture p83: board SIDE.kicad_pcb from below]

Board: 2 copper layers, 29.0 x 68.0 mm, 6 parts (4 on the bottom side), 5 nets.
