Ironman-007/HexSense_Canary_Islands/PCB/CTRL/CTRL.kicad_pcb

## KiCad design PCB/CTRL/CTRL.kicad_pcb (2024-01-18)

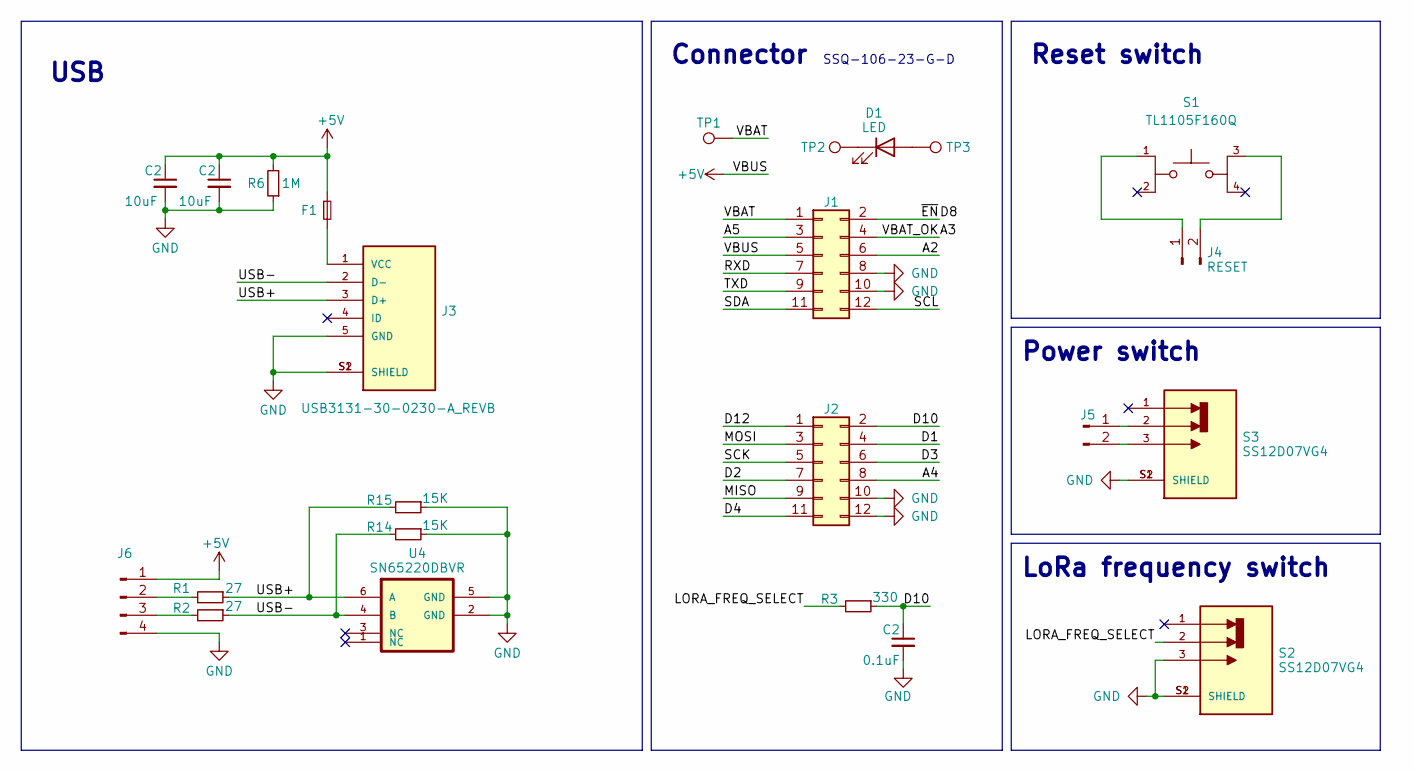
[picture p84: schematic CTRL.kicad_sch, HexSense Svalbard - MCU module]

Parts:
C2: 10uF; C_1206_3216Metric_Pad1.33x1.80mm_HandSolder
D1: LED; D_0603_1608Metric_Pad1.05x0.95mm_HandSolder
F1: Fuse_Small; Fuse_1206_3216Metric_Pad1.42x1.75mm_HandSolder
J1, J2: Conn_02x06_Odd_Even; PinHeader_2x06_P2.54mm_Vertical
J3: USB3131-30-0230-A_REVB; GCT_USB3131-30-0230-A_REVB; PARTREV B4
J4, J5: RESET; PinHeader_1x02_P2.00mm_Vertical
J6: Conn_01x04_Pin; PinHeader_1x04_P2.00mm_Vertical
R1, R2: 27; R_0402_1005Metric_Pad0.72x0.64mm_HandSolder
R3: 330; R_0402_1005Metric_Pad0.72x0.64mm_HandSolder
R6: 1M; R_0603_1608Metric_Pad0.98x0.95mm_HandSolder
R14, R15: 15K; R_0402_1005Metric_Pad0.72x0.64mm_HandSolder
S1: TL1105F160Q; SW_TL1105F160Q; PARTREV A
S2, S3: SS12D07VG4; SW_SS12D07VG4; PARTREV 1
TP1, TP2, TP3: TestPoint; TestPoint_Pad_1.5x1.5mm
U4: SN65220DBVR; SOT95P275X135-6N

Connections:
/A2: J1.6
/A3: J1.4
/A4: J2.8
/A5: J1.3
/D1: J2.4
/D2: J2.7
/D3: J2.6
/D4: J2.11
/D8: J1.2
/D12: J2.1
/LORA_FREQ_SELECT: R3.2, S2.2
/MISO: J2.9
/MOSI: J2.3
/RXD: J1.7
/SCK: J2.5
/SCL: J1.12
/SDA: J1.11
/TXD: J1.9
/USB+: J3.3 (D+), R1.1, R15.2, U4.6 (A)
/USB-: J3.2 (D-), R2.1, R14.2, U4.4 (B)
/VBAT: J1.1, TP1.1
GND: C2.2, J1.8, J1.10, J2.10, J2.12, J3.5 (GND), J3.S1 (SHIELD), J3.S2 (SHIELD), J6.4, R14.1, R15.1, S2.3, S2.S1 (SHIELD), S2.S2 (SHIELD), S3.S1 (SHIELD), S3.S2 (SHIELD), U4.2 (GND), U4.5 (GND); also elsewhere on the board
unnamed: D1.2 (A), TP3.1
unnamed: D1.1 (K), TP2.1
unnamed: F1.2, J3.1 (VCC)
unnamed: J4.1, S1.1
unnamed: J4.2, S1.3
unnamed: J5.1, S3.2
unnamed: J5.2, S3.3
unnamed: J6.2, R1.2
unnamed: J6.3, R2.2

Notes on the sheet:
Reset switch
LoRa frequency switch
USB
Connector
SSQ-106-23-G-D
Power switch

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
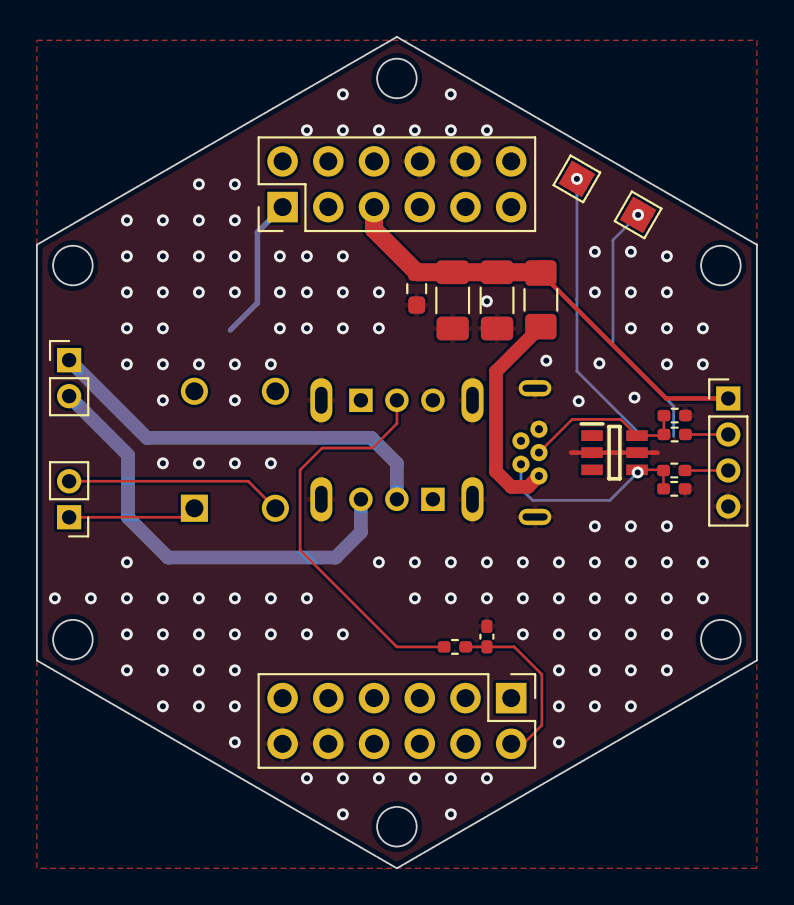
[picture p85: board CTRL.kicad_pcb from above]

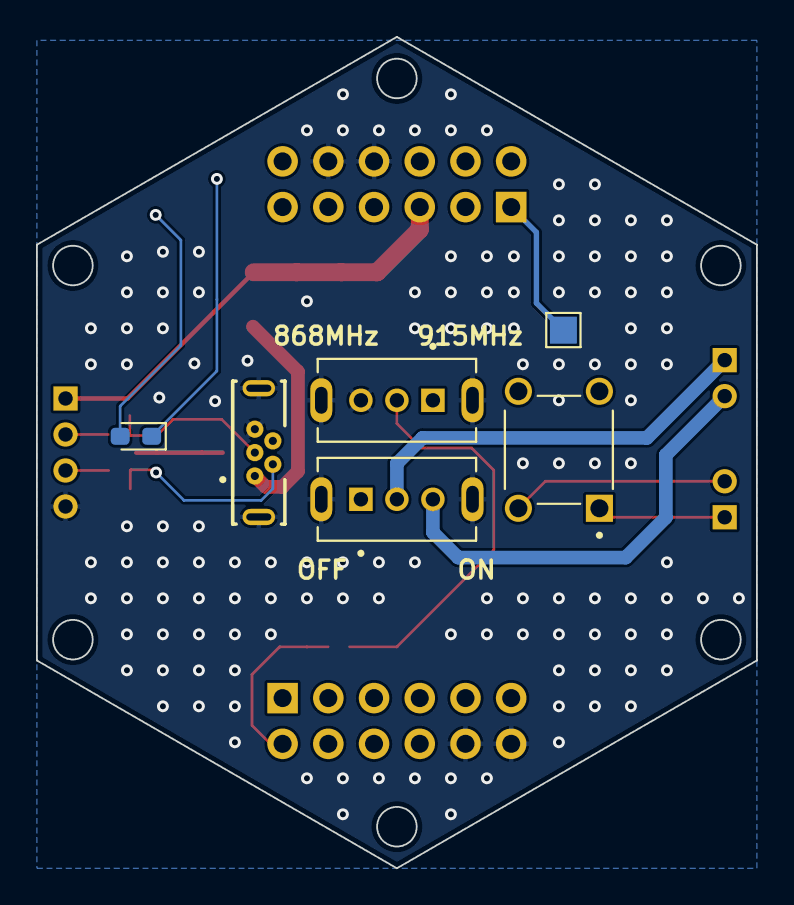
[picture p86: board CTRL.kicad_pcb from below]

Board: 2 copper layers, 40.0 x 46.2 mm, 24 parts (6 on the bottom side), 16 nets.

Other parts of the board:
C3: 10uF; C_1206_3216Metric_Pad1.33x1.80mm_HandSolder
C4: 0.1uF; C_0402_1005Metric_Pad0.74x0.62mm_HandSolder
R4: 1M; R_0603_1608Metric_Pad0.98x0.95mm_HandSolder

Their connections:
GND: C3.2, C4.2, R4.1; also elsewhere on the board
