Ironman-007/HexSense_Canary_Islands/Firmware/BOOTLOADER/Adafruit-Feather-M0-Basic-Proto-PCB-master/Adafruit Feather M0 Basic rev C.brd

## EAGLE design Firmware/BOOTLOADER/Adafruit-Feather-M0-Basic-Proto-PCB-master/Adafruit Feather M0 Basic rev C.brd (2024-01-25)


Parts:
C1, C7, C14: 1uF; 0603-NO
C2, C4: 22pF; 0603-NO
C3, C6, C8: 10µF; 0805-NO
C5: 10uF; 0805-NO
CHG: ORANGE; CHIPLED_0805_NOOUTLINE
D1: MBR120; SOD-123
JP1: HEADER-1X16ROUND; 1X16_ROUND
JP3: HEADER-1X12; 1X12_ROUND
L: RED; CHIPLED_0805_NOOUTLINE
R1, R3: 100k; 0603-NO
R2: 1K; 0603-NO
R6: 100K; 0603-NO
R7: 2.2K; 0603-NO
R8: 10K\; 0603-NO
SW1: SPST_TACT-KMR2; KMR2
TP1, TP2: TESTPOINTROUND1.5MM; TESTPOINT_ROUND_1.5MM
U2: SPX3819-3.3; SOT23-5
U3: MCP73831T-2ACI/OT; SOT23-5
U$4: ATSAMD21G18_QFN; TQFN48_7MM
U$31, U$32: MOUNTINGHOLE2.5; MOUNTINGHOLE_2.5_PLATED
U$34, U$35: FIDUCIAL""; FIDUCIAL_1MM
X1: JSTPH; JSTPH2
X2: 32.768; XTAL3215
X3: microUSB; 4UCONN_20329_V2

Connections:
!RESET: JP1.16, SW1.1, SW1.3 (P1), U$4.40 (/RESET)
+3V3: C5.1, C7.1, C8.1, JP1.15, U2.5 (OUT), U$4.6 (VDDA), U$4.17 (VDDIO), U$4.36 (VDDIO), U$4.44 (VDDIN)
A0: JP1.12, U$4.3 (PA02/EINT2/AIN0/Y0/VOUT)
A1: JP1.11, U$4.7 (PB08/I8/AIN2/SERCOM4.0)
A2: JP1.10, U$4.8 (PB09/I9/AIN3/SERCOM4.1)
A3: JP1.9, U$4.9 (PA04/EINT4/VREFB/AIN4/SERCOM0.0)
A4: JP1.8, U$4.10 (PA05/EINT5/AIN5/SERCOM0.1)
A5: JP1.7, U$4.47 (PB02/I2/AIN10/SERCOM5.0)
AREF: C14.1, JP1.14, U$4.4 (PA03/EINT3/VREFA/AIN1)
D0: JP1.3, U$4.16 (PA11/I11/AIN19/SERCOM0+2.3/I2SF0)
D1: JP1.2, U$4.15 (PA10/I10/AIN18/SERCOM0+2.2/I2SCK)
D2: U$4.23 (PA14/I14/SERCOM2+4.2)
D3: U$4.14 (PA09/I2C/I9/AIN17/SERCOM0+2.1/I2SMC)
D4: U$4.13 (PA08/I2C/AIN16/SERCOM0+2.0/I2SD1)
D5: JP3.10, U$4.24 (PA15/I15/SERCOM3+4.3)
D6: JP3.9, U$4.29 (PA20/I4/SERCOM3+5.2/I2SSC)
D7: U$4.30 (PA21/I5/SERCOM3+5.3/I2SFS0)
D8: U$4.11 (PA06/EINT6/AIN6/SERCOM0.2)
D9: JP3.8, R3.2, R6.1, U$4.12 (PA07/I7/AIN7/SERCOM0.3/I2SD0)
D10: JP3.7, U$4.27 (PA18/I2/SERCOM1+3.2)
D11: JP3.6, U$4.25 (PA16/I2C/I0/SERCOM1+3.0)
D12: JP3.5, U$4.28 (PA19/I3/SERCOM1+3.3/I2SD0)
D13: JP3.4, R7.1, U$4.26 (PA17/I2C/I1/SERCOM1+3.1)
D+: U$4.34 (PA25/I13/SERCOM3+5.3/D+), X3.D+
D-: U$4.33 (PA24/I12/SERCOM3+5.2/D-), X3.D-
EN: JP3.2, R1.2, U2.3 (EN)
GND: C1.2, C2.2, C3.2, C4.2, C5.2, C6.2, C7.2, C8.2, C14.2, JP1.1, JP1.13, L.C, R6.2, R8.2, SW1.2 (S), SW1.4 (S1), U2.2 (GND), U3.2 (VSS), U$4.5 (GNDA), U$4.18 (GND), U$4.35 (GND), U$4.42 (GND), U$4.THERMAL (GND), X1.1, X3.BASE@1 (GND), X3.BASE@2 (GND), X3.GND, X3.SPRT@1 (GND), X3.SPRT@2 (GND), X3.SPRT@3 (GND), X3.SPRT@4 (GND)
MISO: JP1.4, U$4.21 (PA12/I12/I2C/SERCOM2+4.0)
MOSI: JP1.5, U$4.19 (PB10/I10/SERCOM4.2/I2SMC)
unnamed: CHG.C, R2.1
unnamed: L.A, R7.2
unnamed: R2.2, U3.1 (STAT)
unnamed: R8.1, U3.5 (PROG)
unnamed: C2.1, U$4.1 (PA00/EINT0/SERCOM1.0), X2.P$1
unnamed: C4.1, U$4.2 (PA01/EINT1/SERCOM1.1), X2.P$2
SCK: JP1.6, U$4.20 (PB11/I11/SERCOM4.3/I2SCL)
SCL: JP3.11, U$4.32 (PA23/I2C/I7/SERCOM3+5.1/SOF)
SDA: JP3.12, U$4.31 (PA22/I2C/I6/SERCOM3+5.0)
SWCLK: TP1.P$1, U$4.45 (PA30/I10/SECOM1.2/SWCLK)
SWDIO: TP2.P$1, U$4.46 (PA31/I11/SECOM1.3/SWDIO)
VBAT: C3.1, D1.A, JP3.1, R3.1, U3.3 (VBAT), X1.2
VBUS: C6.1, CHG.A, D1.C, JP3.3, R1.1, U2.1 (IN), U3.4 (VDD), X3.VBUS
VDDCORE: C1.1, U$4.43 (VDDCORE)

Notes on the sheet:
POWER AND FILTERING
RESET
10K = 100mA
5.0K = 200mA
2.0K = 500mA
1.0K = 1000mA
N/C
TXLED
USBHOSTEN
RXLED
TXD
RXD
USB AND BATTERY CHARGING
BREAKOUTS
RED LED



Board: 2 copper layers, 50.8 x 22.9 mm, 37 parts (5 on the bottom side), 38 nets.

Other parts of the board:
U$7, U$12: ADAFRUIT_3.5MM
U$9: FEATHERLOGO
U$13: PCBFEAT-REV-040
