Ironman-007/HexSense_Canary_Islands/Firmware/AstroAnt_Bat/Ant_Canary_Tracking_IR_BK/src/comm.h

#pragma once

#include <Arduino.h>
#include <bluefruit.h>
#include <Adafruit_LittleFS.h>
#include <InternalFileSystem.h>

#include <pb_encode.h>
#include <pb_decode.h>

#include "ant_canary.pb.h"

extern volatile bool bleConnected;

extern uint8_t cmd_buffer[150];
extern uint8_t ping_buffer[150];

extern uint32_t seq_num_i;

class ANT_CANARY_RECV_CMD {
  public:
    ANT_CANARY_RECV_CMD(_CMD_RECV cmd, int32_t parameter) : recv_cmd(cmd), parameter(parameter) {}

    _CMD_RECV recv_cmd;
    int32_t   parameter;
};

// BLE Service
extern BLEDfu  bledfu;  // OTA DFU service
extern BLEDis  bledis;  // device information
extern BLEUart bleuart; // uart over ble
extern BLEBas  blebas;  // battery

extern void startAdv(void);

// callback invoked when central connects
extern void connect_callback(uint16_t conn_handle);

/**
 * Callback invoked when a connection is dropped
 * @param conn_handle connection where this event happens
 * @param reason is a BLE_HCI_STATUS_CODE which can be found in ble_hci.h
 */
extern void disconnect_callback(uint16_t conn_handle, uint8_t reason);

extern void ble_setup(void);

extern int decodecmd(const uint8_t* data, size_t size);

extern int get_recv_cmd(size_t size);

extern void handle_cmd(ANT_CANARY_RECV_CMD * cmd_recv);

extern void send_ack(_CMD_RECV cmd_recv, _ACK2SEND ack2send);

extern ANT_CANARY_RECV_CMD ant_canary_recv_cmd;

extern void ping_ack(void);
extern void IR_ack(void);
