Ironman-007/HexSense_Canary_Islands/(commit log)

2023-11-22 udated by FZ
    [PWR-B_Cu.gbr, PWR-B_Mask.gbr, PWR-B_Paste.gbr, PWR-B_Silkscreen.gbr, PWR-Edge_Cuts.gbr, PWR-F_Cu.gbr, PWR-F_Mask.gbr, PWR-F_Paste.gbr]
2024-02-05 auto stand work
    [BURNING_R.kicad_sch, CAMERA_ADAPTER.kicad_pcb, CAMERA_ADAPTER.kicad_sch, MCU.kicad_sch]
2024-02-09 Add MLX90640 tst for AstroAnt
    [Body1.3mf, jetsen_mount_adapter.3mf, paddle.3mf]
2024-02-09 Ant BLE working
    [adapter1.3mf, adapter2.3mf, adapter3.3mf, adapter4.3mf, camera_mount_front.3mf, camera_mount_rear.3mf, camera_mount_spacer.3mf]
2024-02-10 Ant IMU cali working
2024-02-10 Ant working, Ant_Canary_Tracking_IR
    [ant_container_box.3mf, ant_container_lid.3mf]
2024-02-12 Added Central firmware for Ant
    [90640_mount_v2.3mf, bottom_cap.3mf, spacer_5mm_M5.3mf]
2024-02-14 working on the camera firmware
2024-02-16 camera power on working
    [CAMERA_ADAPTER.kicad_sch, camera_module_frame.3mf]
2024-02-17 CAM_HEXSENSE_CANARY_V1 take photo, store FRAM, and read from FRAM works
    [CAMERA_ADAPTER.kicad_sch]
2024-02-17 CAM_HEXSENSE_CANARY_V1 two cameras working together
2024-02-17 CAM_HEXSENSE_CANARY_V1 all cameras working
    [CAMERA_ADAPTER.kicad_sch]
2024-05-07 added CAM_HEXSENSE_CANARY_V2
    [CONN.kicad_sch, CTRL.kicad_sch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]
2025-03-31 pc:working on stm32l476 mcu board
    [BURNING_R.kicad_pcb, BURNING_R.kicad_sch, CAMERA_ADAPTER.kicad_pcb, CAMERA_ADAPTER.kicad_sch, CONN.kicad_pcb, CTRL.kicad_sch, LORA.kicad_pcb, LORA.kicad_sch]
2025-04-01 mac:working on the stm32l476 mcu board
    [MCU.kicad_pcb, MCU.kicad_sch]
2025-04-01 mac: finishing the L476 mcu board
    [MCU.kicad_pcb, MCU.kicad_sch]
2025-04-01 pc:finished L476 MCU board
    [MCU.kicad_pcb, MCU.kicad_sch]
2025-04-01 mac: finishing the L476 mcu board design rule checking
    [MCU.kicad_pcb]
2025-04-01 mac: added esp32s3 mcu brd
    [MCU.kicad_pcb, MCU.kicad_sch]
2025-04-02 mac:working on esp32s3 mcu brd, forgot the strapping pins.
    [MCU.kicad_pcb, MCU.kicad_sch]
